eSpark-Backup/ezlo-thermostat/Design Files/4-R-layer-PCB.html

Altium customize

# Board Information Report

Date: | | 1/15/2023
Time: | | 7:51:56 PM
Elapsed Time: | | 00:00:01
Filename: | | C:\Users\XPENDER\Documents\GitHub\ezlo-thermostat\Design Files\4-R-layer-PCB.PcbDoc
Units: | | mmmils

## Contents

Contents

Board Specification

General

Routing

Routing Information

Layer Information

Layer Information

Drill Pairs

Copper Area

Copper Area

Board Holes

Non-Plated Hole Size

Plated Hole Size

Board Slots

Plated Slot Size

## Board Specification

General
Board Size | 3937.008mils x 3543.307mils
Components on board | 187

Back to top

## Routing

Routing Information
Routing completion | 100.00%
Connections | 505
Connections routed | 505
Connections remaining | 0

Back to top

## Layer Information

Layer | Arcs | Pads | Vias | Tracks | Texts | Fills | Regions | ComponentBodies
Top | 0 | 566 | 0 | 1223 | 0 | 57 | 30 | 0
PWR | 0 | 0 | 0 | 116 | 0 | 0 | 2 | 0
GND | 0 | 0 | 0 | 65 | 0 | 0 | 2 | 0
Bottom | 9 | 22 | 0 | 480 | 0 | 2 | 12 | 0
Dimension | 72 | 0 | 0 | 2 | 0 | 0 | 0 | 154
Board Outline | 4 | 0 | 0 | 21 | 0 | 0 | 0 | 0
Fabrication | 0 | 0 | 0 | 511 | 43 | 0 | 0 | 0
Mechanical 10 | 0 | 0 | 0 | 0 | 2 | 0 | 0 | 0
Mechanical 13 | 858 | 0 | 0 | 8133 | 0 | 0 | 0 | 7
Multi-Layer | 0 | 117 | 406 | 0 | 0 | 0 | 2 | 0
Top Paste | 0 | 0 | 0 | 0 | 0 | 0 | 0 | 0
Top Overlay | 3 | 0 | 0 | 987 | 401 | 20 | 4 | 0
Top Solder | 0 | 0 | 0 | 0 | 0 | 0 | 0 | 0
Bottom Solder | 0 | 0 | 0 | 0 | 0 | 0 | 0 | 0
Bottom Overlay | 0 | 0 | 0 | 3290 | 74 | 0 | 0 | 0
Bottom Paste | 0 | 0 | 0 | 0 | 0 | 0 | 0 | 0
Drill Guide | 0 | 0 | 0 | 0 | 0 | 0 | 0 | 0
Keep-Out Layer | 0 | 0 | 0 | 0 | 0 | 1 | 0 | 0
Drill Drawing | 3 | 0 | 0 | 84 | 128 | 0 | 0 | 0
Total | 949 | 705 | 406 | 14912 | 648 | 80 | 52 | 161

Back to top

Drill Pairs | Vias
Total | 0

Back to top

## Copper Area

Layer | Sq.In. | Sq.MM. | Percent of layer
Top | 6.827 | 4404.664 | 49%
PWR | 8.182 | 5278.624 | 59%
GND | 7.964 | 5137.798 | 57%
Bottom | 7.668 | 4947.076 | 55%
Total | 30.641 | 19768.162

Back to top

## Board Holes

Non-Plated Hole Size | Pads | Vias
0mils | 0 | 0
24.409mils | 0 | 0
35.433mils | 0 | 0
Total | 0 | 0

Back to top

Plated Hole Size | Pads | Vias
0mils | 0 | 0
11.811mils | 0 | 0
15.748mils | 0 | 0
31.496mils | 0 | 0
32.284mils | 0 | 0
35.433mils | 0 | 0
98.425mils | 0 | 0
Total | 0 | 0

Back to top

## Board Slots

Plated Slot Size / Length | Pads
23.622mil / 55.118mil | 0
23.622mil / 66.929mil | 0
Total | 0

Back to top
