eSpark-Backup/ezlo-thermostat/Design Files/Thermostat-PCB.html

Altium customize

# Board Information Report

Date: | | 1/6/2023
Time: | | 12:59:51 PM
Elapsed Time: | | 00:00:00
Filename: | | E:\ezlo-thermostat\Design Files\Thermostat-PCB.PcbDoc
Units: | | mmmils

## Contents

Contents

Board Specification

General

Routing

Routing Information

Layer Information

Layer Information

Drill Pairs

## Board Specification

General
Board Size | 3937.008mils x 3543.307mils
Components on board | 186

Back to top

## Routing

Routing Information
Routing completion | 99.80%
Connections | 505
Connections routed | 504
Connections remaining | 1

Back to top

## Layer Information

Layer | Arcs | Pads | Vias | Tracks | Texts | Fills | Regions | ComponentBodies
Top Layer | 0 | 566 | 0 | 1127 | 0 | 122 | 0 | 0
PWR | 4 | 0 | 0 | 20 | 0 | 2 | 1 | 0
GND | 4 | 0 | 0 | 20 | 0 | 2 | 1 | 0
Bottom Layer | 0 | 22 | 0 | 529 | 0 | 1 | 0 | 0
Mechanical 1 | 72 | 0 | 0 | 10 | 0 | 0 | 0 | 154
Mechanical 2 | 4 | 0 | 0 | 21 | 0 | 0 | 0 | 0
Mechanical 13 | 858 | 0 | 0 | 8135 | 0 | 0 | 0 | 7
Multi-Layer | 0 | 117 | 350 | 0 | 0 | 0 | 1 | 0
Top Paste | 0 | 0 | 0 | 0 | 0 | 0 | 0 | 0
Top Overlay | 3 | 0 | 0 | 976 | 330 | 20 | 0 | 0
Top Solder | 0 | 0 | 0 | 0 | 0 | 0 | 0 | 0
Bottom Solder | 0 | 0 | 0 | 0 | 0 | 0 | 0 | 0
Bottom Overlay | 0 | 0 | 0 | 220 | 44 | 0 | 0 | 0
Bottom Paste | 0 | 0 | 0 | 0 | 0 | 0 | 0 | 0
Drill Guide | 0 | 0 | 0 | 0 | 0 | 0 | 0 | 0
Keep-Out Layer | 0 | 0 | 0 | 0 | 0 | 1 | 0 | 0
Drill Drawing | 0 | 0 | 0 | 0 | 0 | 0 | 0 | 0
Total | 945 | 705 | 350 | 11058 | 374 | 148 | 3 | 161

Back to top

Drill Pairs | Vias
Total | 0

Back to top
