eSpark-Backup/ezlo-thermostat/Deliverables/Ezlo-Thermostat-v2.0-Advance/Renderings/3D_Top_View.png

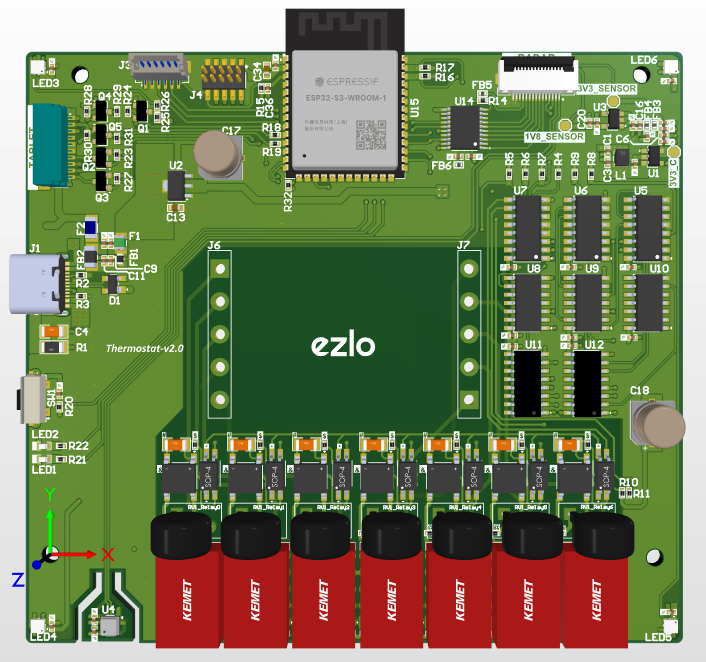
Deliverables/Ezlo-Thermostat-v2.0-Advance/Renderings/3D_Top_View.png
