eSpark-Backup/ezlo-thermostat/Deliverables/BOM/eSpark-BOM.xlsx

Sheet: 10 Boards
 |  | Component list |  | Bill of Materials for Project [Ezlo-Radar-Sensor]
 |  | Source Data From: |  | Ezlo-Radar-Sensor
 |  | Project: |  | Ezlo-Radar-Sensor
 |  | Variant: |  | None
# | Item Type | Designator | Description | Footprint | Manufacturer Part Number | Manufacturer | Alternate Part Number | LCSC Part Number | Value | Quantity | Quantity (10 Boards) | MOQ (10 Boards) | Links | Unit Cost (10 Boards) | Total Cost (10 Boards) | Remarks | Reviewer Remarks
1 | Capacitor | C1, C2, C4, C6, C8, C9, C10, C17 | CAP CER 1UF 10V X5R 0402 | Cap-0402 | CC0402KRX5R6BB105 | Yageo | - | C106254 | 1uF | 8 | 80 | 100 | LCSC (https://www.lcsc.com/product-detail/Multilayer-Ceramic-Capacitors-MLCC-SMD-SMT_YAGEO-CC0402KRX5R6BB105_C106254.html) | $0.0020 | $0.2000
2 | Capacitor | C3 | CAP CER 10000PF 25V X7R 0402 | Cap-0402 | CC0402KRX7R8BB103 | Yageo | - | C327025 | 10nF | 1 | 10 | 100 | LCSC (https://www.lcsc.com/product-detail/Multilayer-Ceramic-Capacitors-MLCC-SMD-SMT_YAGEO-CC0402KRX7R8BB103_C327025.html) | $0.0012 | $0.1200
3 | Capacitor | C5, C11 | CAP CER 22UF 10V X5R 0603 | Cap-0603 | CC0603MRX5R6BB226 | Yageo | - | C109447 | 22uF | 2 | 20 | 40 | LCSC (https://www.lcsc.com/product-detail/Multilayer-Ceramic-Capacitors-MLCC-SMD-SMT_YAGEO-CC0603MRX5R6BB226_C109447.html) | $0.0419 | $1.6760
4 | Capacitor | C7, C12, C14, C15 | CAP CER 10UF 10V X5R 0402 | Cap-0402 | CL05A106MP5NUNC | Samsung | - | C315248 | 10uF | 4 | 40 | 50 | LCSC (https://www.lcsc.com/product-detail/Multilayer-Ceramic-Capacitors-MLCC-SMD-SMT_Samsung-Electro-Mechanics-CL05A106MP5NUNC_C315248.html) | $0.0099 | $0.4950
5 | Capacitor | C13 | CAP CER 0.47UF 50V X5R 0402 | Cap-0402 | UMK105ABJ474KV-F | Taiyo Yuden | - | C386109 | 0.47uF | 1 | 10 | 20 | LCSC (https://www.lcsc.com/product-detail/Multilayer-Ceramic-Capacitors-MLCC-SMD-SMT_Taiyo-Yuden-UMK105ABJ474KV-F_C386109.html) | $0.0256 | $0.5120
6 | Capacitor | C16 | CAP CER 0.1UF 50V X7R 0402 | Cap-0402 | CL05B104KB54PNC | Samsung | - | C307331 | 0.1uF | 1 | 10 | 100 | LCSC (https://www.lcsc.com/product-detail/Multilayer-Ceramic-Capacitors-MLCC-SMD-SMT_Samsung-Electro-Mechanics-CL05B104KB54PNC_C307331.html) | $0.0066 | $0.6600
7 | Ferrite Bead | FB1, FB2, FB3, FB4, FB5, FB6, FB7 | FERRITE BEAD 120 OHM 0402 1LN | IND-0402 | BLM15PD121SN1D | Murata | - | C76891 | 100MHz | 7 | 70 | 100 | LCSC (https://www.lcsc.com/product-detail/Ferrite-Beads_Murata-Electronics-BLM15PD121SN1D_C76891.html) | $0.0057 | $0.5700
8 | FPC Connector | J1 | Clamshell 10 Bottom Contact Surface Mount 0.5mm SMD,P=0.5mm FFC/FPC Connectors ROHS | Custom | AFC01-S10FCC-00 | JUSHUO | - | C262266 | - | 1 | 10 | 61 | LCSC (https://www.lcsc.com/product-detail/FFC-FPC-Connectors_JUSHUO-AFC01-S10FCC-00_C262266.html) | $0.0915 | $5.5815
9 | MICROPHONE | Mk1 | Mic Omni-Directional -26dB 3.63V Rectangular Solder Pad T/R | Custom | ICS-43434 | TDK InvenSense |  |  |  | 1 | 10 | 11 |  |  | $0.0000
10 | Resistor | R1 | RES SMD 150 OHM 5% 1/10W 0402 | Res-0402 | ERJ-2GEJ151X | Panasonic | - | C412976 | 150R | 1 | 10 | 50 | LCSC (https://www.lcsc.com/product-detail/Chip-Resistor-Surface-Mount_PANASONIC-ERJ2GEJ151X_C412976.html) | $0.0042 | $0.2100
11 | IC | U1 | Rf Transceiver PG-VF2BGA-40 | pg-vf2bga-40 | BGT60TR13CE6327XUMA1 | Infineon | - |  | - | 1 | 10 | 11 |  |  | $0.0000
12 | IC | U2 | Integrated Gesture Recognition Sensor with I2C Interface | Custom | PAJ7620U2 | PixART Imaging Inc. |  |  |  | 1 | 10 | 11 |  |  | $0.0000
13 | Crystal | X1 | XTAL OSC XO 80.0000MHZ CMOS SMD | Custom | KC2016K80.0000C1GE00 | Kyocera AVX | - |  | 80MHz | 1 | 10 | 11 |  |  | $0.0000
 |  |  |  |  |  |  |  |  |  |  |  | Total Component Cost |  |  | $10.02
 |  |  |  |  |  |  |  |  |  |  |  | Single Board Cost |  |  | $1.00

Sheet: 1000 Boards
 |  | Component list |  | Bill of Materials for Project [Ezlo-Radar-Sensor]
 |  | Source Data From: |  | Ezlo-Radar-Sensor
 |  | Project: |  | Ezlo-Radar-Sensor
 |  | Variant: |  | None
# | Item Type | Designator | Description | Footprint | Manufacturer Part Number | Manufacturer | Alternate Part Number | LCSC Part Number | Value | Quantity | Quantity (1000 Boards) | MOQ (1000 Boards) | Links | Unit Cost (1000 Boards) | Total Cost (1000 Boards) | Remarks | Reviewer Remarks
1 | Capacitor | C1, C2, C4, C6, C8, C9, C10, C17 | CAP CER 1UF 10V X5R 0402 | Cap-0402 | CC0402KRX5R6BB105 | Yageo | - | C106254 | 1uF | 8 | 8000 | 8100 | LCSC (https://www.lcsc.com/product-detail/Multilayer-Ceramic-Capacitors-MLCC-SMD-SMT_YAGEO-CC0402KRX5R6BB105_C106254.html) | $0.0014 | $11.3400
2 | Capacitor | C3 | CAP CER 10000PF 25V X7R 0402 | Cap-0402 | CC0402KRX7R8BB103 | Yageo | - | C327025 | 10nF | 1 | 1000 | 1100 | LCSC (https://www.lcsc.com/product-detail/Multilayer-Ceramic-Capacitors-MLCC-SMD-SMT_YAGEO-CC0402KRX7R8BB103_C327025.html) | $0.0009 | $0.9900
3 | Capacitor | C5, C11 | CAP CER 22UF 10V X5R 0603 | Cap-0603 | CC0603MRX5R6BB226 | Yageo | - | C109447 | 22uF | 2 | 2000 | 2060 | LCSC (https://www.lcsc.com/product-detail/Multilayer-Ceramic-Capacitors-MLCC-SMD-SMT_YAGEO-CC0603MRX5R6BB226_C109447.html) | $0.0312 | $64.2720
4 | Capacitor | C7 | CAP CER 10UF 10V X5R 0603 | Cap-0603 | CC0603KRX5R6BB106 | Yageo | - | C326057 | 10uF | 1 | 1000 | 1060 | LCSC (https://www.lcsc.com/product-detail/Multilayer-Ceramic-Capacitors-MLCC-SMD-SMT_YAGEO-CC0603KRX5R6BB106_C326057.html) | $0.0173 | $18.3380
5 | Capacitor | C12, C14, C15 | CAP CER 10UF 10V X5R 0402 | Cap-0402 | CL05A106MP5NUNC | Samsung | - | C315248 | 10uF | 3 | 3000 | 3050 | LCSC (https://www.lcsc.com/product-detail/Multilayer-Ceramic-Capacitors-MLCC-SMD-SMT_Samsung-Electro-Mechanics-CL05A106MP5NUNC_C315248.html) | $0.0068 | $20.7400
6 | Capacitor | C13 | CAP CER 0.47UF 50V X5R 0402 | Cap-0402 | UMK105ABJ474KV-F | Taiyo Yuden | - | C386109 | 0.47uF | 1 | 1000 | 1080 | LCSC (https://www.lcsc.com/product-detail/Multilayer-Ceramic-Capacitors-MLCC-SMD-SMT_Taiyo-Yuden-UMK105ABJ474KV-F_C386109.html) | $0.0178 | $19.2564
7 | Capacitor | C16 | CAP CER 0.1UF 50V X7R 0402 | Cap-0402 | CL05B104KB54PNC | Samsung | - | C307331 | 0.1uF | 1 | 1000 | 1100 | LCSC (https://www.lcsc.com/product-detail/Multilayer-Ceramic-Capacitors-MLCC-SMD-SMT_Samsung-Electro-Mechanics-CL05B104KB54PNC_C307331.html) | $0.0056 | $6.1600
8 | Ferrite Bead | FB1, FB2, FB3, FB4, FB5, FB6, FB7 | FERRITE BEAD 120 OHM 0402 1LN | IND-0402 | BLM15PD121SN1D | Murata | - | C76891 | 100MHz | 7 | 7000 | 7100 | LCSC (https://www.lcsc.com/product-detail/Ferrite-Beads_Murata-Electronics-BLM15PD121SN1D_C76891.html) | $0.0041 | $29.1100
9 | FPC Connector | J1 | Clamshell 10 Bottom Contact Surface Mount 0.5mm SMD,P=0.5mm FFC/FPC Connectors ROHS | Custom | AFC01-S10FCC-00 | JUSHUO | - | C262266 | - | 1 | 1000 | 1098 | LCSC (https://www.lcsc.com/product-detail/FFC-FPC-Connectors_JUSHUO-AFC01-S10FCC-00_C262266.html) | $0.0744 | $81.6912
10 | MICROPHONE | Mk1 | Mic Omni-Directional -26dB 3.63V Rectangular Solder Pad T/R | Custom | ICS-43434 | TDK InvenSense |  |  |  | 1 | 1000 |  |  |  | $0.0000
11 | Resistor | R1 | RES SMD 150 OHM 5% 1/10W 0402 | Res-0402 | ERJ-2GEJ151X | Panasonic | - | C412976 | 150R | 1 | 1000 | 1050 | LCSC (https://www.lcsc.com/product-detail/Chip-Resistor-Surface-Mount_PANASONIC-ERJ2GEJ151X_C412976.html) | $0.0035 | $3.6750
12 | IC | U1 | Rf Transceiver PG-VF2BGA-40 | pg-vf2bga-40 | BGT60TR13CE6327XUMA1 | Infineon | - |  | - | 1 | 1000 |  |  |  | $0.0000
13 | IC | U2 | Integrated Gesture Recognition Sensor with I2C Interface | Custom | PAJ7620U2 | PixART Imaging Inc. |  |  |  | 1 | 1000 |  |  |  | $0.0000
14 | Crystal | X1 | XTAL OSC XO 80.0000MHZ CMOS SMD | Custom | KC2016K80.0000C1GE00 | Kyocera AVX | - |  | 80MHz | 1 | 1000 |  |  |  | $0.0000
 |  |  |  |  |  |  |  |  |  |  |  | Total Component Cost |  |  | $255.57
 |  |  |  |  |  |  |  |  |  |  |  | Single Board Cost |  |  | $25.56
