eSpark-Backup/ezlo-thermostat/Design Files/Ezlo-Radar-Sensor-v2.0-Advance/BOM/Client_BOM.xlsx

# | Item Type | Designator | Description | Footprint | Manufacturer Part Number | Manufacturer | Value | Quantity | Remarks
1 | Capacitor | C1, C2, C4, C6, C8, C9, C10, C17, C22 | CAP CER 1UF 10V X5R 0402 | Cap-0402 | CC0402KRX5R6BB105 | Yageo | 1uF | 9
2 | Capacitor | C3 | CAP CER 10000PF 25V X7R 0402 | Cap-0402 | CC0402KRX7R8BB103 | Yageo | 10nF | 1
3 | Capacitor | C5, C11, C18 | CAP CER 22UF 10V X5R 0603 | Cap-0603 | CC0603MRX5R6BB226 | Yageo | 22uF | 3
4 | Capacitor | C7, C12, C14, C15, C19 | CAP CER 10UF 10V X5R 0402 | Cap-0402 | CL05A106MP5NUNC | Samsung | 10uF | 5
5 | Capacitor | C13 | CAP CER 0.47UF 50V X5R 0402 | Cap-0402 | UMK105ABJ474KV-F | Taiyo Yuden | 0.47uF | 1
6 | Capacitor | C16, C20, C21, C23 | CAP CER 0.1UF 50V X7R 0402 | Cap-0402 | CL05B104KB54PNC | Samsung | 0.1uF | 4
7 | Ferrite Bead | FB1, FB2, FB3, FB4, FB5, FB6, FB7 | FERRITE BEAD 120 OHM 0402 1LN | IND-0402 | BLM15PD121SN1D | Murata | 100MHz | 7
8 | FPC Connector | J1 | Clamshell 15 Bottom Contact Surface Mount 0.5mm SMD,P=0.5mm FFC/FPC Connectors ROHS | - | AFC01-S15FCC-00 | JUSHUO | - | 1
9 | MICROPHONE | Mk1 | Mic Omni-Directional -26dB 3.63V Rectangular Solder Pad T/R | - | ICS-43434 | TDK InvenSense | - | 1
10 | Resistor | R1 | RES SMD 150 OHM 5% 1/10W 0402 | Res-0402 | ERJ-2GEJ151X | Panasonic | 150R | 1
11 | IC | U1 | Rf Transceiver PG-VF2BGA-40 | pg-vf2bga-40 | BGT60TR13CE6327XUMA1 | Infineon | - | 1
12 | IC | U2 | Integrated Gesture Recognition Sensor with I2C Interface | - | PAJ7620U2 | PixART Imaging Inc. | - | 1
13 | Crystal | X1 | XTAL OSC XO 80.0000MHZ CMOS SMD | - | KC2016K80.0000C1GE00 | Kyocera AVX | 80MHz | 1
14 | peripheral | - | 15 0.5mm Same Side 120mm P=0.5mm FFC/FPC Connect Cables ROHS | - | KH-FFC-A0.5-15P-120MM | Shenzhen Kinghelm Elec | - | 1
