eSpark-Backup/ezlo-thermostat/Design Files/Ezlo-Thermostat-v2.0-Advance/BOM/Client_BOM.xlsx

# | Item Type | Designator | Description | Footprint | Manufacturer Part Number | Manufacturer | Value | Quantity | Remarks
1 | Bridge Rectifier | BR1_Relay0, BR1_Relay1, BR1_Relay2, BR1_Relay3, BR1_Relay4, BR1_Relay5, BR1_Relay6 | 5uA@1kV 1V@0.4A 1A 1kV -55℃~+150℃@(Tj) ABS Bridge Rectifiers ROHS | ABS | ABS10 | FOSAN | - | 7
2 | Capacitor | C1, C3, C6, C16, C20 | CAP CER 10UF 10V X5R 0402 | Cap-0402 | CC0402MRX5R6BB106 | Yageo | 10uF | 5
3 | Capacitor | C2, C5, C7, C8, C10, C12, C14, C15, C19, C21, C22, C23, C24, C25, C26, C27, C28, C29, C30, C32, C33, C35, C37, C38, C39, C40, C41 | CAP CER 0.1UF 25V X5R 0402 | Cap-0402 | CC0402KRX5R8BB104 | Yageo | 100nF | 27
4 | Capacitor | C4 | CAP CER 4700PF 50V C0G/NPO 1206 | Cap-1206 | CC1206GRNPO9BN472 | Yageo | 4.7nF | 1
5 | Capacitor | C9, C11 | CAP CER 10000PF 25V X5R 0402 | Cap-0402 | CC0402KRX5R8BB103 | Yageo | 0.01uF | 2
6 | Capacitor | C13 | CAP CER 10UF 16V X5R 0603 | Cap-0603 | CC0603KRX5R7BB106 | Yageo | 10uF | 1
7 | Capacitor | C17, C18 | CAP ALUM 100UF 20% 10V SMD | Custom | UCD1A101MCL1GS | Nichicon | 100uF | 2
8 | Capacitor | C31_Relay0, C31_Relay1, C31_Relay2, C31_Relay3, C31_Relay4, C31_Relay5, C31_Relay6 | 50V 220nF X7R ±10% 1206 Multilayer Ceramic Capacitors MLCC - SMD/SMT ROHS | Cap-1206 | 1206B224K500NT | FH | 220nF | 7
9 | Capacitor | C34 | CAP CER 22UF 6.3V X5R 0603 | Cap-0603 | CC0603MRX5R5BB226 | Yageo | 22uF | 1
10 | Capacitor | C36 | CAP CER 1UF 25V X5R 0402 | Cap-0402 | CC0402KRX5R8BB105 | Yageo | 1uF | 1
11 | Diode | D1 | ESD Suppressor TVS 5.5V 4-Pin(3+Tab) SOT-143 T/R | SOT-143-4_ | SP0503BAHTG | Littelfuse | - | 1
12 | Fuse | F1 | 6V 1A 100A 1.95A 300ms 0805 Resettable Fuses ROHS | Fuse-0805 | JK-SMD0805-100 | Jinrui Electronic Materials Co. | - | 1
13 | Fuse | F2 | 6V 2A 100A 0.8W 3.5A -40℃~+85℃ 0.018Ω 1.5s 0.08Ω 1206 Resettable Fuses ROHS | Fuse 1206 (3216 Metric) | SMD1206K200SF6V | KAILONG | - | 1
14 | Ferrite Bead | FB1 | FERRITE BEAD 120 OHM 0603 1LN | IND-0603 (1608 Metric) | BLM18SG121TN1D | Murata | - | 1
15 | Ferrite Bead | FB2 | FERRITE BEAD 120 OHM 1206 1LN | IND-1206 | BLM31PG121SN1L | Murata | 100MHz | 1
16 | Ferrite Bead | FB3, FB4, FB5, FB6 | FERRITE BEAD 120 OHM 0402 1LN | IND-0402 | BLM15PD121SN1D | Murata | 100MHz | 4
17 | USB Connector | J1 | 250mA 1 16 Female Type-C SMD USB Connectors ROHS | Custom | TYPE-C-31-M-12 | Korean Hroparts Elec | - | 1
18 | FPC Connector | J2 | Clamshell 15 Bottom Contact Surface Mount 0.5mm SMD,P=0.5mm FFC/FPC Connectors ROHS | Custom | AFC01-S15FCC-00 | JUSHUO | - | 1
19 | Connector | J3 | 1x6P SH 1 1mm 6 SMD,P=1mm Wire To Board / Wire To Wire Connector ROHS | Custom | C145963 | BOOMELE | - | 1
20 | Jtag Header | J4 | CONN HEADER SMD 10POS 1.27MM | Custom | 20021121-00010C4LF | Amphenol FCI | - | 1
21 | JST Connector | J5 | CONN HEADER SMD R/A 10POS 1MM | Custom | SM10B-SRSS-TB(LF)(SN) | JST | - | 1
22 | Header | J6 | PinHeader_1x05_P5.00mm_Vertical | Custom | - |  | - | 1
23 | Header | J7 | PinHeader_1x05_P5.00mm_Vertical | Custom | - |  | - | 1
24 | Relay | K1_Relay0, K1_Relay1, K1_Relay2, K1_Relay3, K1_Relay4, K1_Relay5, K1_Relay6 | Relay Gen Purpose DPDT 1A 3VDC | Custom | EA2-3TNU | KEMET | - | 7
25 | Inductor | L1 | FIXED IND 10UH 1A 540 MOHM SMD | IND-1008 (2520 Metric) | VLS252012HBX-100M-1 | TDK | 10uH | 1
26 | LED | LED1 | Red 632nm LED Indication - Discrete 2.05V 0603 (1608 Metric) | LED-0603 | 19-21/R7C-AK1L2BY/3T | Everlight Elec | - | 1
27 | LED | LED2 | Yellow-Green 572nm LED Indication - Discrete 2.05V 0603 (1608 Metric) | LED-0603 | 19-21/G6C-FM1N2B/3T | Everlight Elec | - | 1
28 | RGB LED | LED3, LED4, LED5, LED6 | 5mA -40℃~+80℃ RGB SMD,2x2mm Light Emitting Diodes (LED) ROHS | Custom | SK6812-EC20 | OPSCO Optoelectronics | - | 4
29 | ~~Test Point~~ | ~~P1, P2, P3, P4, P5, P6, P7, P8, P9, P10, P11, P12, P13, P14, P15, P16, P17, P18, P19, P20, P21, P22, P23, P24, P25~~ | ~~Test Point ON~~ | ~~Custom~~ | ~~Test-point~~ |  | ~~-~~ | ~~25~~
30 | Mosfet | Q1, Q2, Q3, Q4, Q5 | N-CHANNEL 20-V (D-S) MOSFET | Sot-23 | SI2302CDS | TECH PUBLIC | - | 5
31 | Resistor | R1 | RES 1M OHM 1% 1/4W 1206 | Res-1206 | RC1206FR-071ML | Yageo | 1M | 1
32 | Resistor | R2, R3 | RES 5.1K OHM 1% 1/16W 0402 | Res-0402 | RC0402FR-075K1L | Yageo | 5.1K | 2
33 | Resistor | R4, R5, R6, R7, R8, R9, R10, R15, R20, R23, R27, R32 | RES 220K OHM 1% 1/16W 0402 | Res-0402 | RC0402FR-07220KL | Yageo | 220K | 12
34 | Resistor | R11 | RES 47K OHM 1% 1/16W 0402 | Res-0402 | RC0402FR-0747KL | Yageo | 47K | 1
35 | Resistor | R12_Relay0, R12_Relay1, R12_Relay2, R12_Relay3, R12_Relay4, R12_Relay5, R12_Relay6 | RES 47 OHM 1% 1/16W 0402 | Res-0402 | RC0402FR-0747RL | Yageo | 47R | 7
36 | Resistor | R13_Relay0, R13_Relay1, R13_Relay2, R13_Relay3, R13_Relay4, R13_Relay5, R13_Relay6 | RES 100K OHM 1% 1/16W 0402 | Res-0402 | RC0402FR-07100KL | Yageo | 100K | 7
37 | Resistor | R14 | RES 0 OHM JUMPER 1/16W 0402 | Res-0402 | RC0402FR-070RL | Yageo | 0R | 1
38 | Resistor | R16, R17 | RES 4.7K OHM 1% 1/16W 0402 | Res-0402 | RC0402FR-074K7L | Yageo | 4.7K | 2
39 | Resistor | R18, R19 | RES 22 OHM 1% 1/16W 0402 | Res-0402 | RC0402FR-0722RL | Yageo | 22R | 2
40 | Resistor | R21, R22, R26 | RES 1K OHM 1% 1/16W 0402 | Res-0402 | RC0402FR-071KL | Yageo | 1K | 3
41 | Resistor | R24, R25, R28, R29, R30, R31 | RES 10K OHM 1% 1/16W 0402 | Res-0402 | RC0402FR-0710KL | Yageo | 10K | 6
42 | Varistor | RV1_Relay0, RV1_Relay1, RV1_Relay2, RV1_Relay3, RV1_Relay4, RV1_Relay5, RV1_Relay6 | VARISTOR 68V 500A DISC 7MM | Custom | ERZ-V07D680 | Panasonic | - | 7
43 | Tactile Switch | SW1 | 3.5mm 3.5mm SMDSplicing Black Rectangle button 50mA Surface Mount 7mm SPST 100MΩ 20000 12V 250gf@±50gf SMD Tactile Switches ROHS | Custom | YTS-B003-2A | YIYUAN | - | 1
44 | IC | U1 | Linear Voltage Regulator IC Positive Fixed 1 Output 3.3V 1A SOT-25 | SOT-25-5 | XC6220B331MR-G | Torex | - | 1
45 | IC | U2 | 600mA 60dB 500mV@(600mA) Fixed 3.3V~3.3V Positive 1 7V SOT-89(SOT-89-3) Linear Voltage Regulators (LDO) ROHS | SOT-89-3 | LR1107G-33-AB3-C-R | UTC(Unisonic Tech) | - | 1
46 | IC | U3 | 300mA 80dB@(1kHz) 410mV@(300mA) Fixed 1.8V~1.8V Positive 1 5.5V SOT-25-5 Linear Voltage Regulators (LDO) ROHS | SOT-25-5 | XC6228D182VR-G | Torex Semicon | - | 1
47 | Temperature Sensor | U4 | SENSOR RH PRESSURE TEMP VOC | BME680 | BME680 | Bosch Sensortec | - | 1
48 | IC | U5, U6, U7 | IC DECODER/DEMUX 3-8 INV 16SOIC | 16-SOIC | 74LVC138AD,118 | Nexperia | - | 3
49 | IC | U8, U9, U10 | SOIC-14 Inverters ROHS | 14-SOIC | SN74LV14AD | Texas Instruments | - | 3
50 | IC | U11, U12 | 100uA@50V 3V@2V,300mA 1.6V@350mA 4mA@12V 100uA@50V 1.25V@350mA 500mA 25pF SOP-16_150mil Darlington Transistor Arrays ROHS | SOP-16_150mil | ULN2003A | Mixic | - | 2
51 | Optocoupler | U13_Relay0, U13_Relay1, U13_Relay2, U13_Relay3, U13_Relay4, U13_Relay5, U13_Relay6 | 80V 3750V 2us@2mA,100Ω -55℃~+125℃ 50mA 3us@2mA,100Ω 0.4V@2.4mA,8mA 1 6V 1.2V Phototransistor DC SOP-4-2.6mm Optocouplers - Phototransistor Output ROHS | SOP-4-1.27mm pitch Body 2.6mm | OR-3H7B-TP-G | Orient | - | 7
52 | IC | U14 | IC TRANSLATOR BIDIR 20TSSOP | TSSOP-20 | TXS0108EPWR | Texas Instruments | - | 1
53 | Module | U15 | SMD MODULE, ESP32-S3R8 WITH 3.3V | 41-SMD Module | ESP32-S3-WROOM-1-N16R8 | Espressif Systems | - | 1
54 | Peripheral | - |  |  | Tablet |  |  | 1
55 | Peripheral | - |  |  | Camera |  |  | 2
56 | Peripheral | - | JUMPER 10SR-3S - 10SR-3S 4" | - | A10SR10SR30K102A | JST Sales America Inc. | - | 1
