eSpark-Backup/ezlo-thermostat/Deliverables/Ezlo-Radar-Sensor-v2.0-Advance/Supporting Files/eZlo_Radar.step

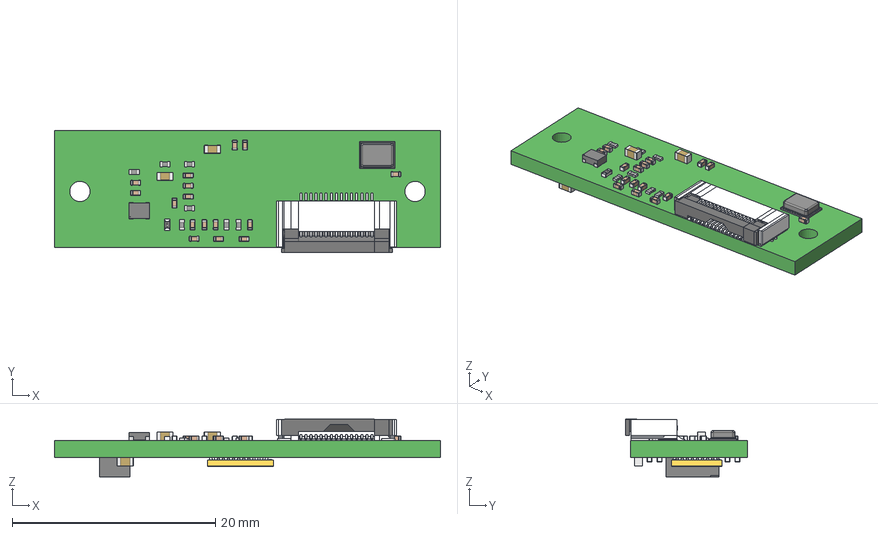
[picture p9: CAD file, 2023-07-26]
Deliverables/Ezlo-Radar-Sensor-v2.0-Advance/Supporting Files/eZlo_Radar.step
38.0 x 12.0 x 5.68 mm
PAJ620U2
User Library-Capacitor 0402 x 20
User Library-CAPC1608X09 x 3
KC2016K_KYO
User Library-RES_1005-0402
JUSHUO AFC01-S15FCC-00
User Library-d0402h025 x 7
