eSpark-Backup/ezlo-thermostat/Deliverables/Ezlo-Thermostat-v2.0-Advance/Supporting Files/PCB-Thermostat.step

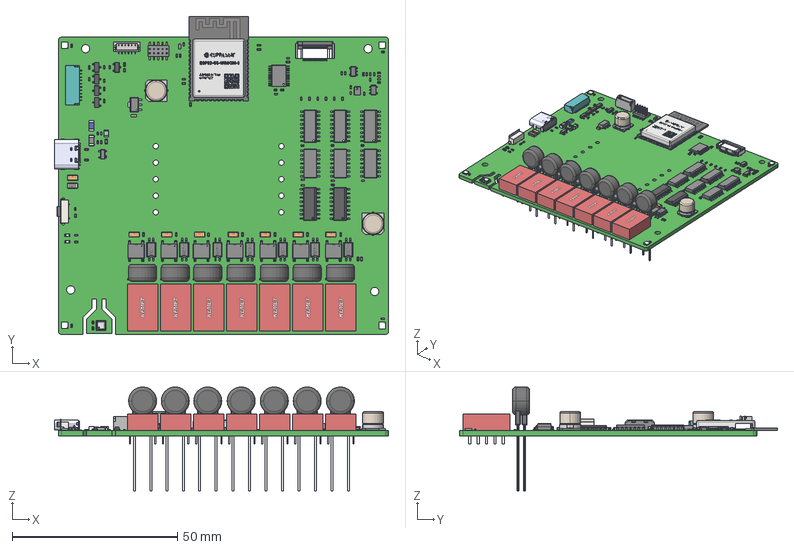
[picture p10: CAD file, 2023-07-26]
Deliverables/Ezlo-Thermostat-v2.0-Advance/Supporting Files/PCB-Thermostat.step
101.2 x 96.2 x 31.5 mm
User_Library-RES_1005-0402 x 43
User_Library-Capacitor_0402 x 35
ERZ-V07D6802 x 7
EA2-3TNU x 7
BLM31PG121SN1L
TYPE-C-31-M-12
SP0503BAHTG--3DModel-STEP-56544_(1)
User_Library-LED_SMD0603 x 2
UCD1A101MCL1GS3 x 2
User_Library-fuse0805L050WR
SOLID.step.STEP.dwg.STEP.STEP.dwg
User_Library-1206_SMD_Capacitor x 8
User_Library-1206_SMD_Resistor
User_Library-CAPC1608X09 x 2
ESP-S3-WROOM_via_v3 x 26
ESP32-S3-WROOM_shell_v11
ESP32-S3-WROOM_body_v12
ESP-S3-WROOM_via_v3(\X2\955C50CF\X0\) x 14
TXS0108EPWR
User_Library-SOP-4-1 x 7
User_Library-SOIC127P600X175-16 x 2
SN74LV14AD x 3
MAX14850ASE+ x 3
BME680--3DModel-STEP-56544
User_Library-sot25 x 2
User_Library_SOT89_5005
Switch
CircuitWorks-SOT-23 x 5
OPSCO-Optoelectronics-SK6812-EC20_C2909058 x 4
VLS252012HBX-100M
Conn_JST_SM10B-SRSS-TB_LF_SN_eec
User_Library-RM127_10pin_Header
JUSHUO_AFC01-S15FCC-00
User_Library-d0402h025 x 4
Lötende x 2
base
0685H9150-01
