eSpark-Backup/ezlo-thermostat/docs/Client Original Design/Radar Sensor PCB revA Kicad/3D/radar revA.step

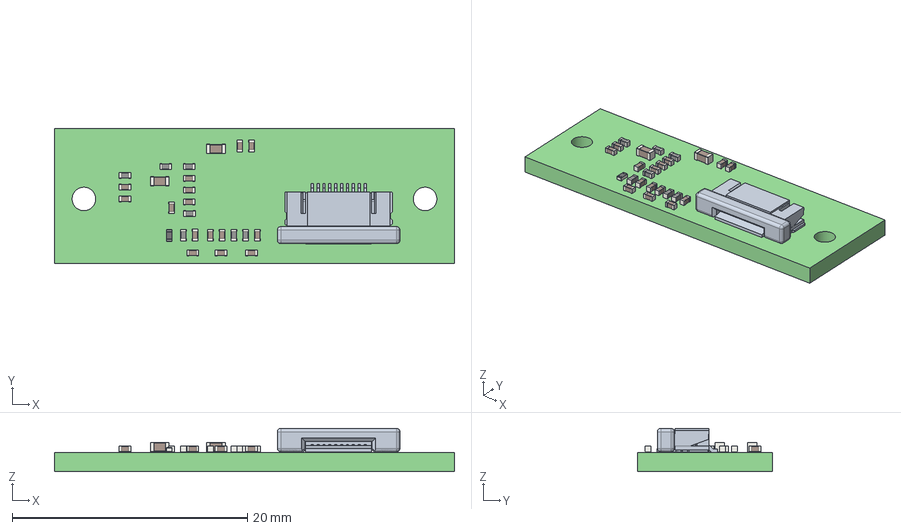
[picture p11: CAD file, 2022-12-19]
docs/Client Original Design/Radar Sensor PCB revA Kicad/3D/radar revA.step
34.0 x 11.5 x 3.70 mm
radar PCB
