eSpark-Backup/ezlo-thermostat/(list of files, cad)

Other CAD files:
Deliverables/Supporting_files/eZlo_Radar-v2.0-Advance.step
Design Files/Ezlo-Thermostat-v2.0-Advance/PCB-Thermostat.step
Deliverables/Supporting_files/PCB-Thermostat.DWG.DWG
Deliverables/Supporting_files/PCB-Thermostat.step
Deliverables/Supporting_files/Thermostat-PCB.step
Deliverables/Ezlo-Radar-Sensor-v2.0-Advance/Supporting Files/eZlo_Radar.DWG
Deliverables/Ezlo-Radar-Sensor-v2.0-Advance/Supporting Files/eZlo_Radar.DXF
Deliverables/Ezlo-Thermostat-v2.0-Advance/Supporting Files/PCB-Thermostat.DWG
Deliverables/Supporting_files/PCB-Thermostat.DWG
Deliverables/Supporting_files/PCB-Thermostat.DXF
Deliverables/Supporting_files/Thermostat-PCB.DWG
Deliverables/Supporting_files/Thermostat-PCB.DXF
