eSpark-Backup/ezlo-thermostat/Design Files/Ezlo-Thermostat-v2.0-Advance/ezlo-thermostat-advance-v2.0.pdf

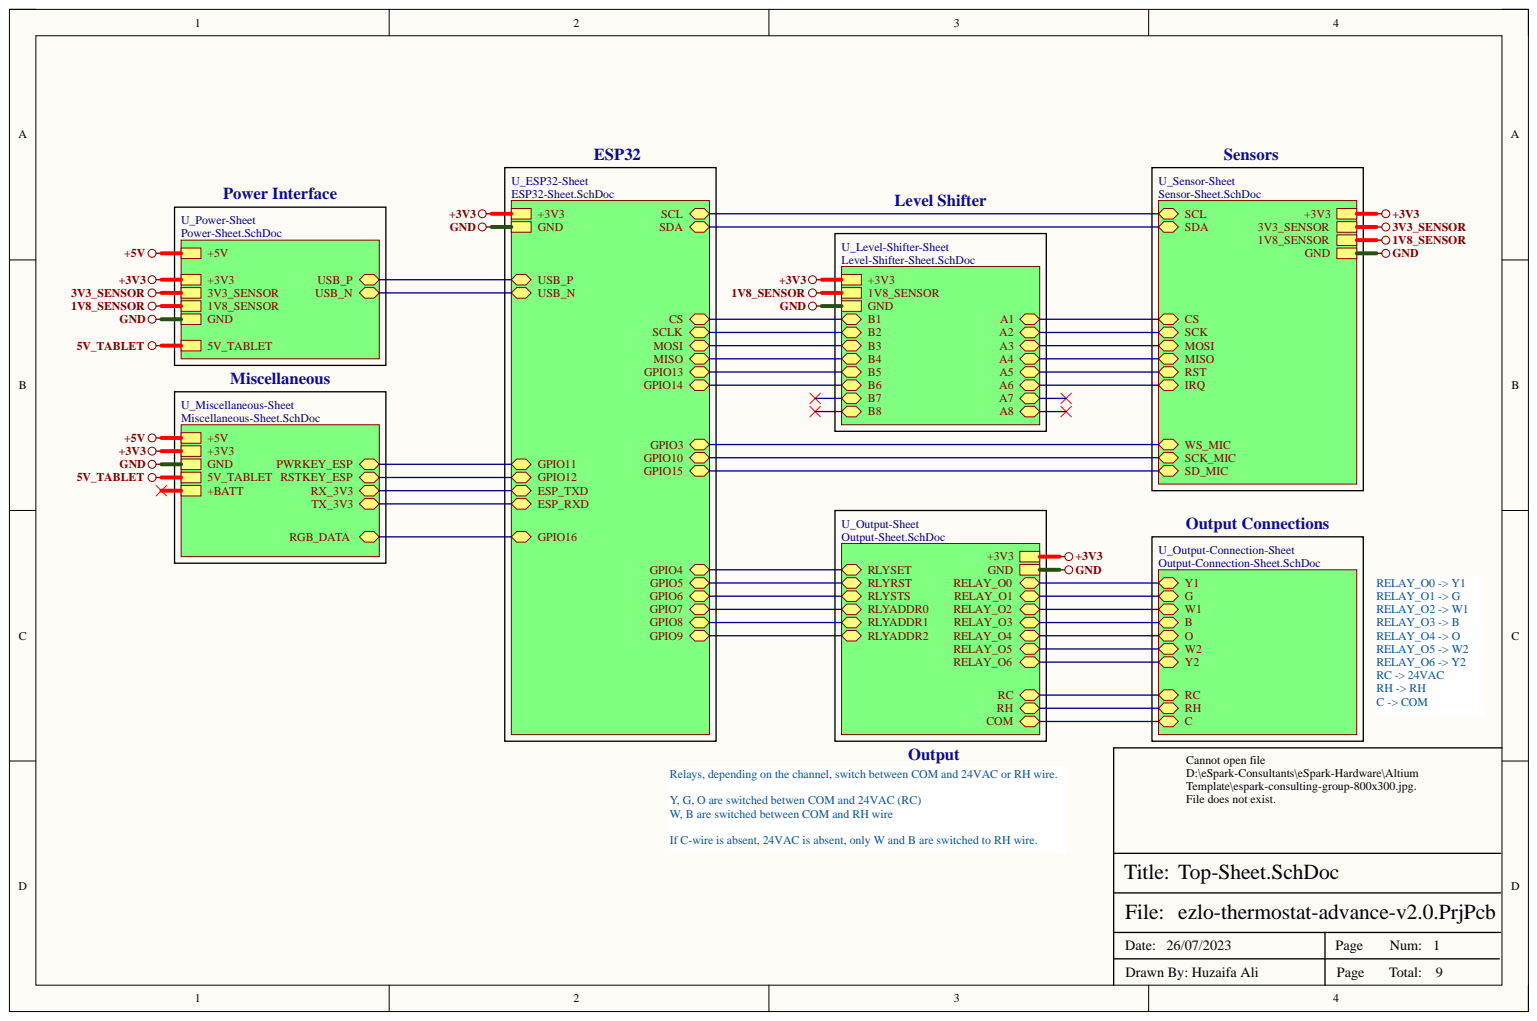
[picture p43: page 1]

Cannot open file
D:\eSpark-Consultants\eSpark-Hardware\Altium
Template\espark-consulting-group-800x300.jpg.
File does not exist.

Relays, depending on the channel, switch between COM and 24VAC or RH wire.

Y, G, O are switched betwen COM and 24VAC (RC)
W, B are switched between COM and RH wire

If C-wire is absent, 24VAC is absent, only W and B are switched to RH wire.

ezlo-thermostat-advance-v2.0.PrjPcb

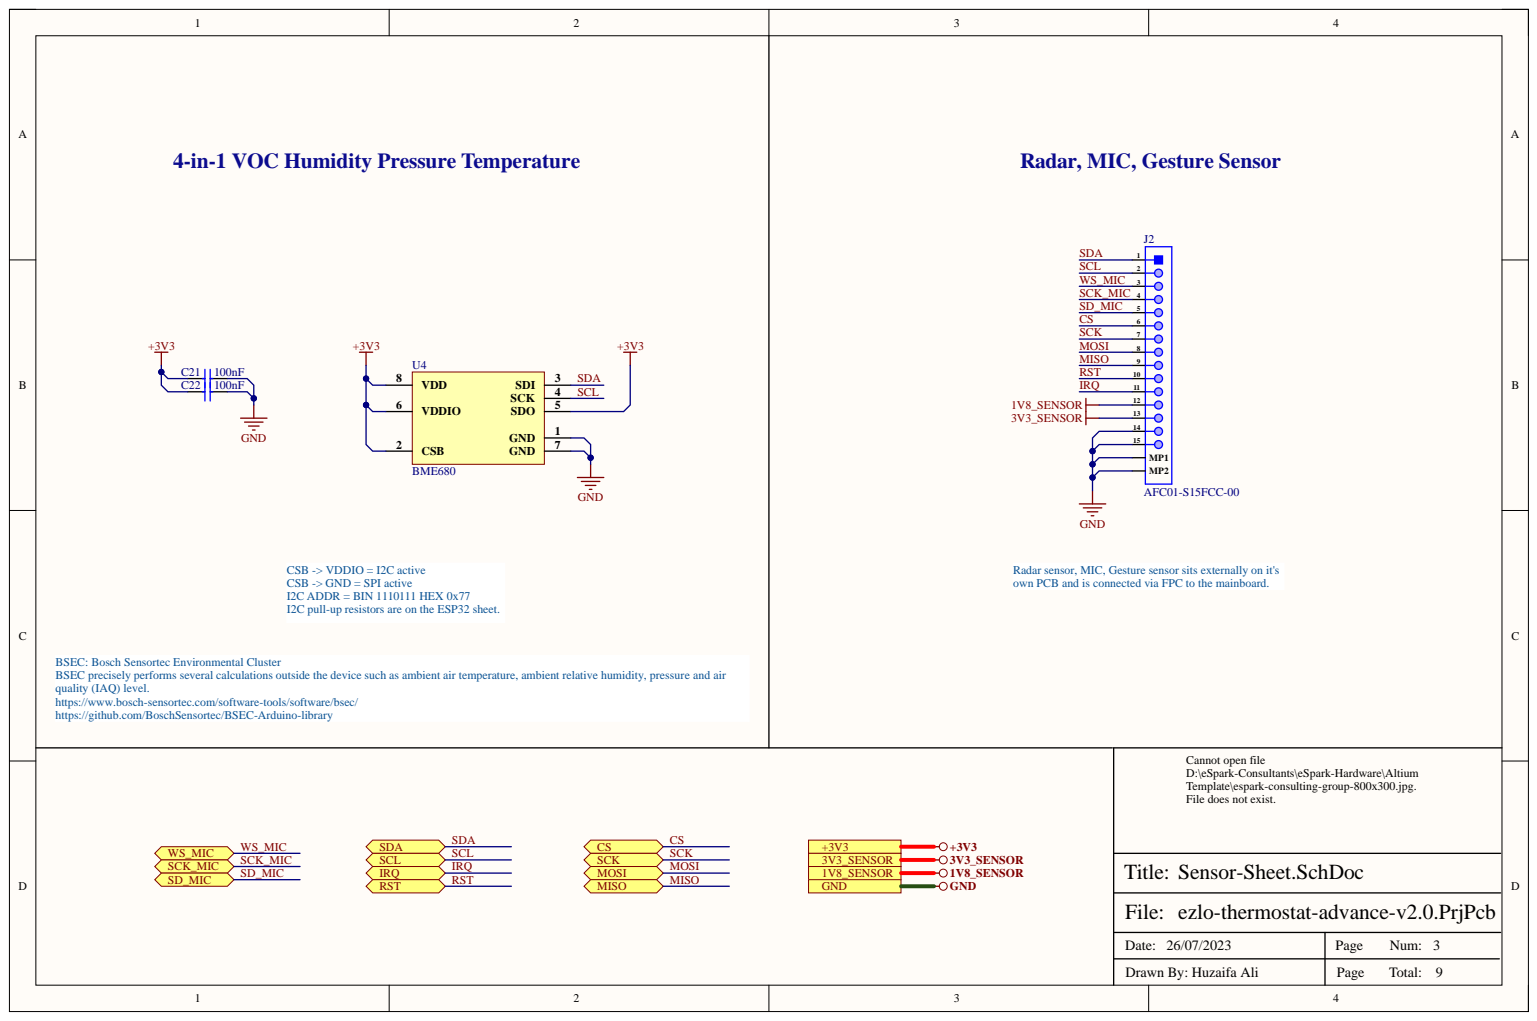
[picture p44: page 2]

CSB -> VDDIO = I2C active
CSB -> GND = SPI active
I2C ADDR = BIN 1110111 HEX 0x77
I2C pull-up resistors are on the ESP32 sheet.

Radar sensor, MIC, Gesture sensor sits externally on it's
own PCB and is connected via FPC to the mainboard.

BSEC: Bosch Sensortec Environmental Cluster
BSEC precisely performs several calculations outside the device such as ambient air temperature, ambient relative humidity, pressure and air
quality (IAQ) level.
https://www.bosch-sensortec.com/software-tools/software/bsec/
https://github.com/BoschSensortec/BSEC-Arduino-library

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

ezlo-thermostat-advance-v2.0.PrjPcb

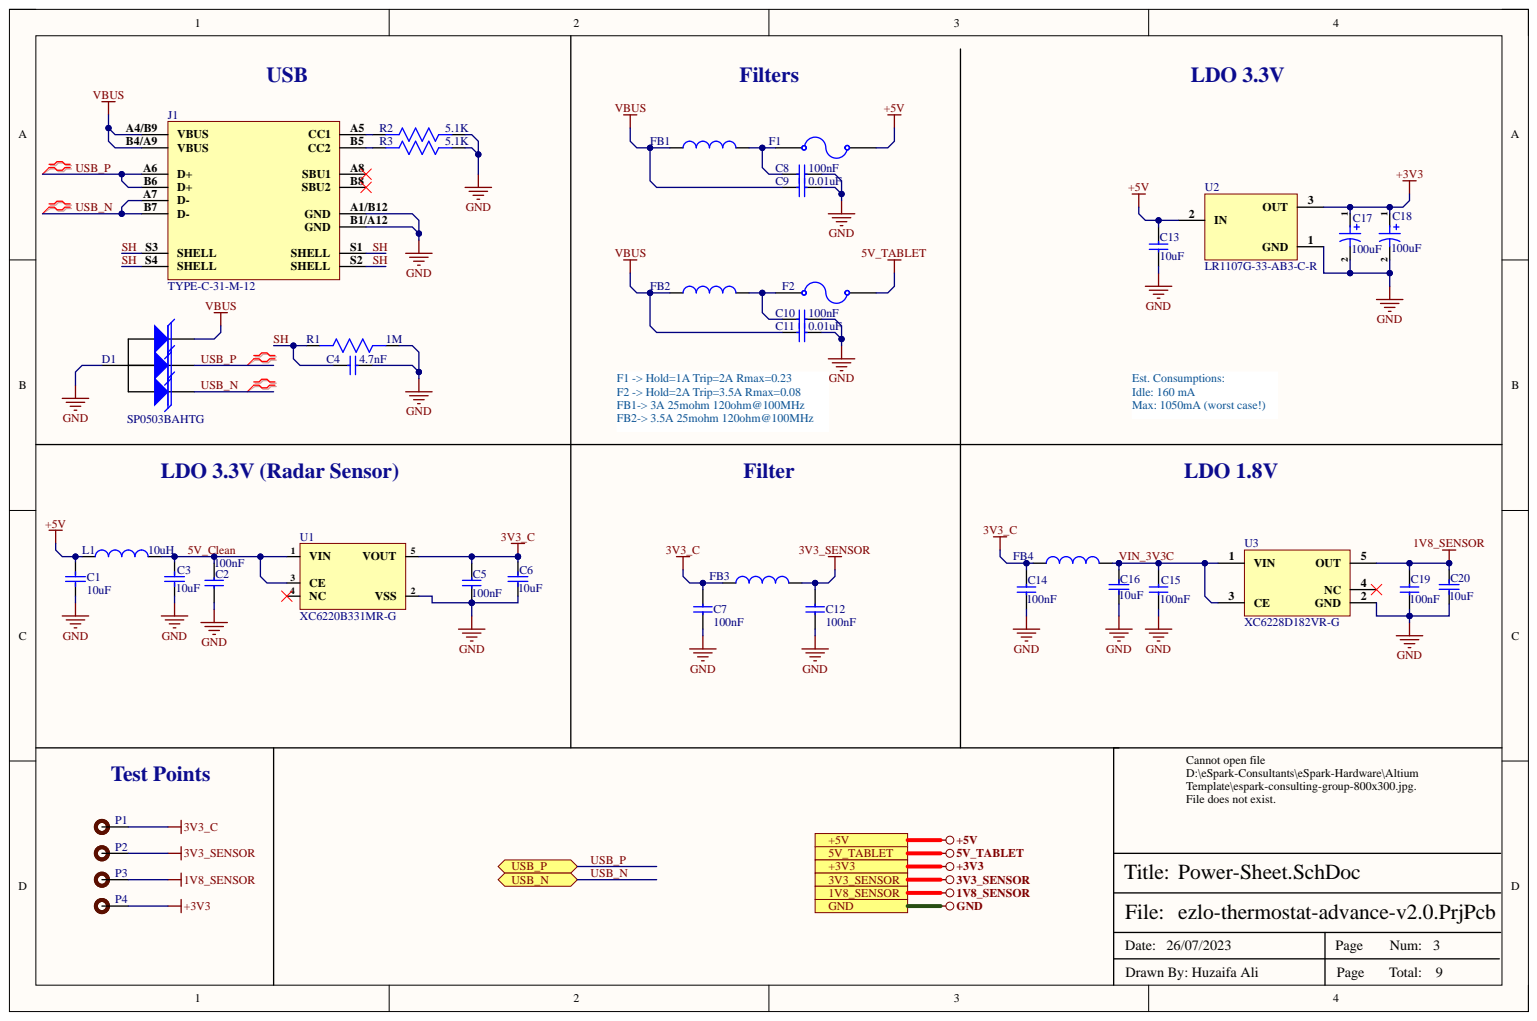
[picture p45: page 3]
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

ezlo-thermostat-advance-v2.0.PrjPcb

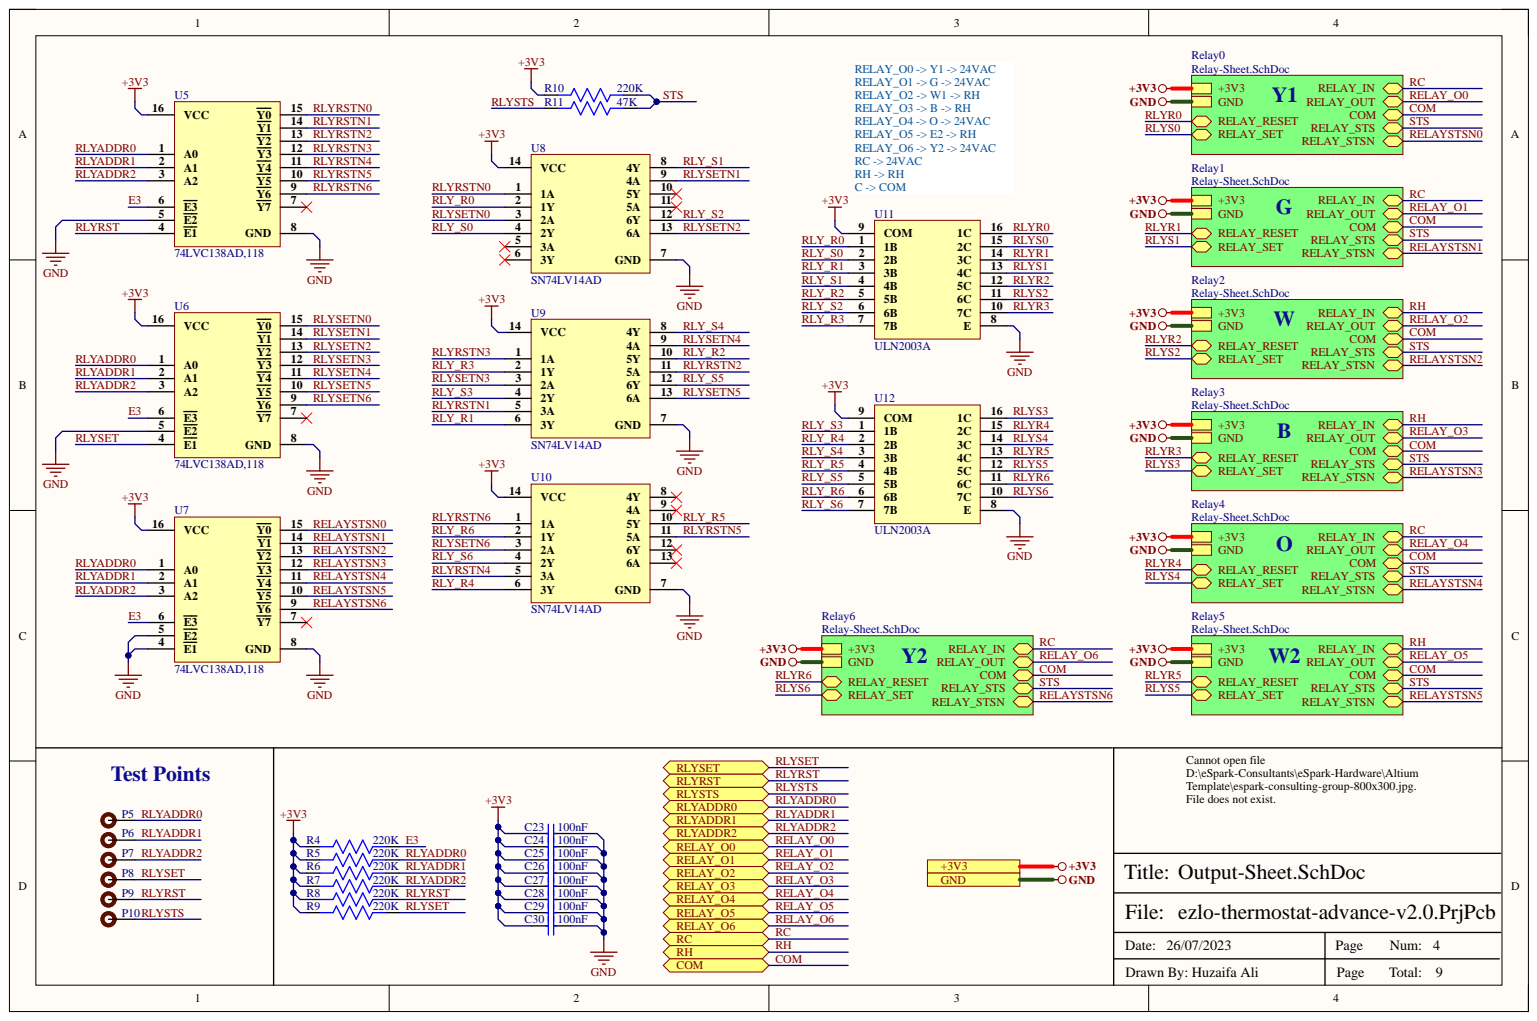
[picture p46: page 4]
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

ezlo-thermostat-advance-v2.0.PrjPcb

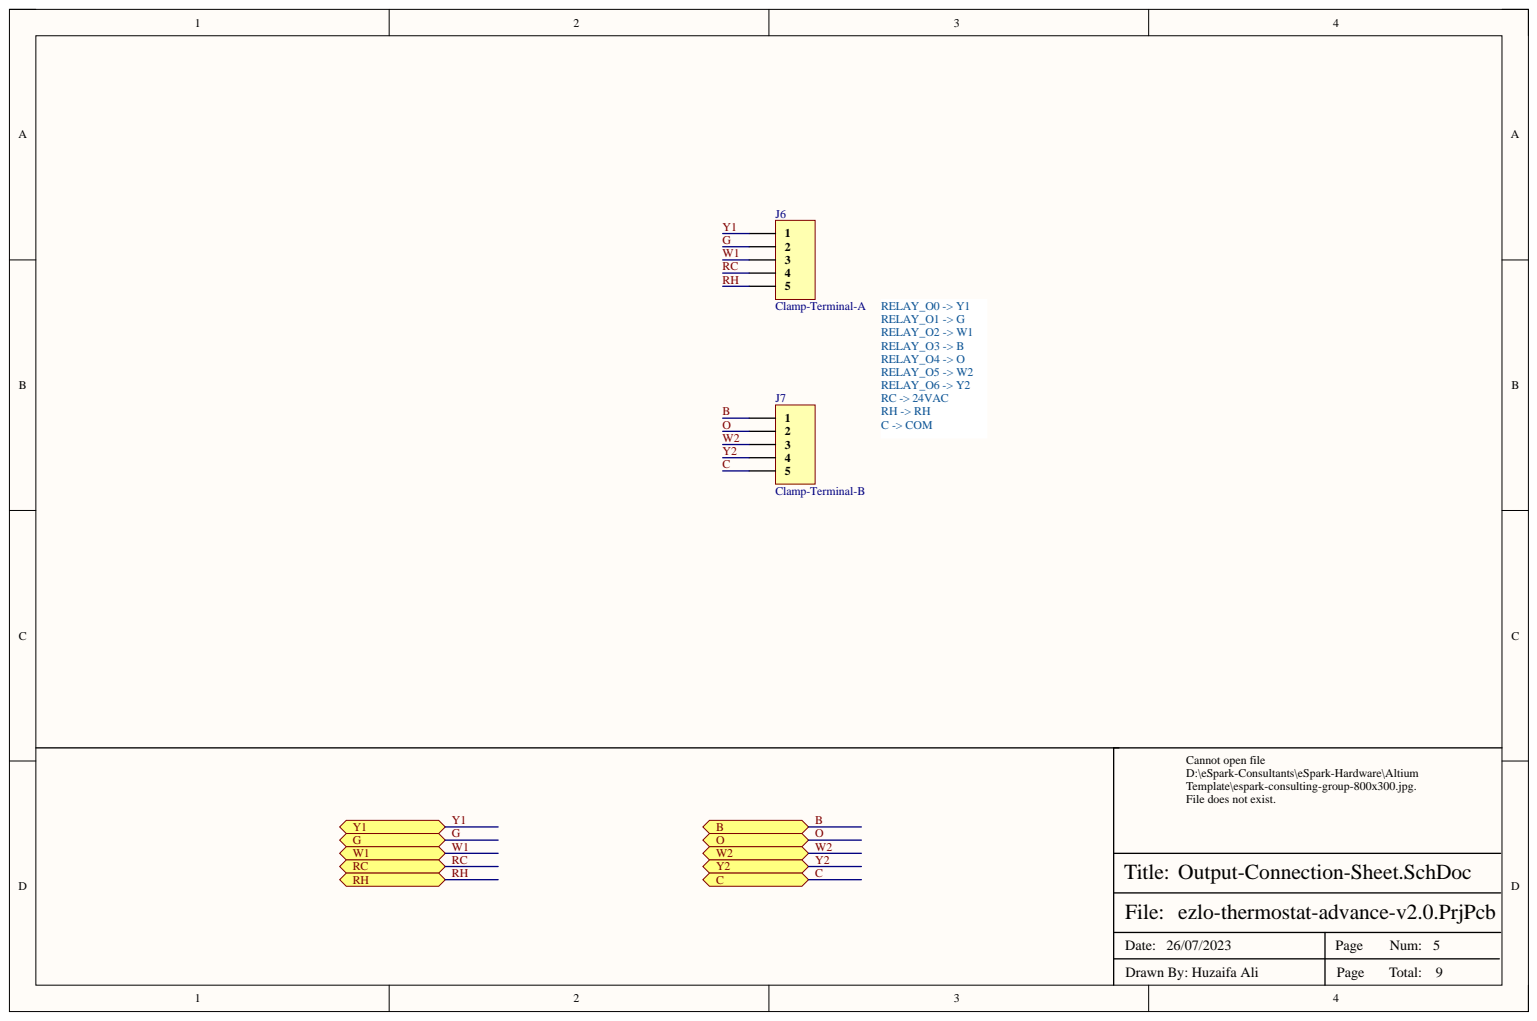
[picture p47: page 5]
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

Output-Connection-Sheet.SchDoc

ezlo-thermostat-advance-v2.0.PrjPcb

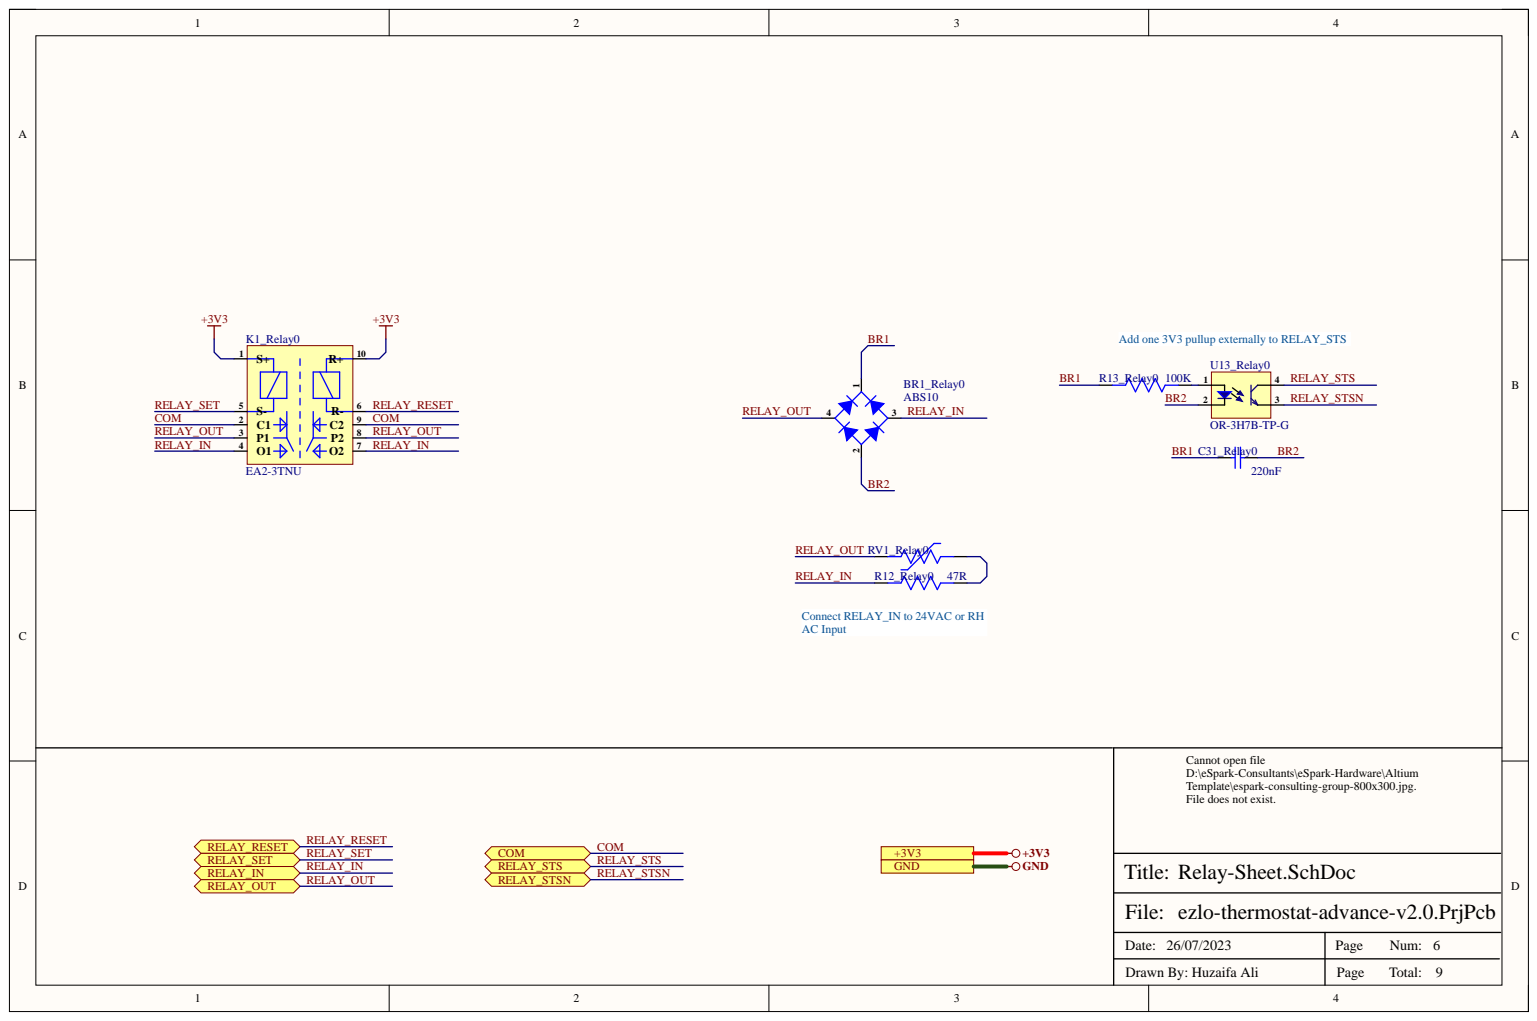
[picture p48: page 6]

Add one 3V3 pullup externally to RELAY_STS

Connect RELAY_IN to 24VAC or RH
AC Input

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

ezlo-thermostat-advance-v2.0.PrjPcb

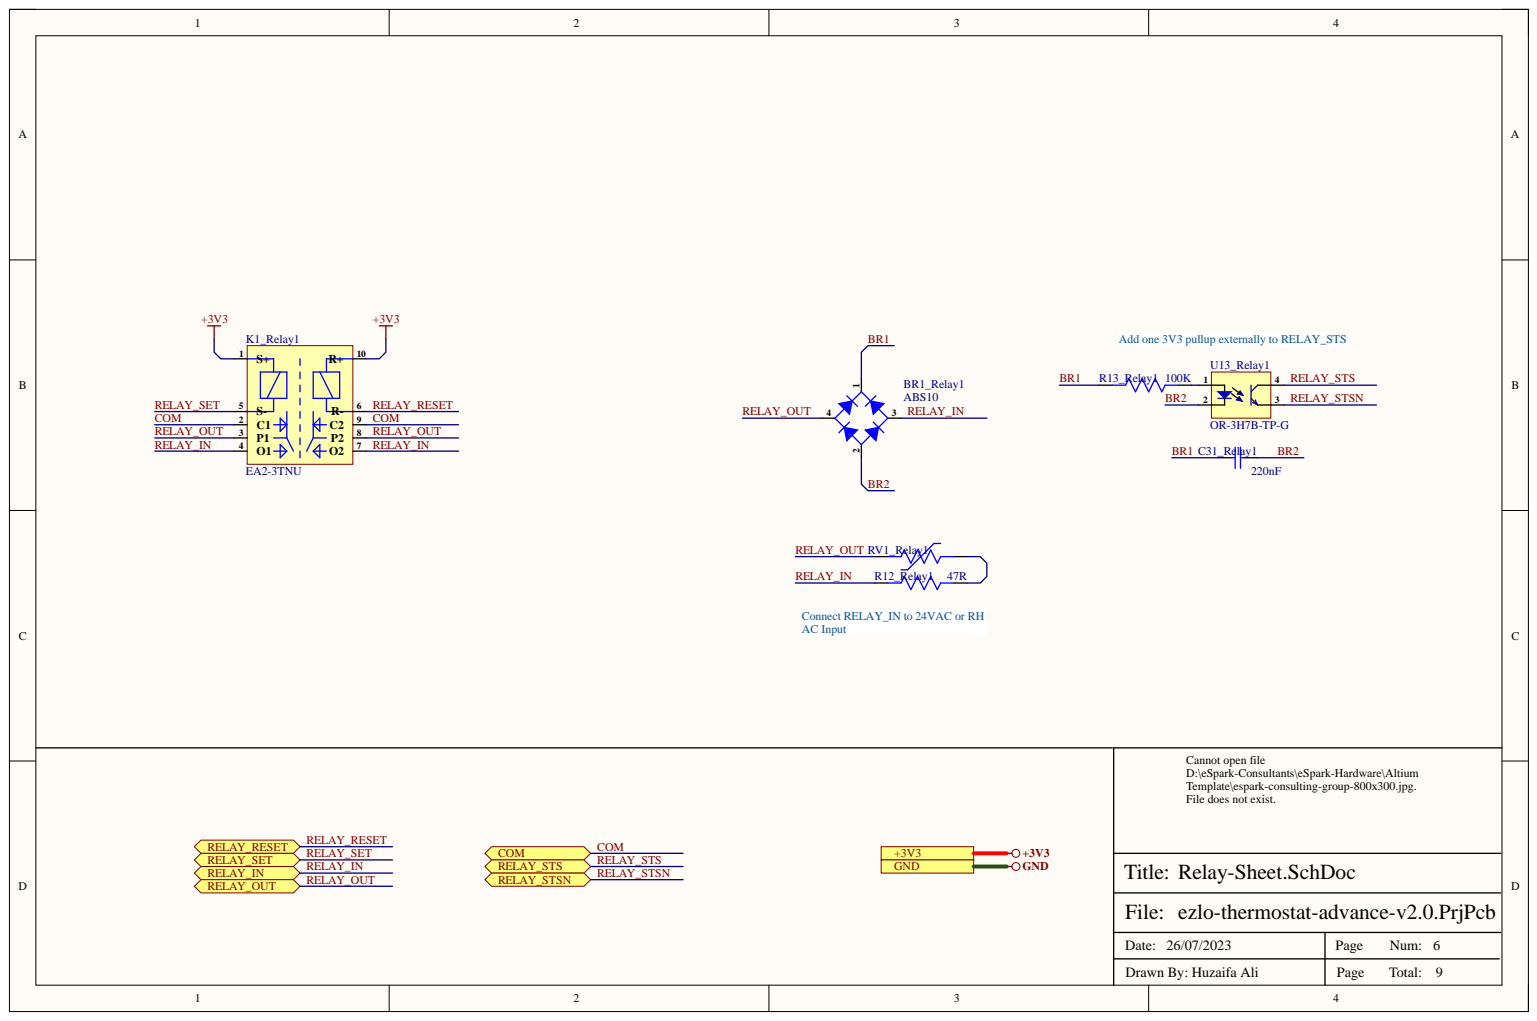
[picture p49: page 7]

Add one 3V3 pullup externally to RELAY_STS

Connect RELAY_IN to 24VAC or RH
AC Input

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

ezlo-thermostat-advance-v2.0.PrjPcb

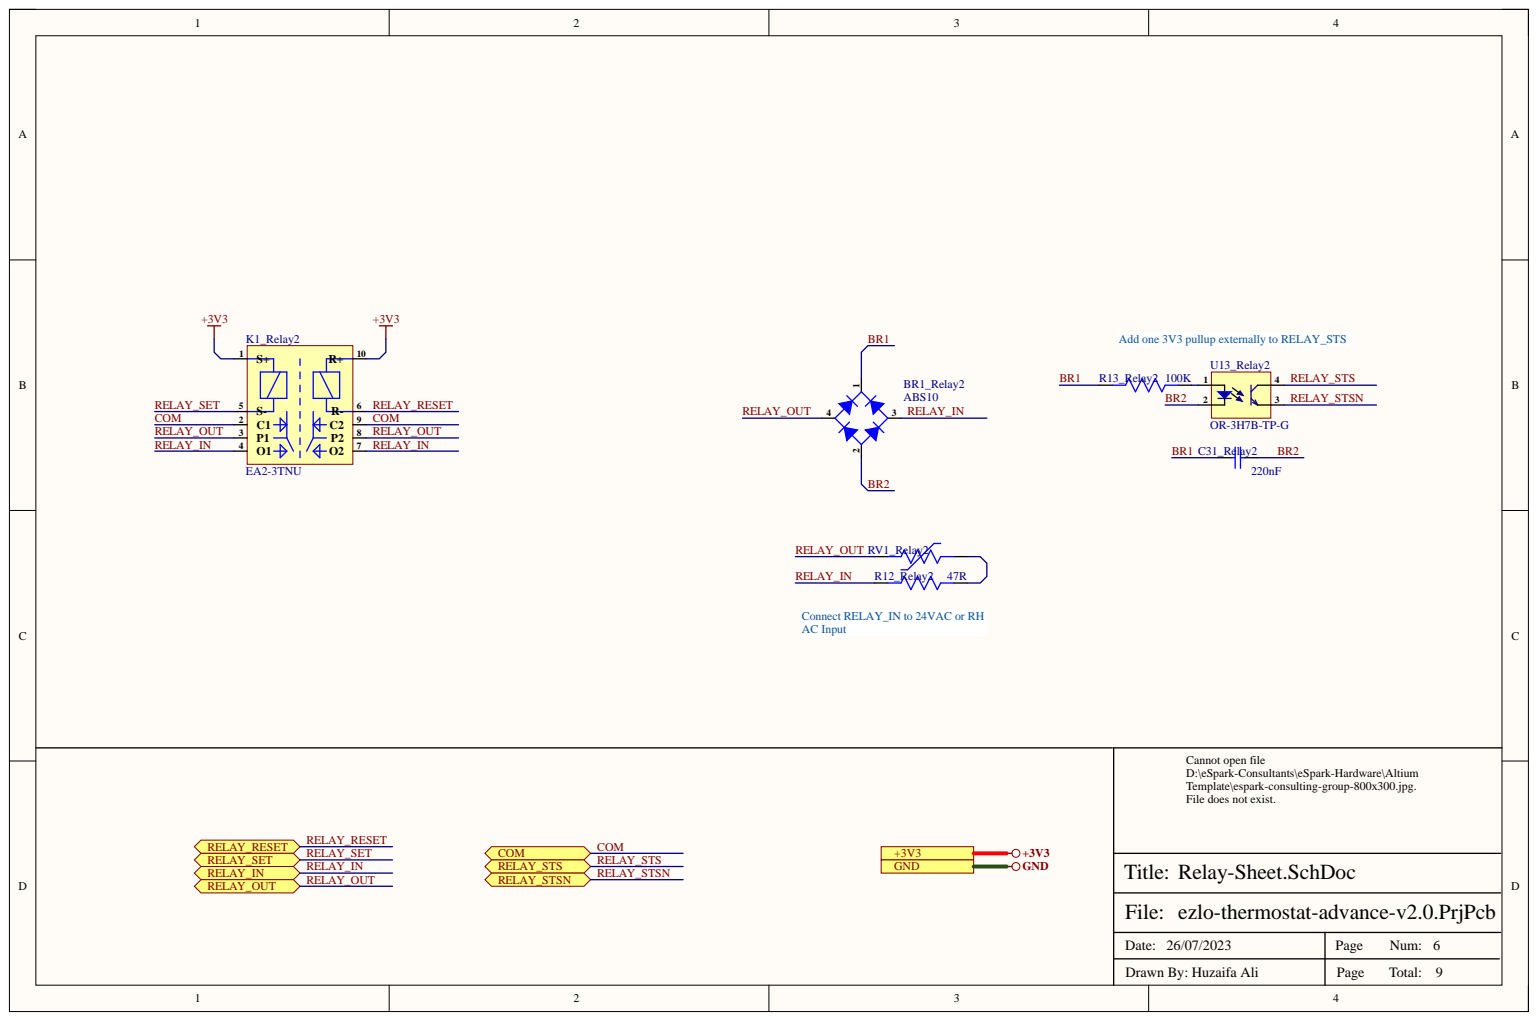
[picture p50: page 8]

Add one 3V3 pullup externally to RELAY_STS

Connect RELAY_IN to 24VAC or RH
AC Input

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

ezlo-thermostat-advance-v2.0.PrjPcb

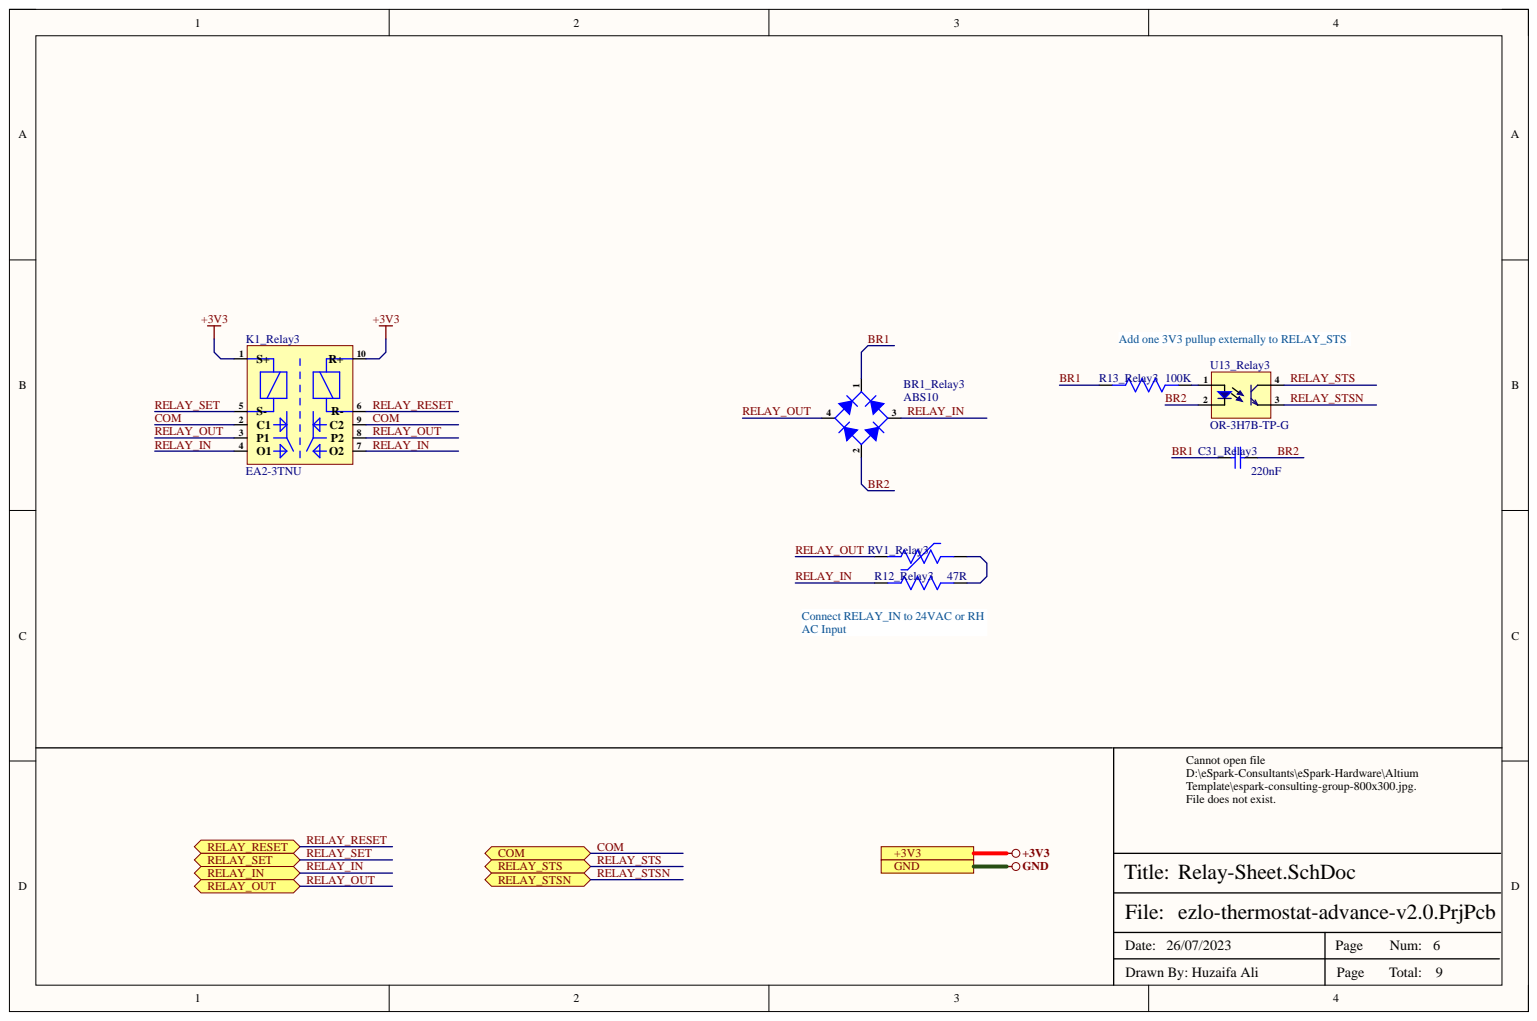
[picture p51: page 9]

Add one 3V3 pullup externally to RELAY_STS

Connect RELAY_IN to 24VAC or RH
AC Input

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

ezlo-thermostat-advance-v2.0.PrjPcb

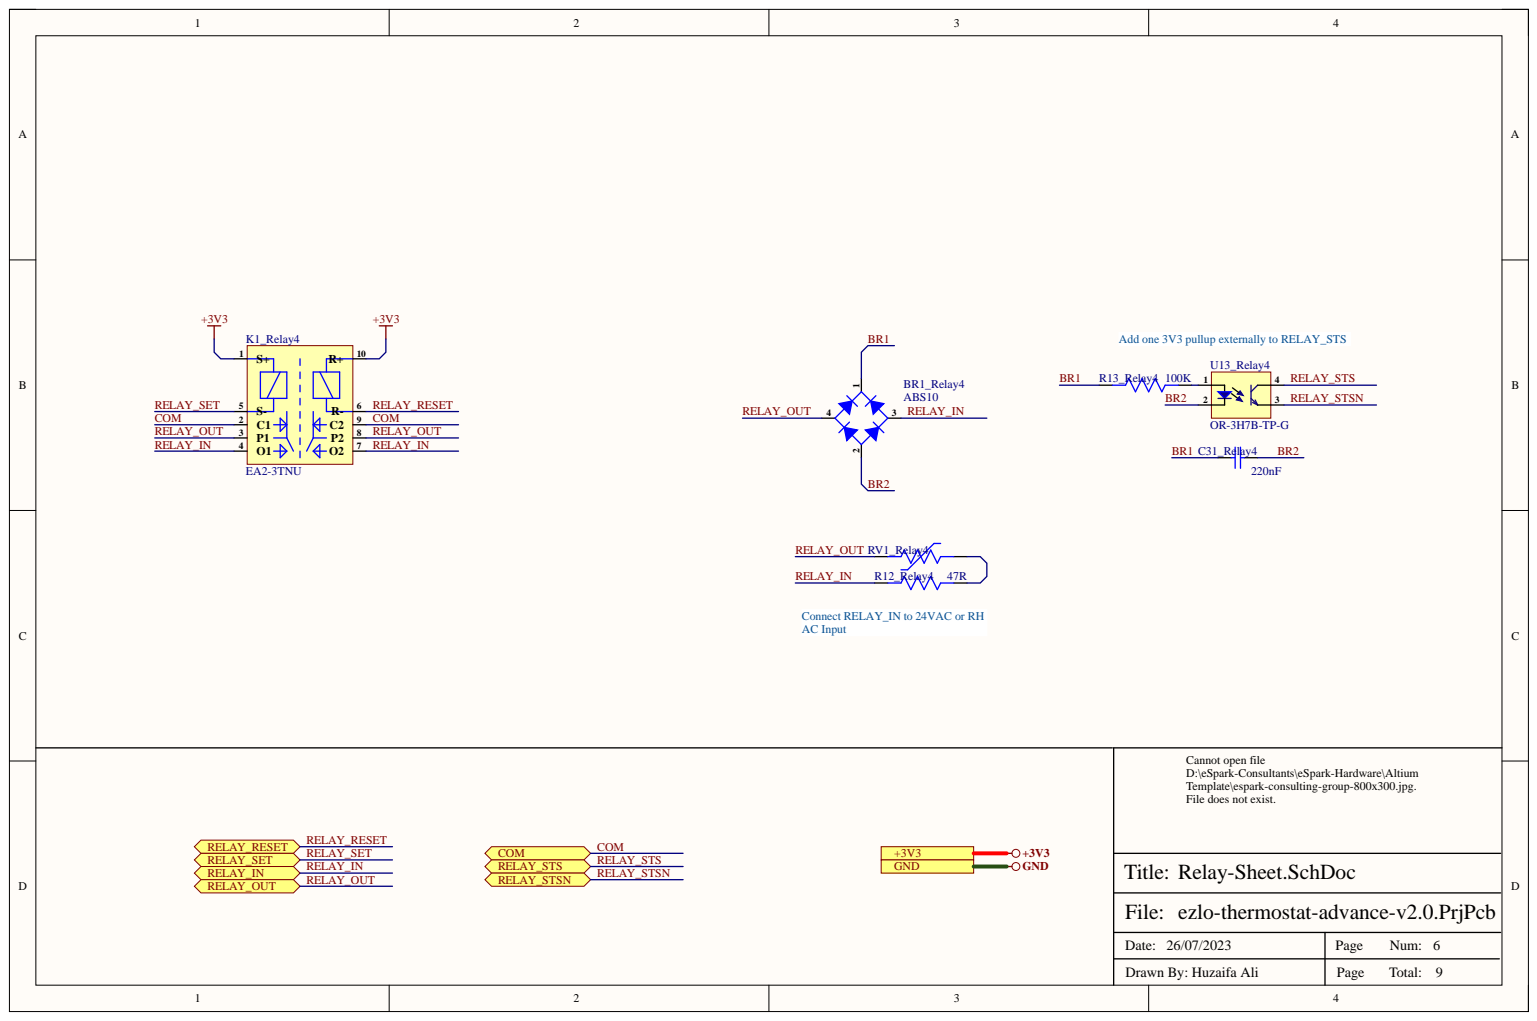
[picture p52: page 10]

Add one 3V3 pullup externally to RELAY_STS

Connect RELAY_IN to 24VAC or RH
AC Input

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

ezlo-thermostat-advance-v2.0.PrjPcb

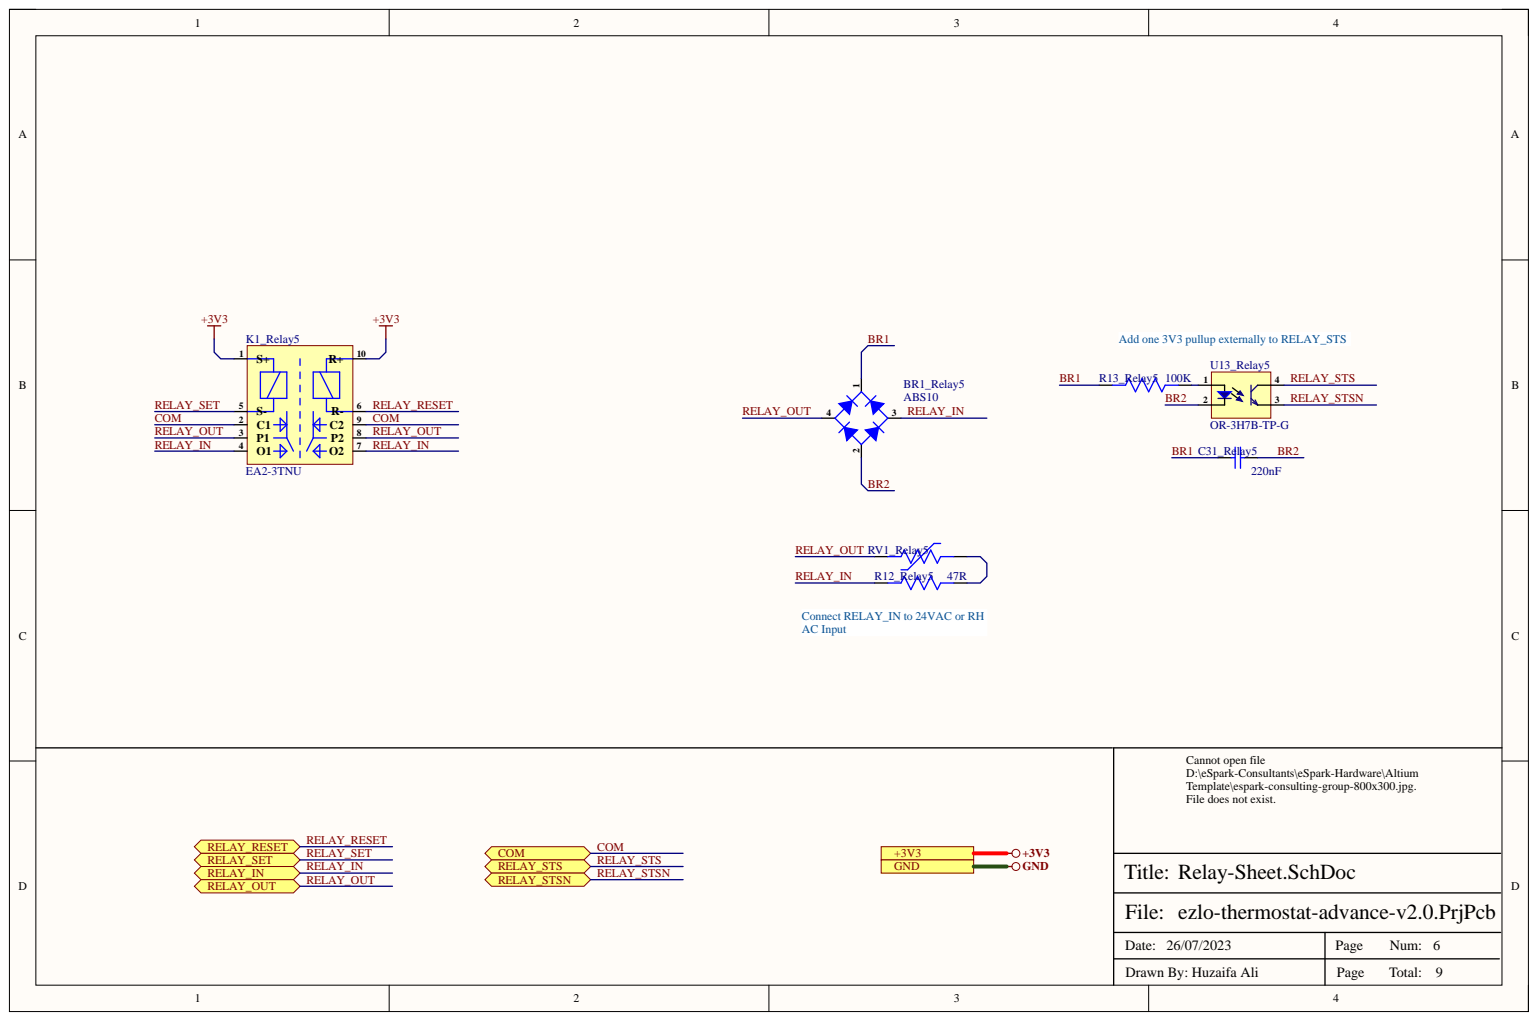
[picture p53: page 11]

Add one 3V3 pullup externally to RELAY_STS

Connect RELAY_IN to 24VAC or RH
AC Input

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

ezlo-thermostat-advance-v2.0.PrjPcb

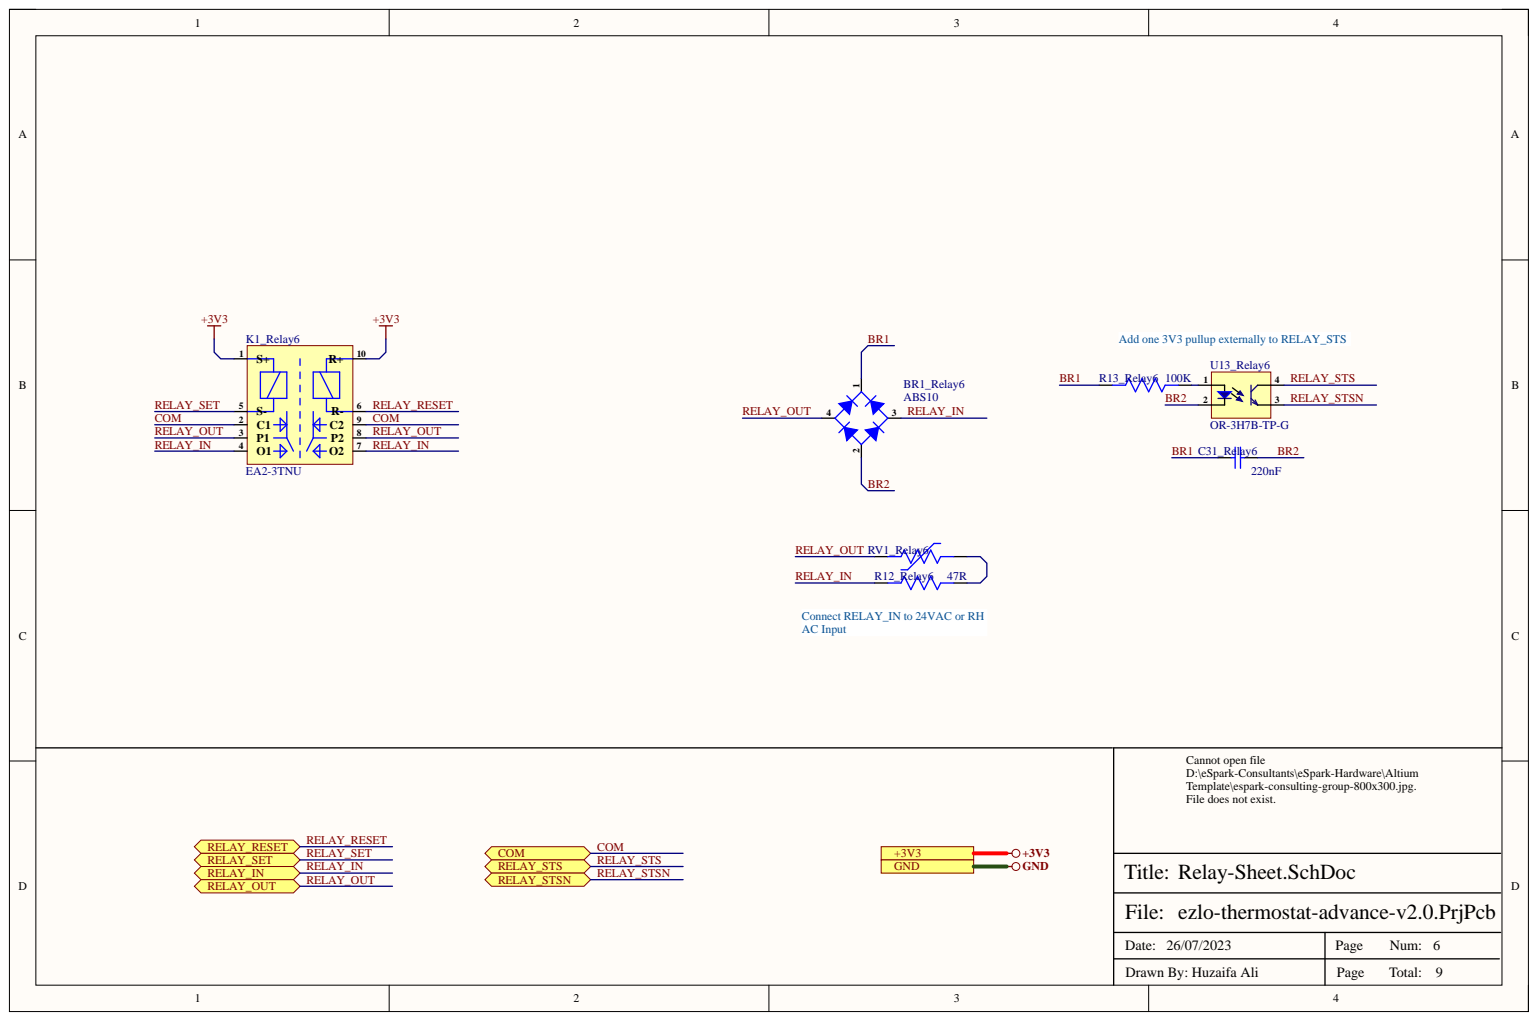
[picture p54: page 12]

Add one 3V3 pullup externally to RELAY_STS

Connect RELAY_IN to 24VAC or RH
AC Input

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

ezlo-thermostat-advance-v2.0.PrjPcb

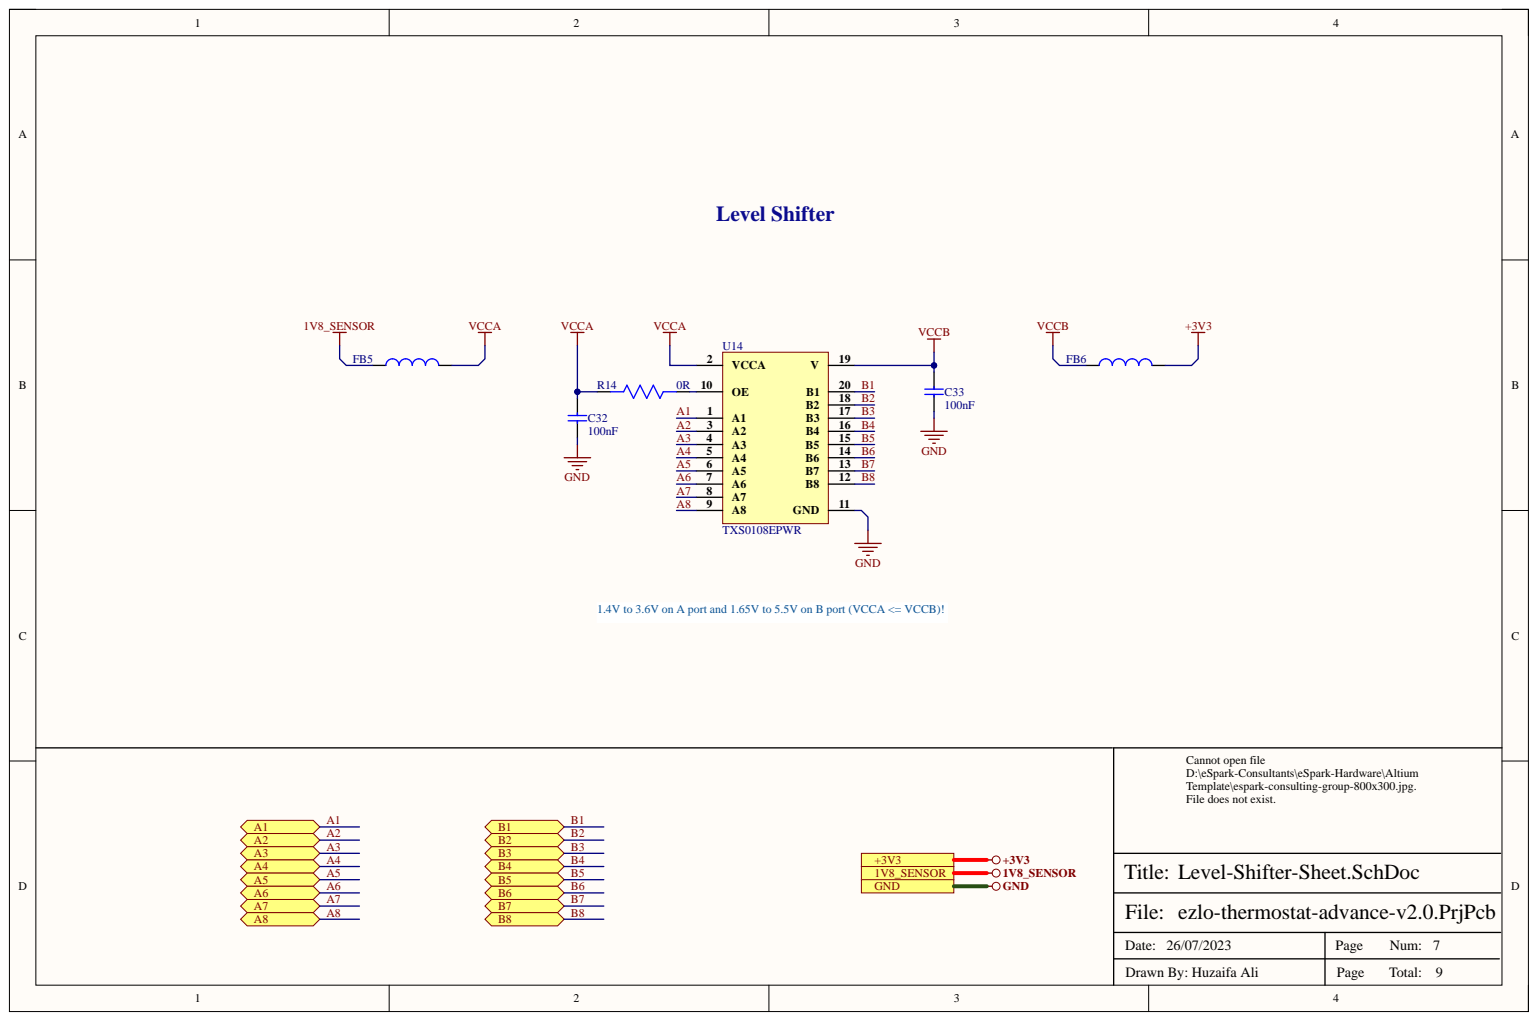
[picture p55: page 13]

1.4V to 3.6V on A port and 1.65V to 5.5V on B port (VCCA <= VCCB)!

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

Level-Shifter-Sheet.SchDoc

ezlo-thermostat-advance-v2.0.PrjPcb

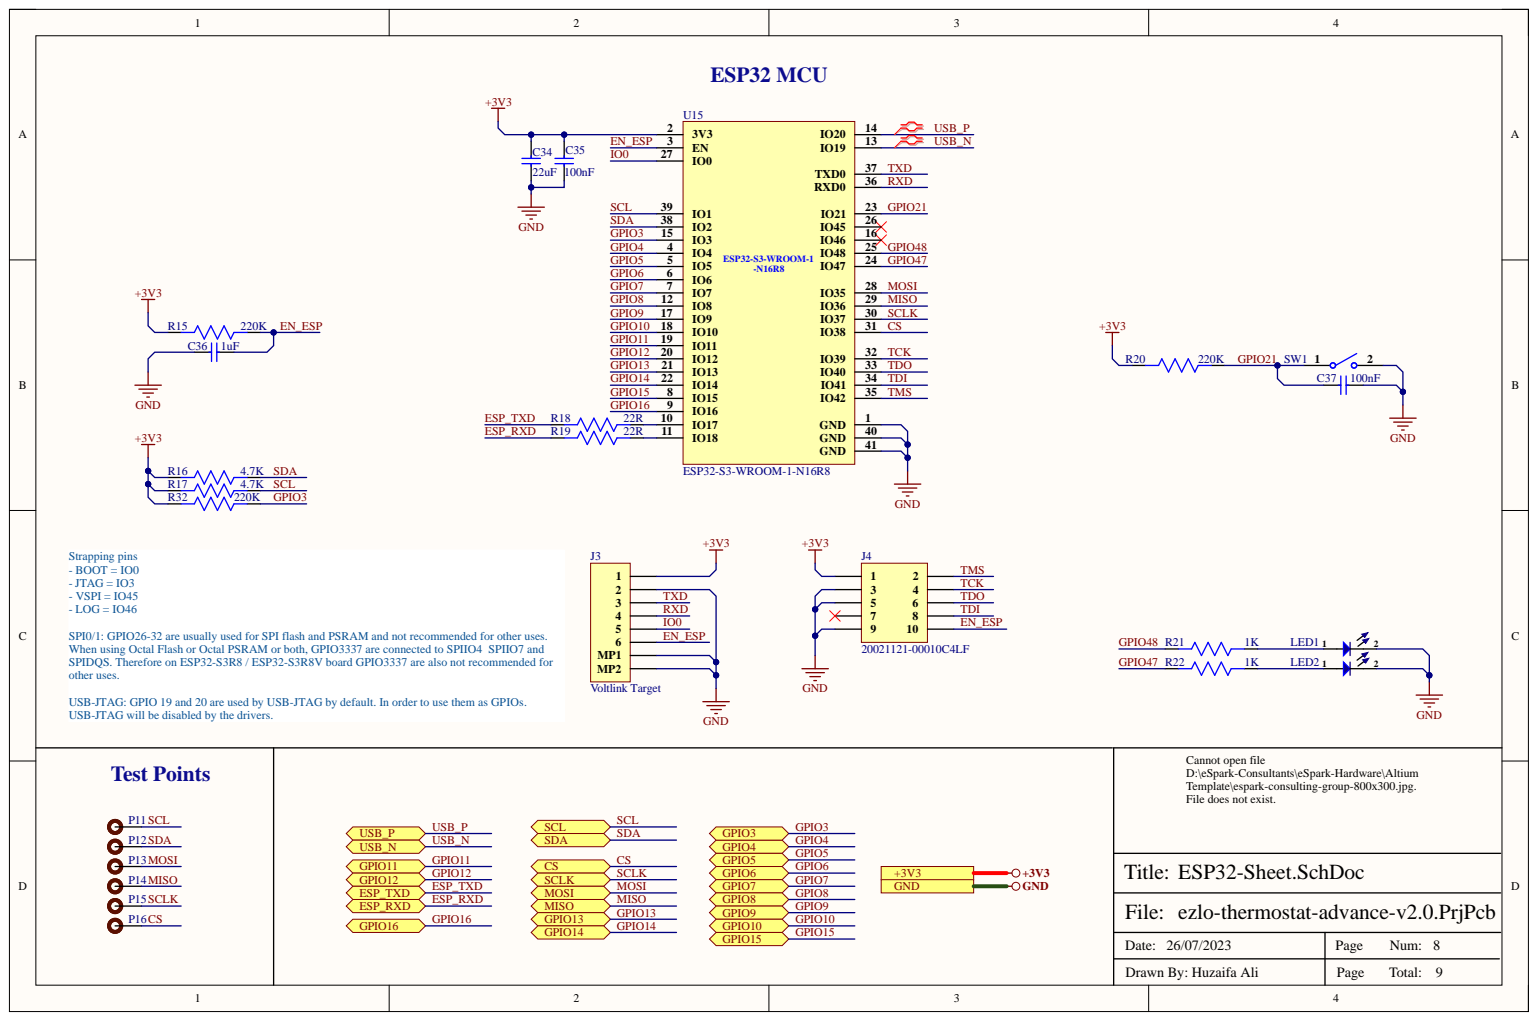
[picture p56: page 14]

SPI0/1: GPIO26-32 are usually used for SPI flash and PSRAM and not recommended for other uses.
When using Octal Flash or Octal PSRAM or both, GPIO3337 are connected to SPIIO4 SPIIO7 and
SPIDQS. Therefore on ESP32-S3R8 / ESP32-S3R8V board GPIO3337 are also not recommended for
other uses.

USB-JTAG: GPIO 19 and 20 are used by USB-JTAG by default. In order to use them as GPIOs.
USB-JTAG will be disabled by the drivers.

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

ezlo-thermostat-advance-v2.0.PrjPcb

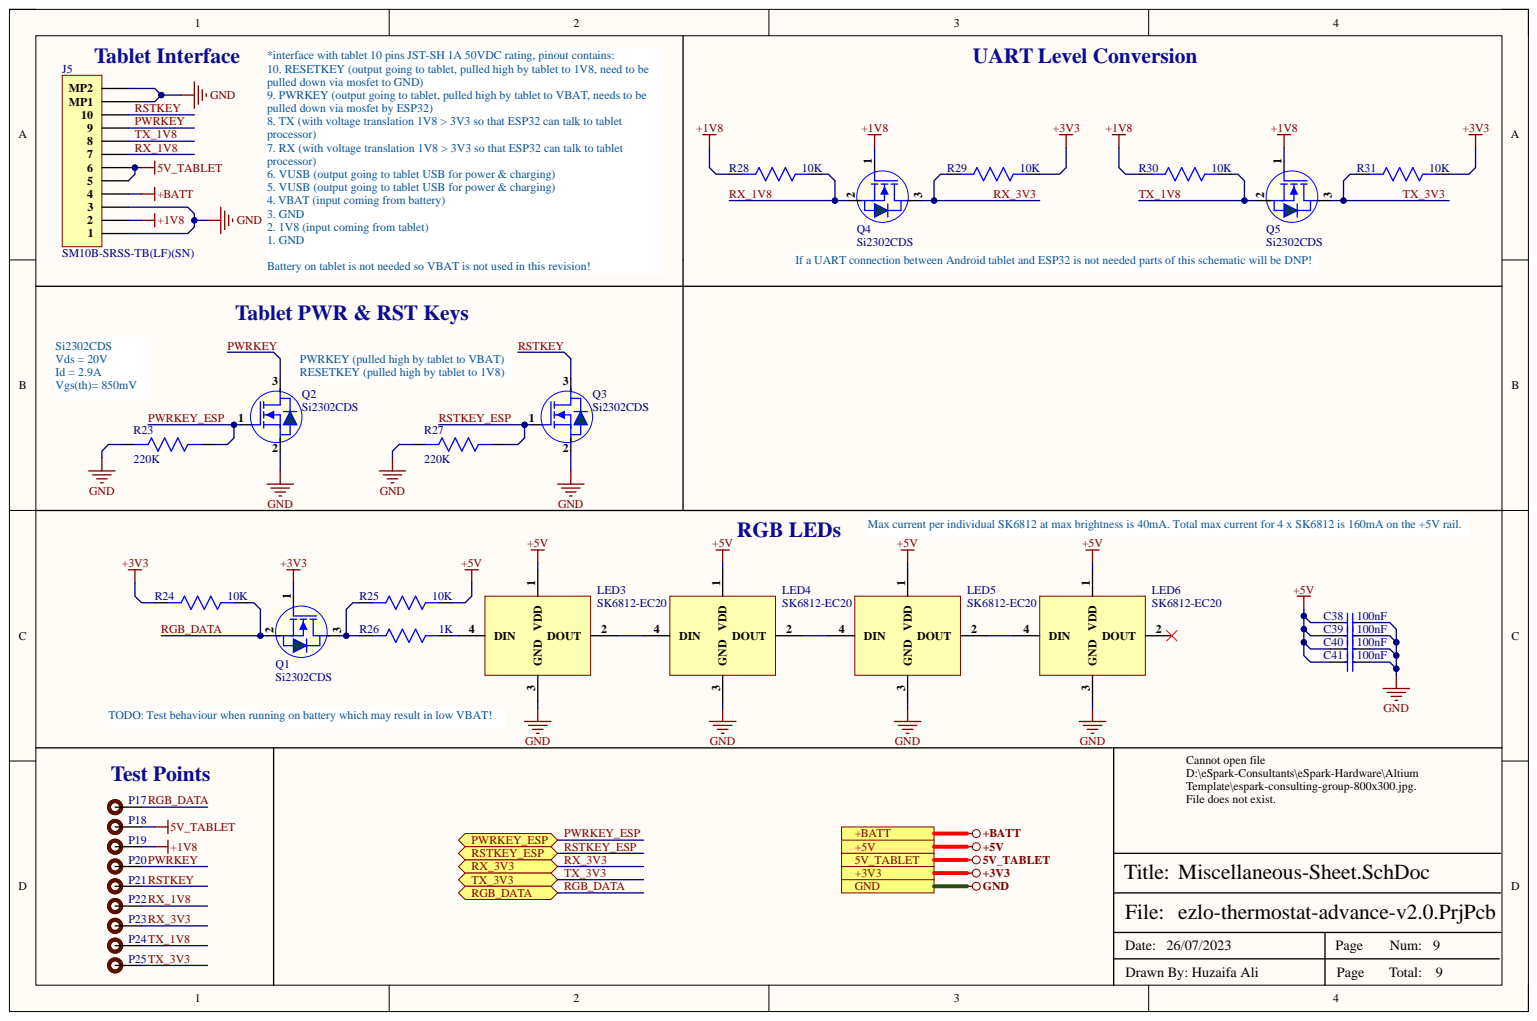
[picture p57: page 15]

*interface with tablet 10 pins JST-SH 1A 50VDC rating, pinout contains:
10. RESETKEY (output going to tablet, pulled high by tablet to 1V8, need to be
pulled down via mosfet to GND)
9. PWRKEY (output going to tablet, pulled high by tablet to VBAT, needs to be
pulled down via mosfet by ESP32)
8. TX (with voltage translation 1V8 > 3V3 so that ESP32 can talk to tablet
processor)
7. RX (with voltage translation 1V8 > 3V3 so that ESP32 can talk to tablet
6. VUSB (output going to tablet USB for power & charging)
5. VUSB (output going to tablet USB for power & charging)
4. VBAT (input coming from battery)
3. GND
2. 1V8 (input coming from tablet)
1. GND

Tablet PWR & RST Keys

PWRKEY (pulled high by tablet to VBAT)
RESETKEY (pulled high by tablet to 1V8)

Max current per individual SK6812 at max brightness is 40mA. Total max current for 4 x SK6812 is 160mA on the +5V rail.

TODO: Test behaviour when running on battery which may result in low VBAT!

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

ezlo-thermostat-advance-v2.0.PrjPcb
