eSpark-Backup/ezlo-thermostat/Design Files/Ezlo-Radar-Sensor-v2.0-Advance/Ezlo-Radar-Sensor-v2.0-Advance.pdf

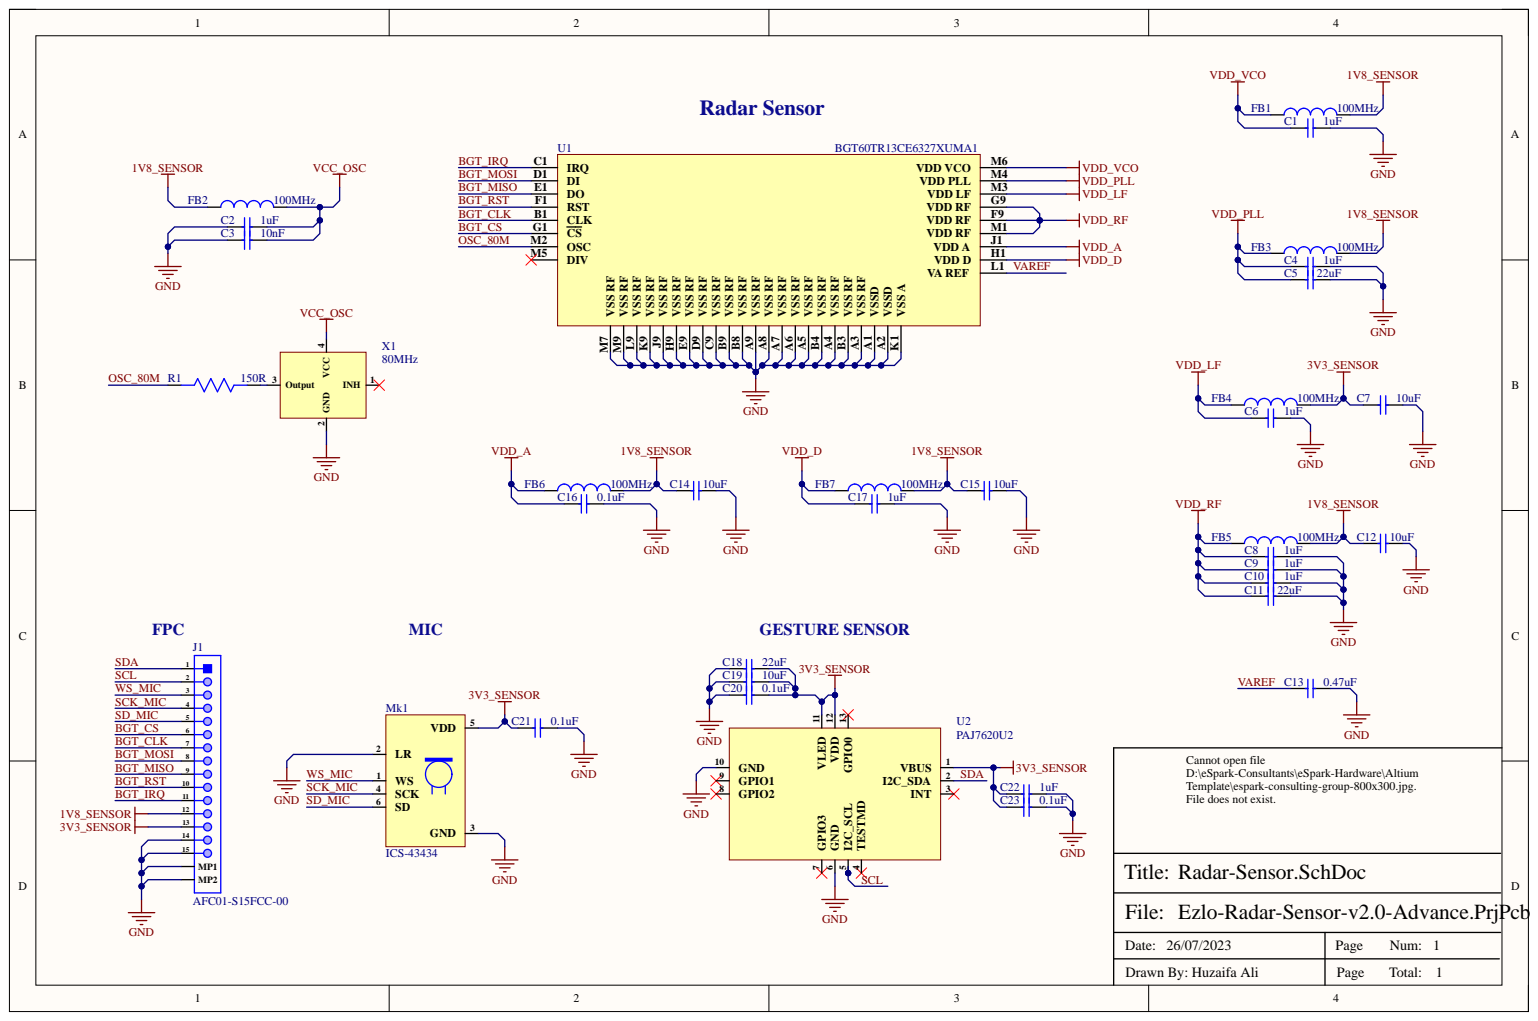
[picture p58: page 1]

VSS RF B8 VSS RF B9 VSS RF C9

VSS RF A5 VSS RF A6 VSS RF A7 VSS RF A8 VSS RF A9

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

Ezlo-Radar-Sensor-v2.0-Advance.PrjPcb
