eSpark-Backup/ezlo-thermostat/Deliverables/Schematics/ezlo-thermostat.pdf

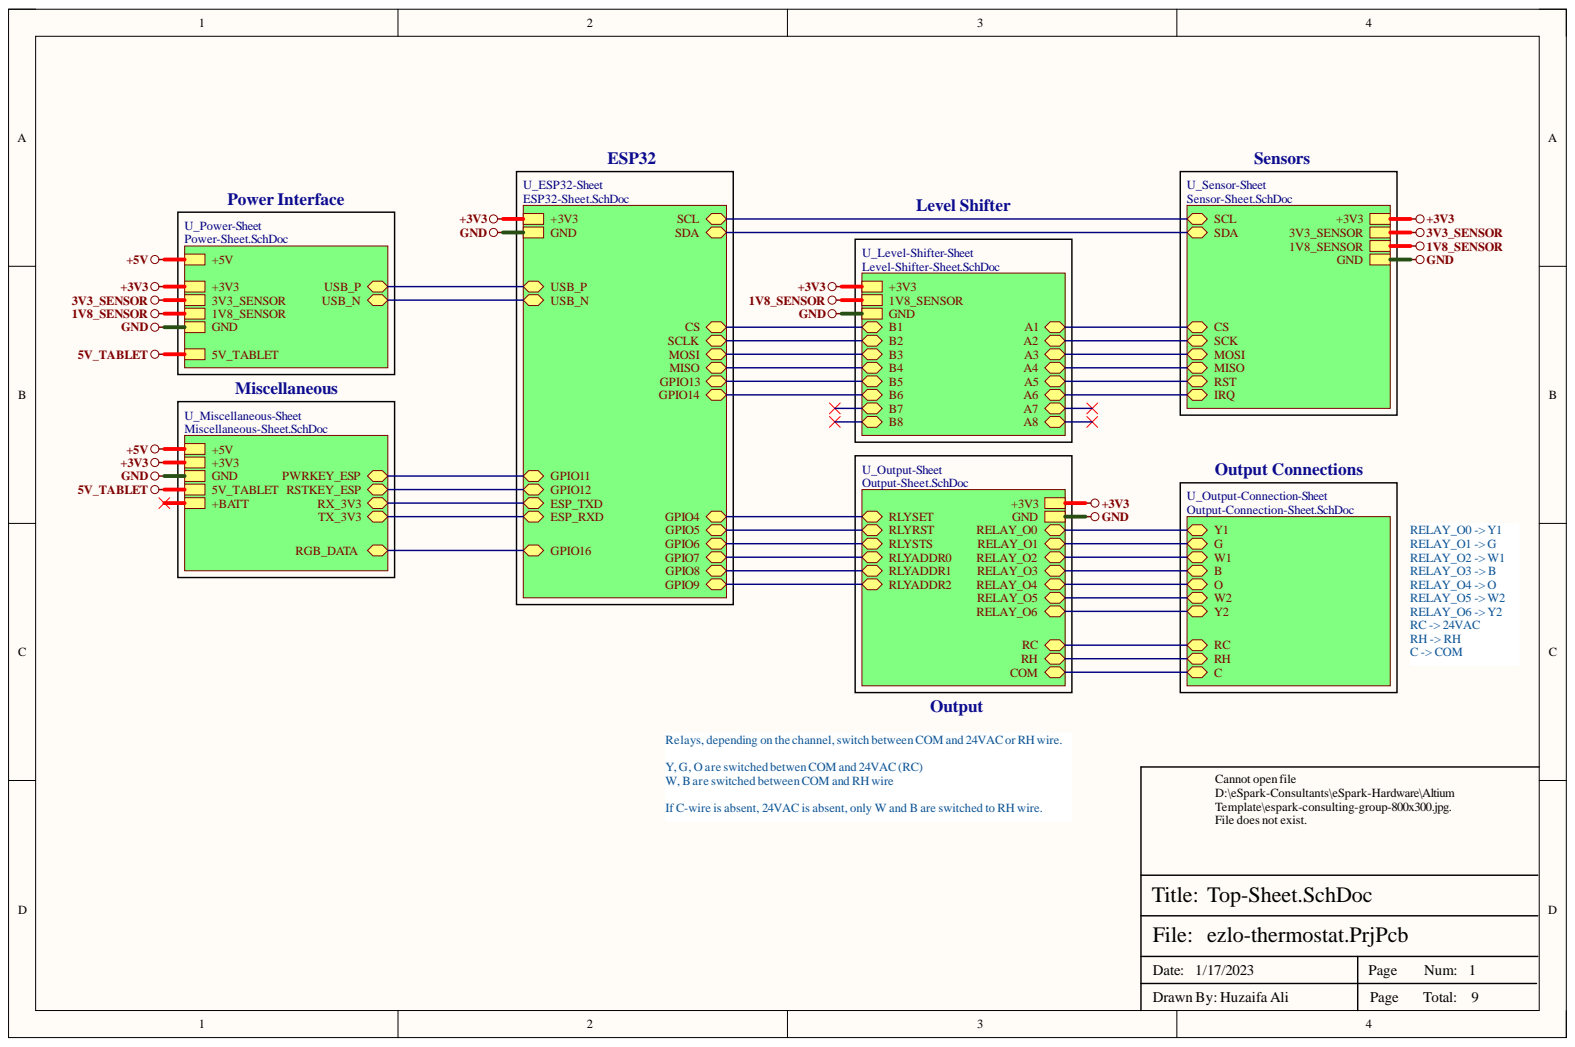
[picture p59: page 1]

Relays, depending on the channel,switch between COM and 24VACorRH wire.

Y, G, O are switched betwen COM and 24VAC(RC)
W, Bare switched between COM and RH wire

Cannot open file
D:\eSpark-Consultants\eSpark-Hardware\Altium
Template\espark-consulting-group-800x300.jpg.
File does not exist.

If C-wire is absent, 24VAC is absent, only W and B are switched to RH wire.

Date: 1/17/2023 | Page Num: 1

Drawn By: Huzaifa Ali | Page Total: 9

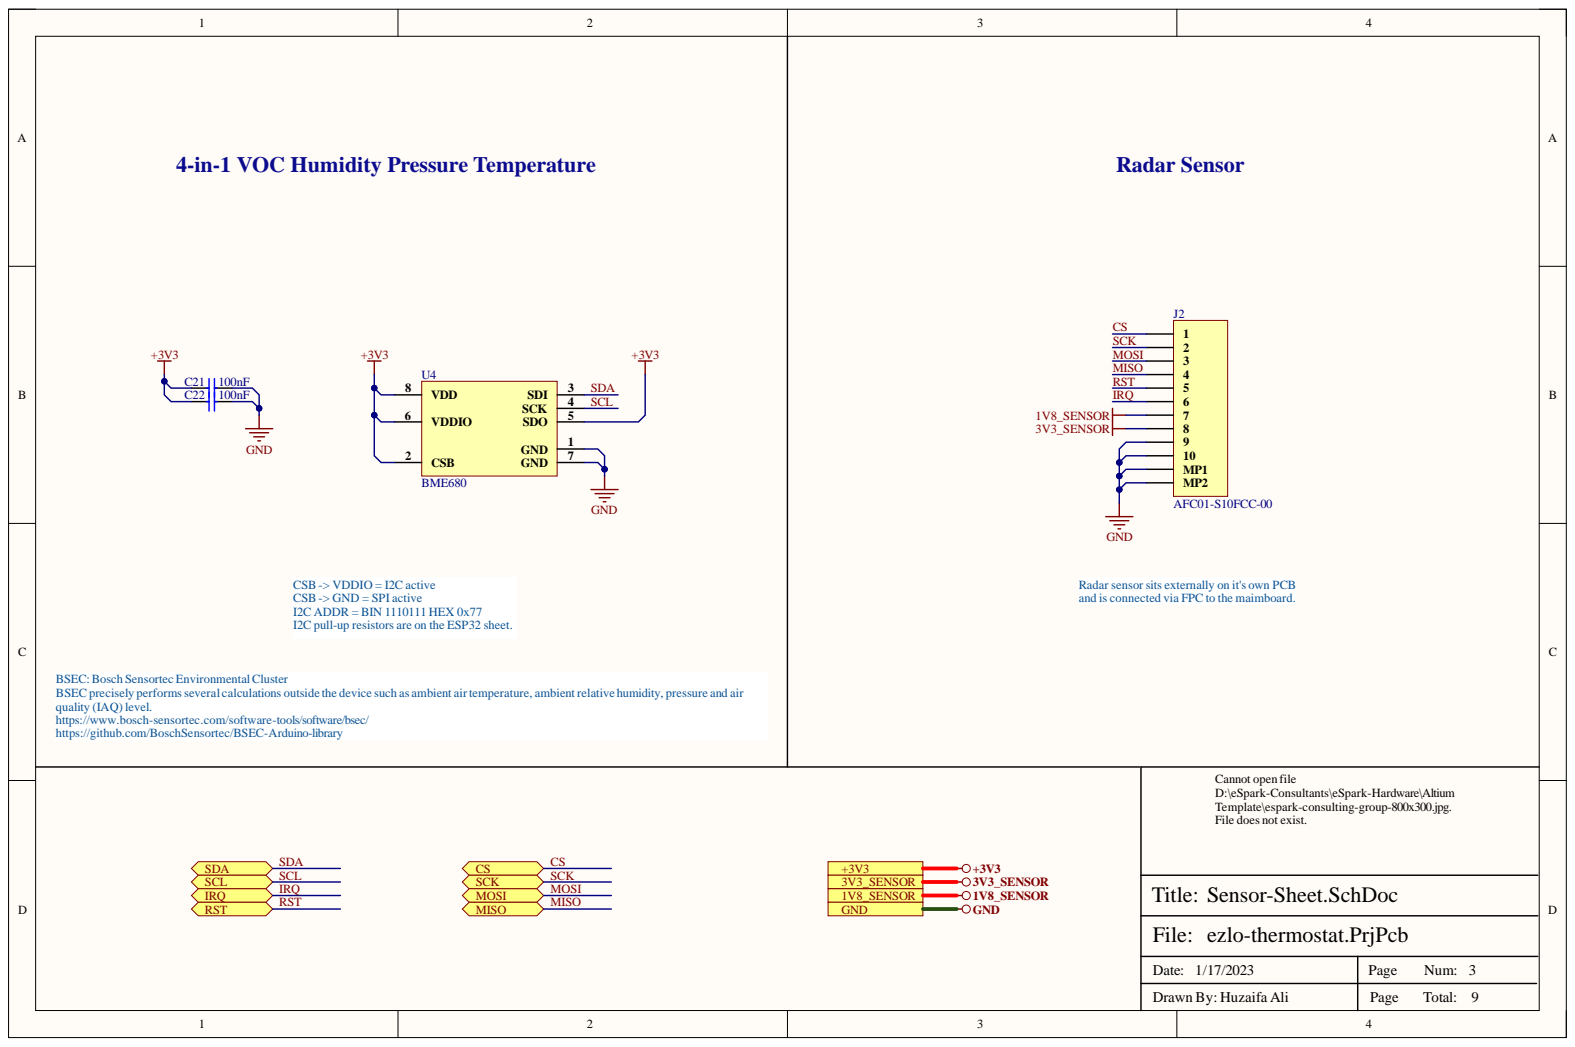
[picture p60: page 2]

CSB -> VDDIO = I2C active
CSB -> GND = SPI active
I2C ADDR = BIN 1110111 HEX 0x77
I2C pull-up resistors are on the ESP32 sheet.

Radar sensorsits externally on it's own PCB
and is connected via FPC to the maimboard.

BSEC: Bosch Sensortec Environmental Cluster
BSECprecisely performs several calculations outside the device such as ambient airtemperature, ambient relative humidity, pressure and air
quality (IAQ)level.
https://www.bosch-sensortec.com/software-tools/software/bsec/
https://github.com/BoschSensortec/BSEC-Arduino-library

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

Date: 1/17/2023 | Page Num: 3

Drawn By: Huzaifa Ali | Page Total: 9

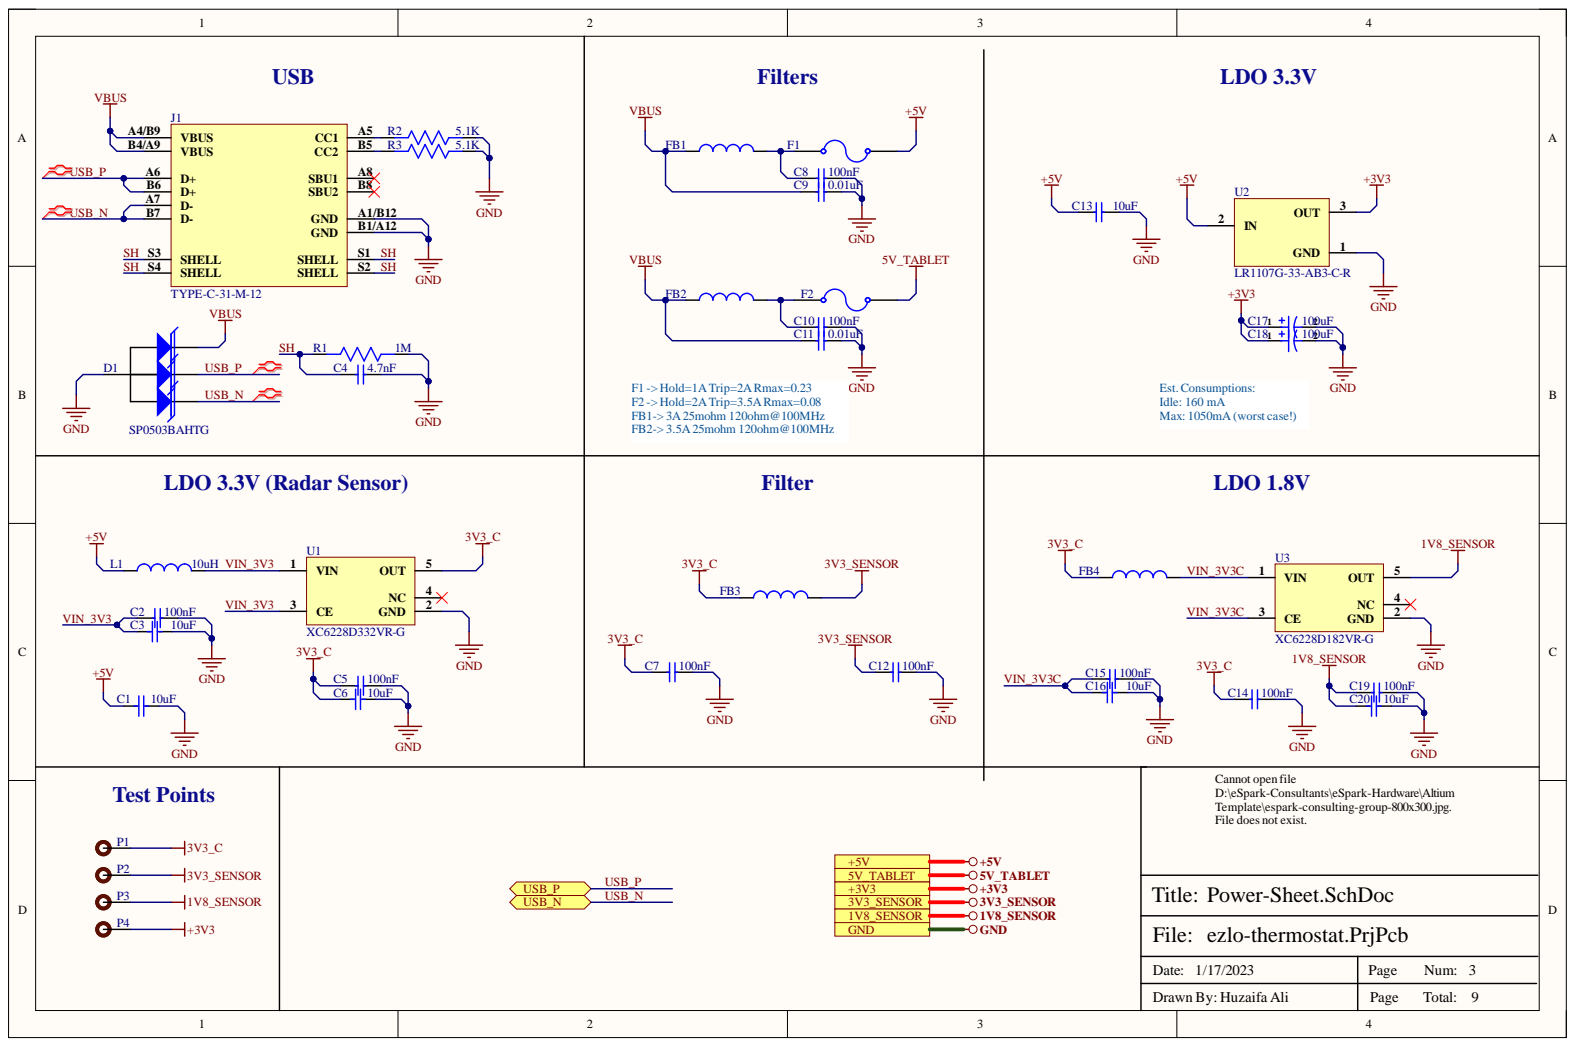
[picture p61: page 3]
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

Date: 1/17/2023 | Page Num: 3

Drawn By: Huzaifa Ali | Page Total: 9

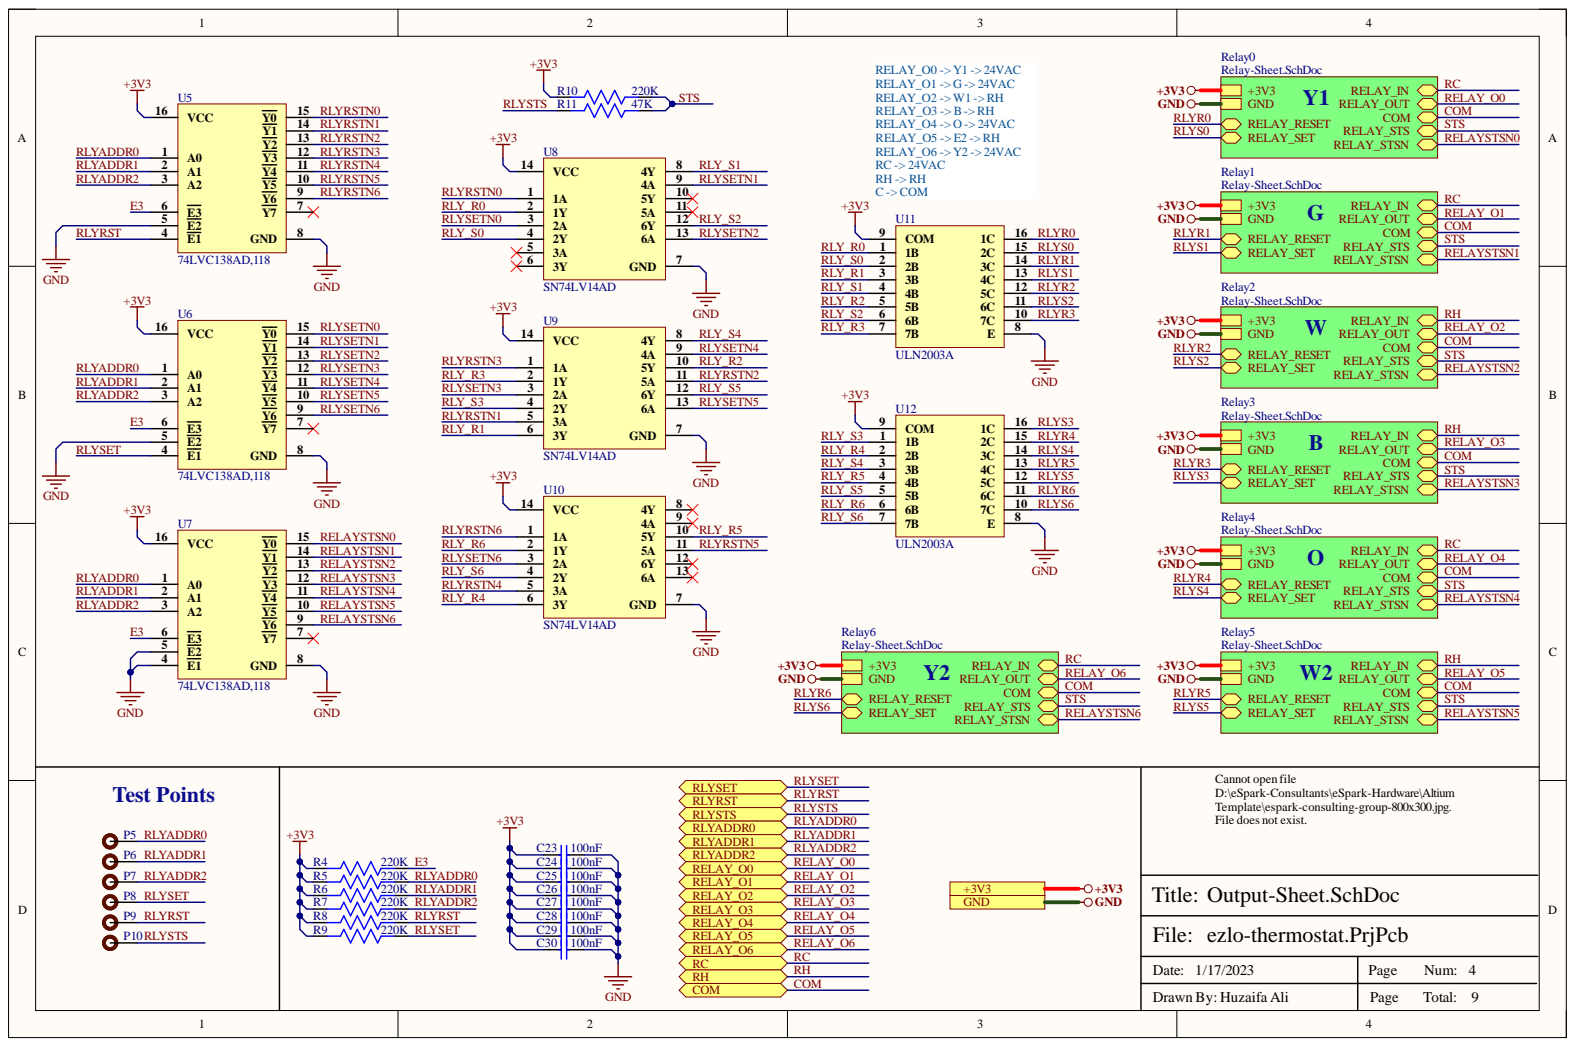
[picture p62: page 4]

STS STS STS STS STS

Dat e : 1 / 1 7 / 2 0 2 3 | Pag e N u m : 49

D raw n B y : H uzai fa A l i | Pag e To t al :

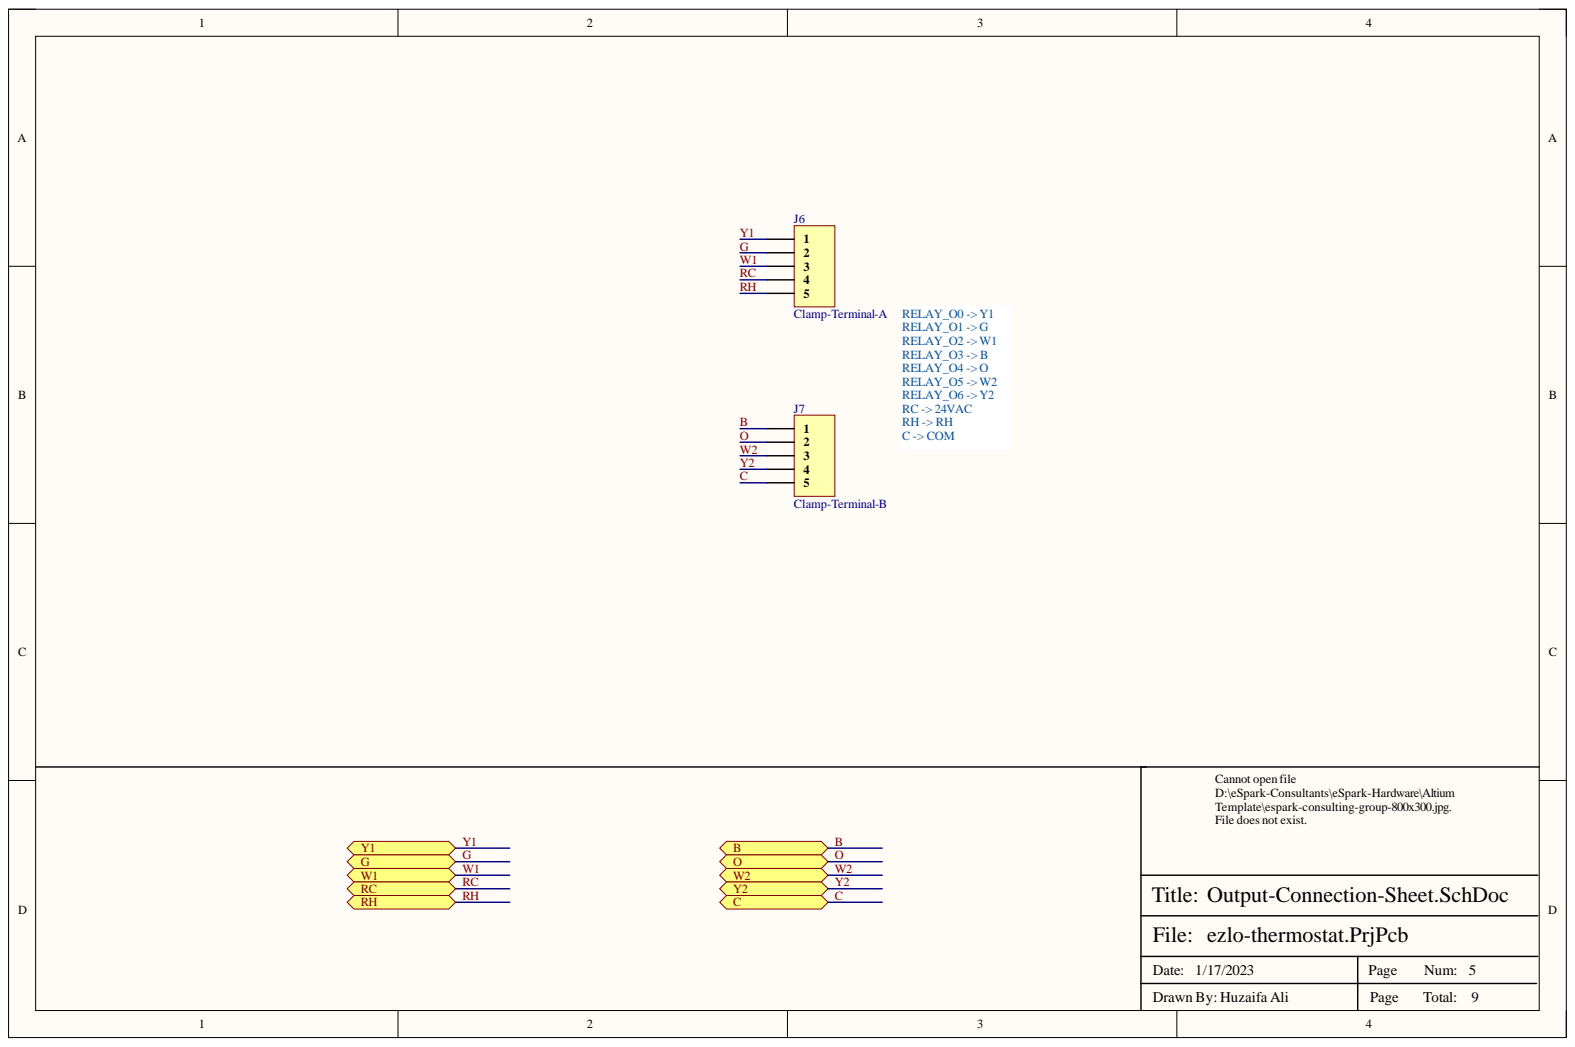
[picture p63: page 5]
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

Output-Connection-Sheet.SchDoc

Date: 1/17/2023 | Page Num: 5

Drawn By: Huzaifa Ali | Page Total: 9

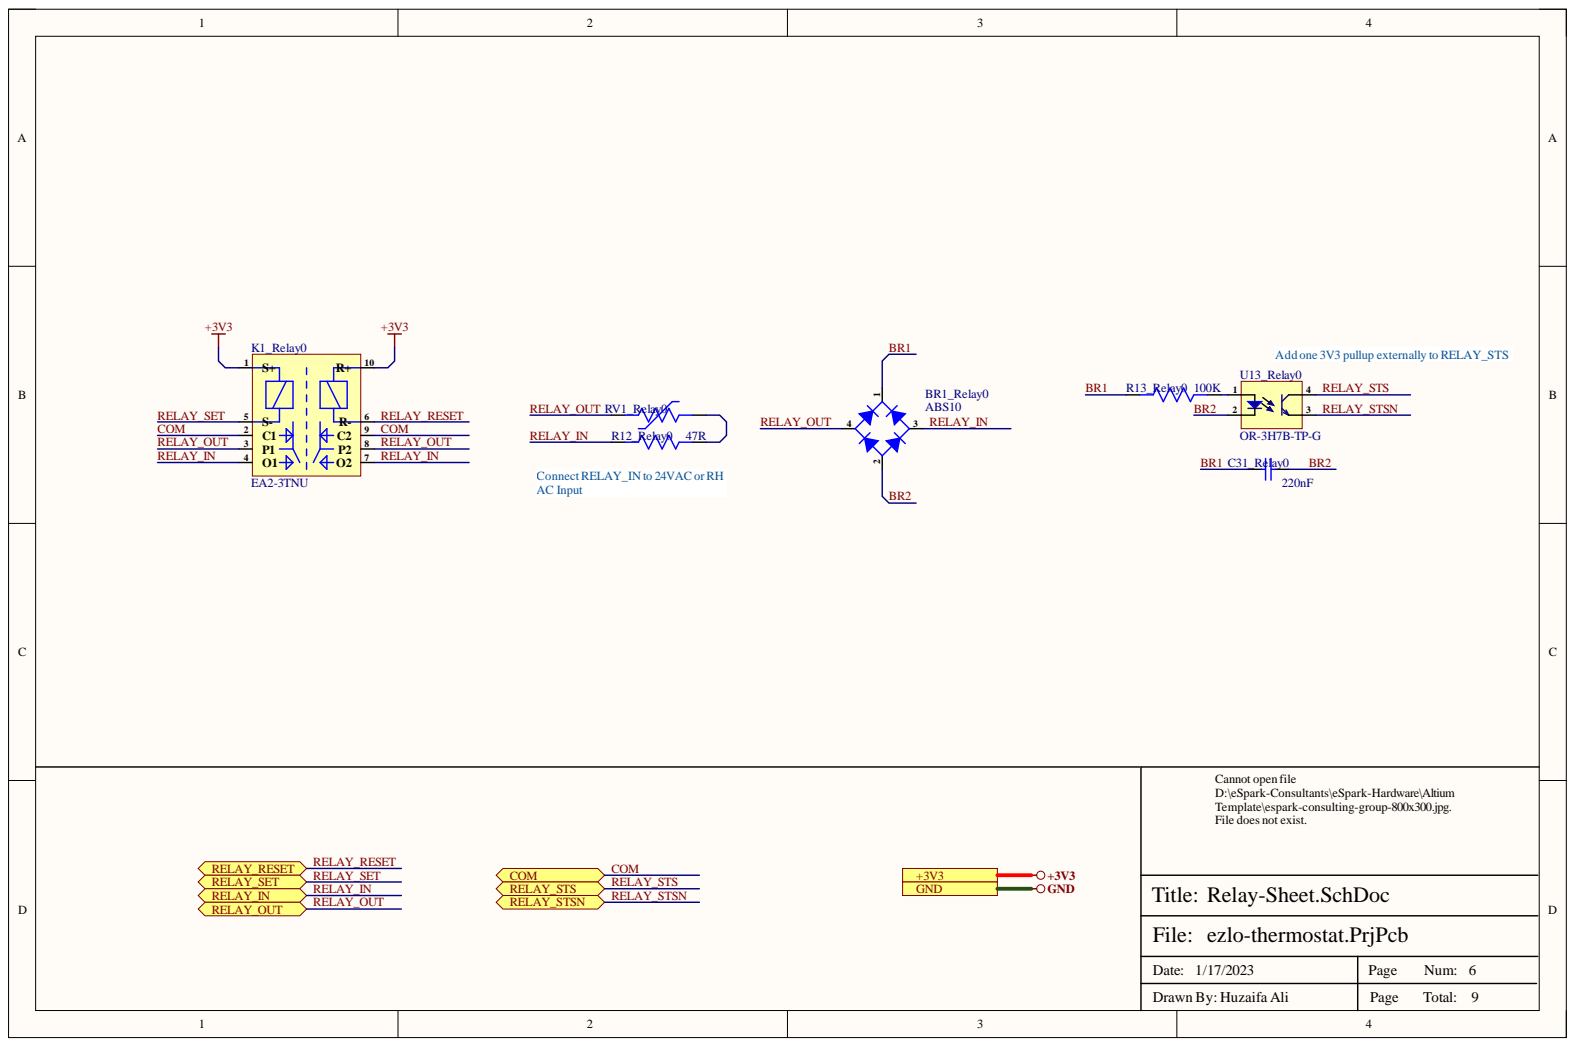
[picture p64: page 6]

Add one 3V3 pullup externally to RELAY_STS

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

Date: 1/17/2023 | Page Num: 6

Drawn By: Huzaifa Ali | Page Total: 9

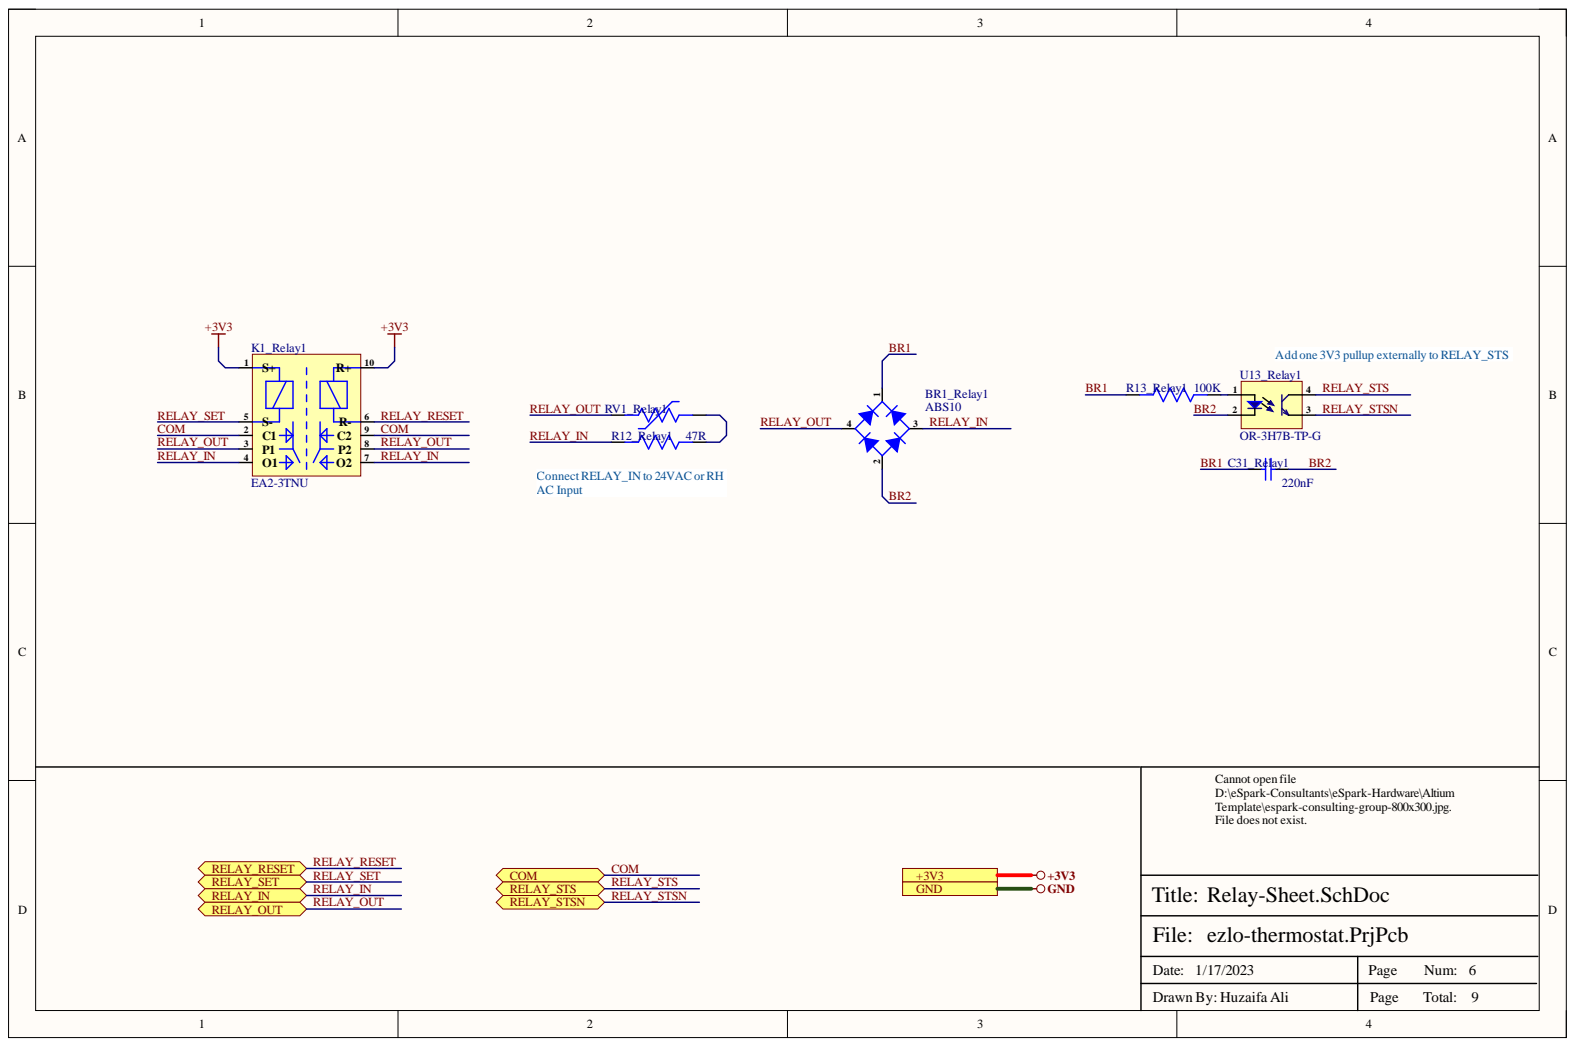
[picture p65: page 7]

Add one 3V3 pullup externally to RELAY_STS

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

Date: 1/17/2023 | Page Num: 6

Drawn By: Huzaifa Ali | Page Total: 9

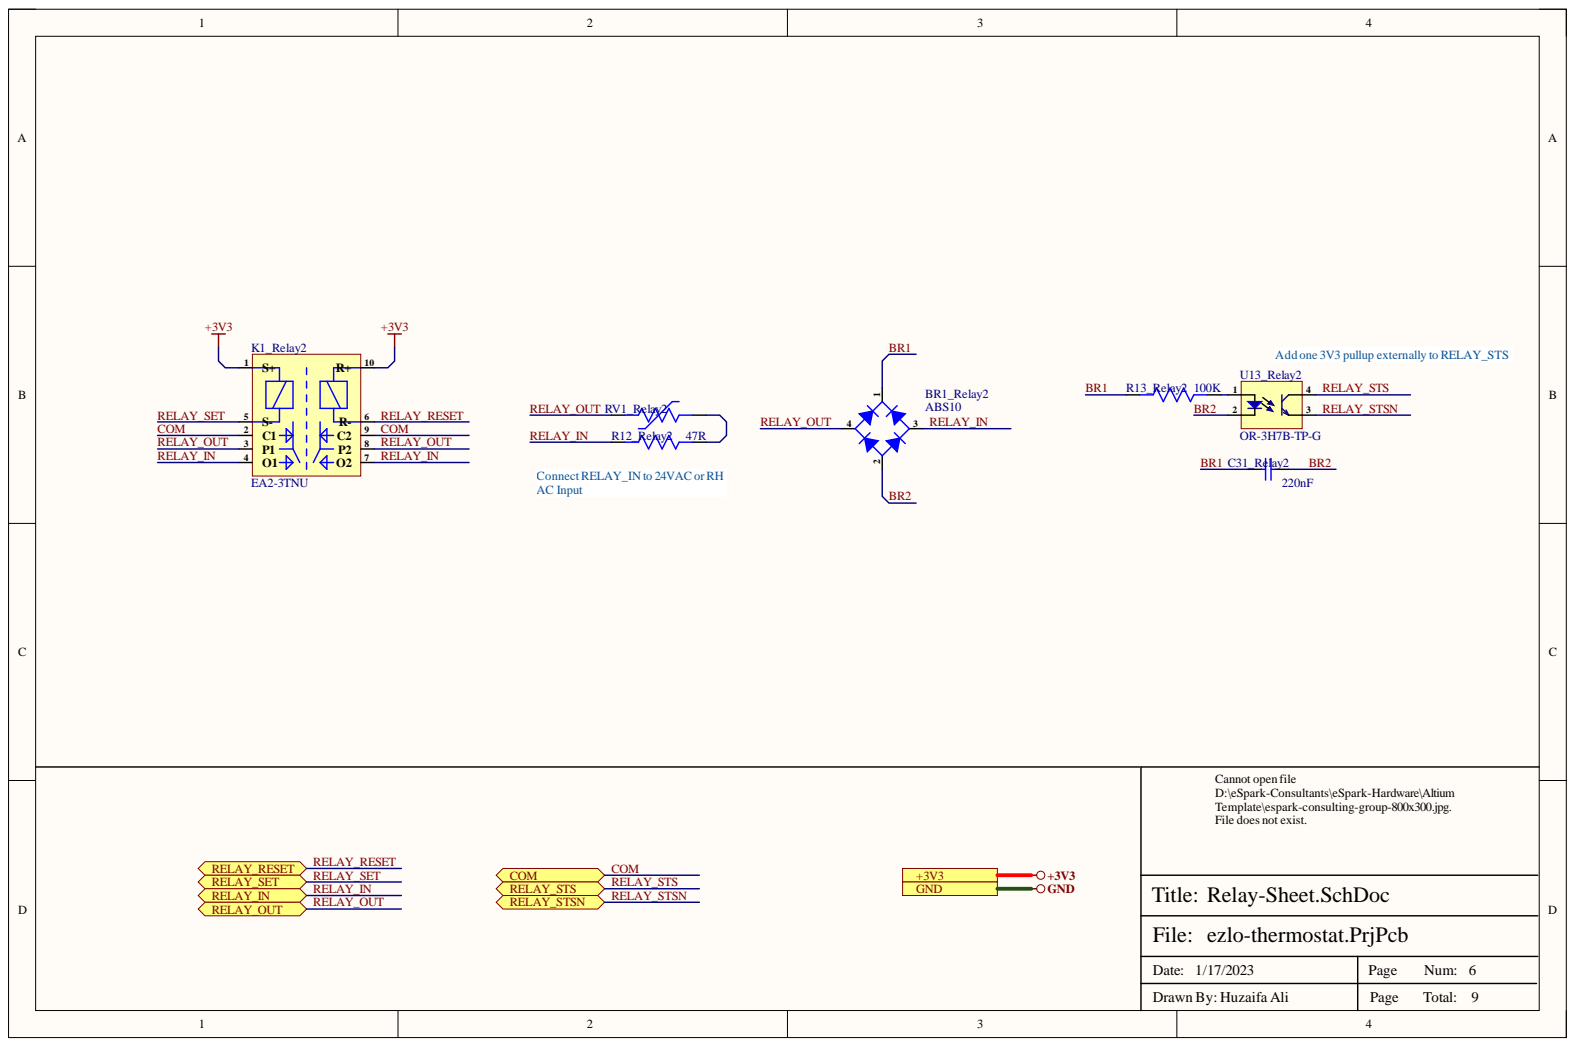
[picture p66: page 8]

Add one 3V3 pullup externally to RELAY_STS

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

Date: 1/17/2023 | Page Num: 6

Drawn By: Huzaifa Ali | Page Total: 9

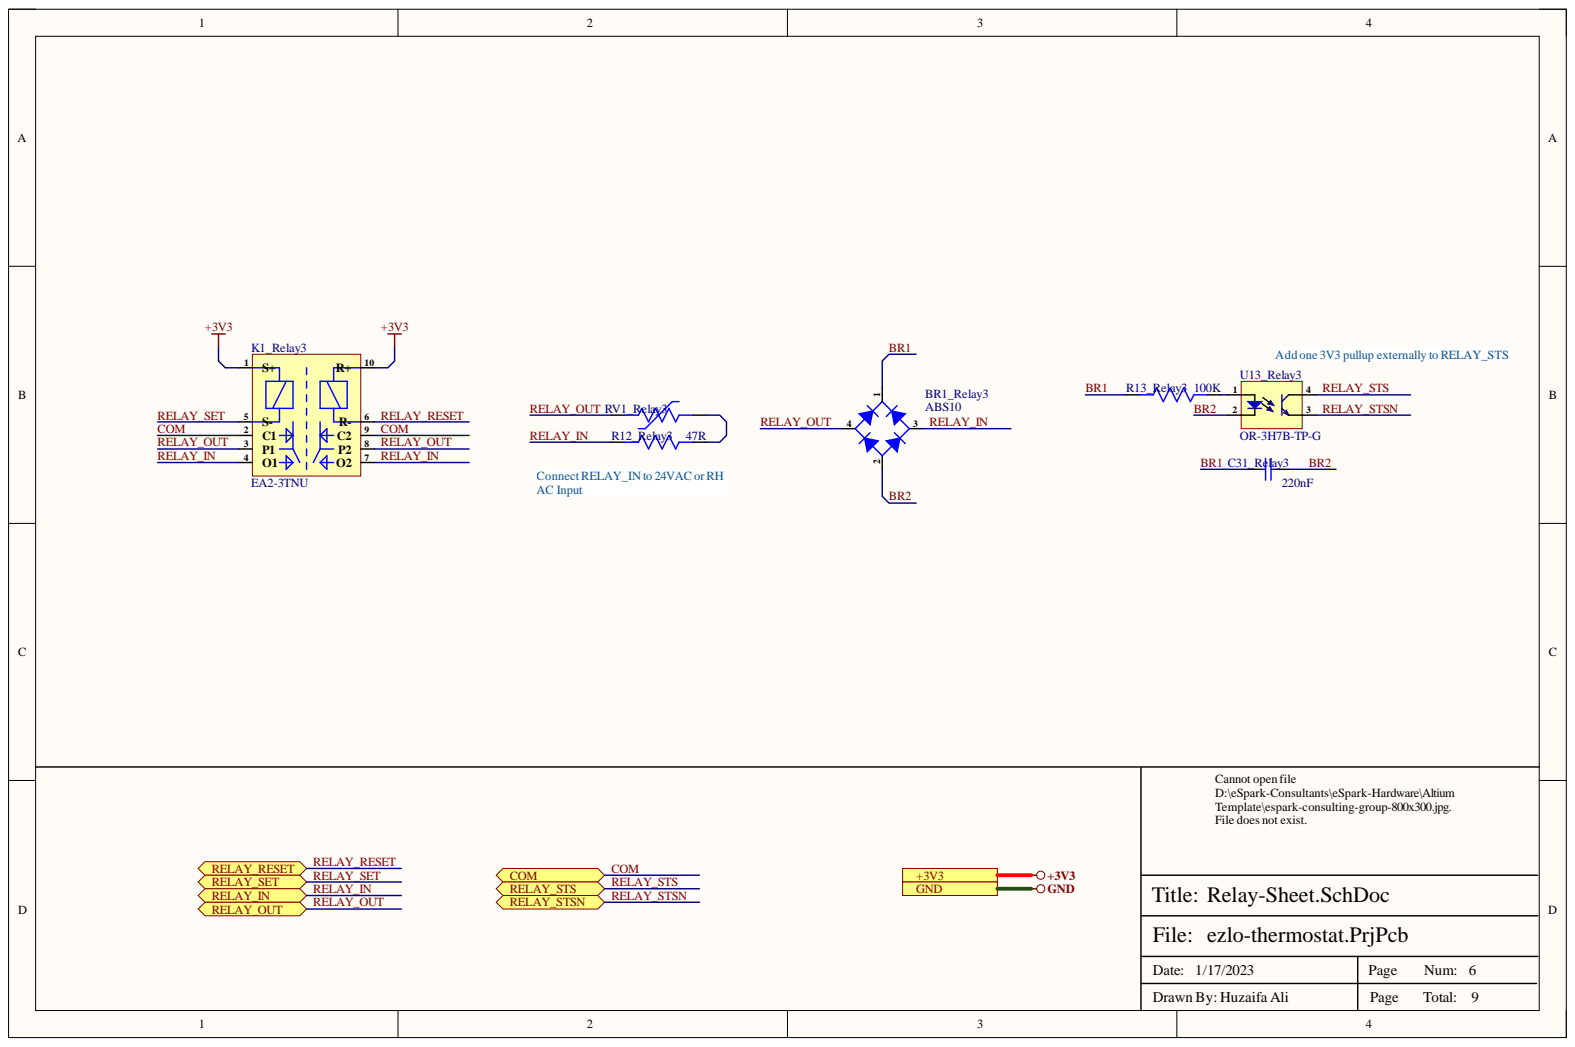
[picture p67: page 9]

Add one 3V3 pullup externally to RELAY_STS

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

Date: 1/17/2023 | Page Num: 6

Drawn By: Huzaifa Ali | Page Total: 9

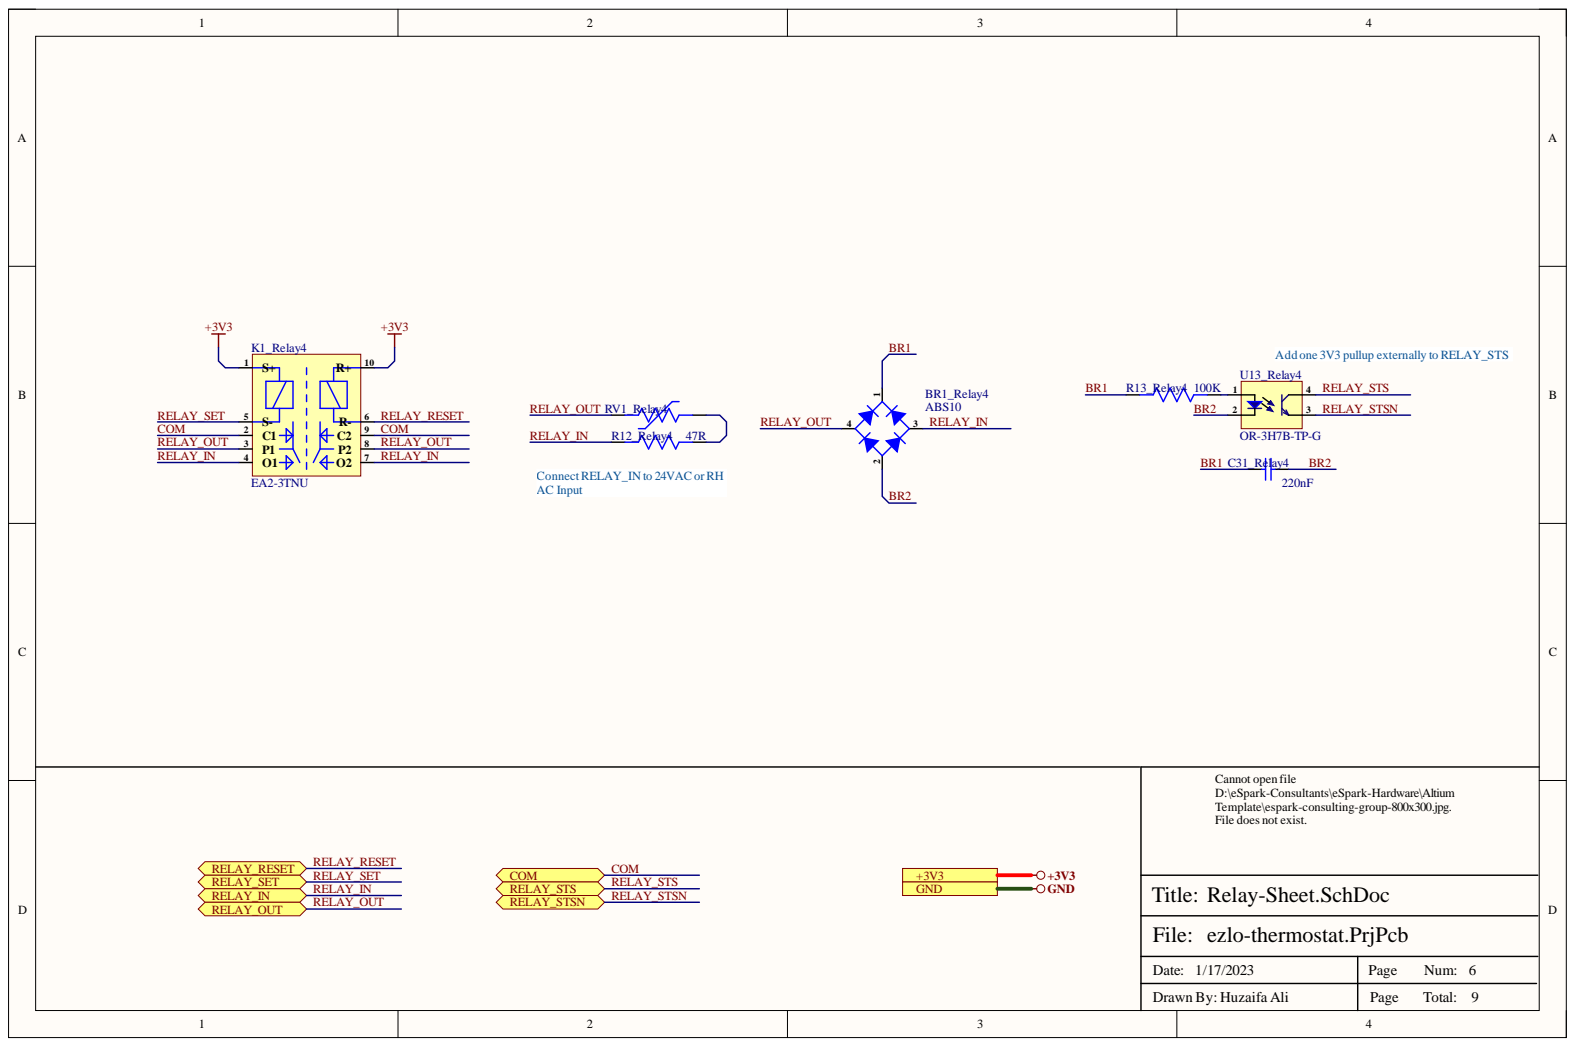
[picture p68: page 10]

Add one 3V3 pullup externally to RELAY_STS

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

Date: 1/17/2023 | Page Num: 6

Drawn By: Huzaifa Ali | Page Total: 9

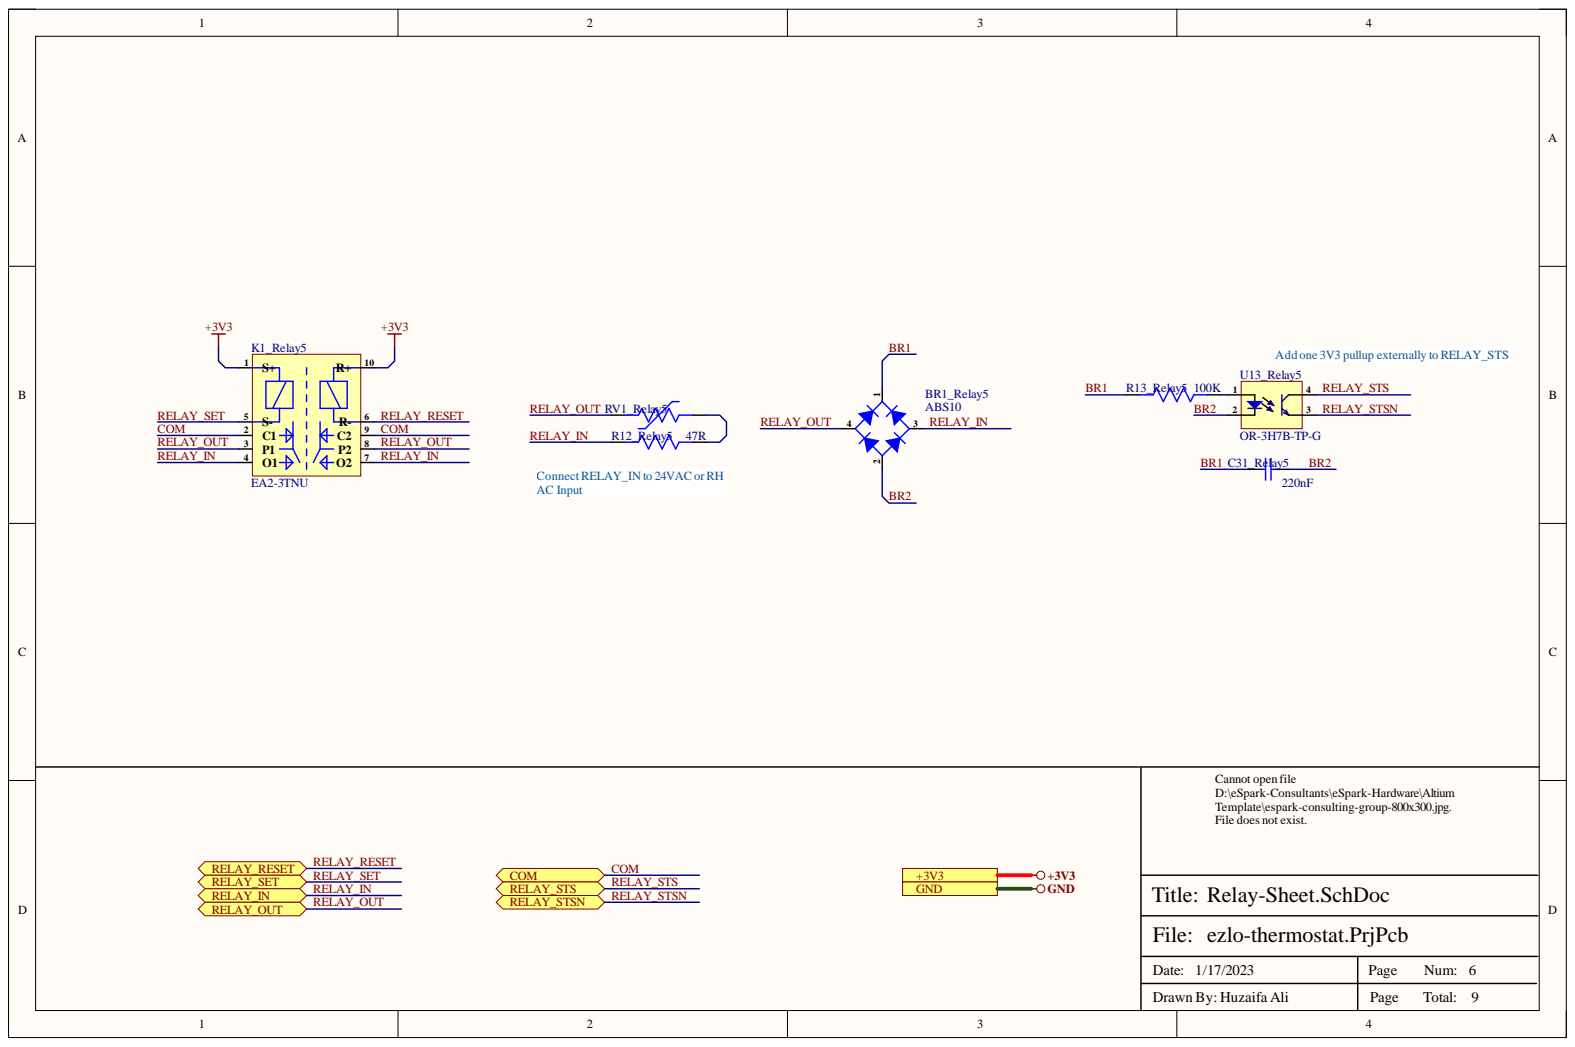
[picture p69: page 11]

Add one 3V3 pullup externally to RELAY_STS

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

Date: 1/17/2023 | Page Num: 6

Drawn By: Huzaifa Ali | Page Total: 9

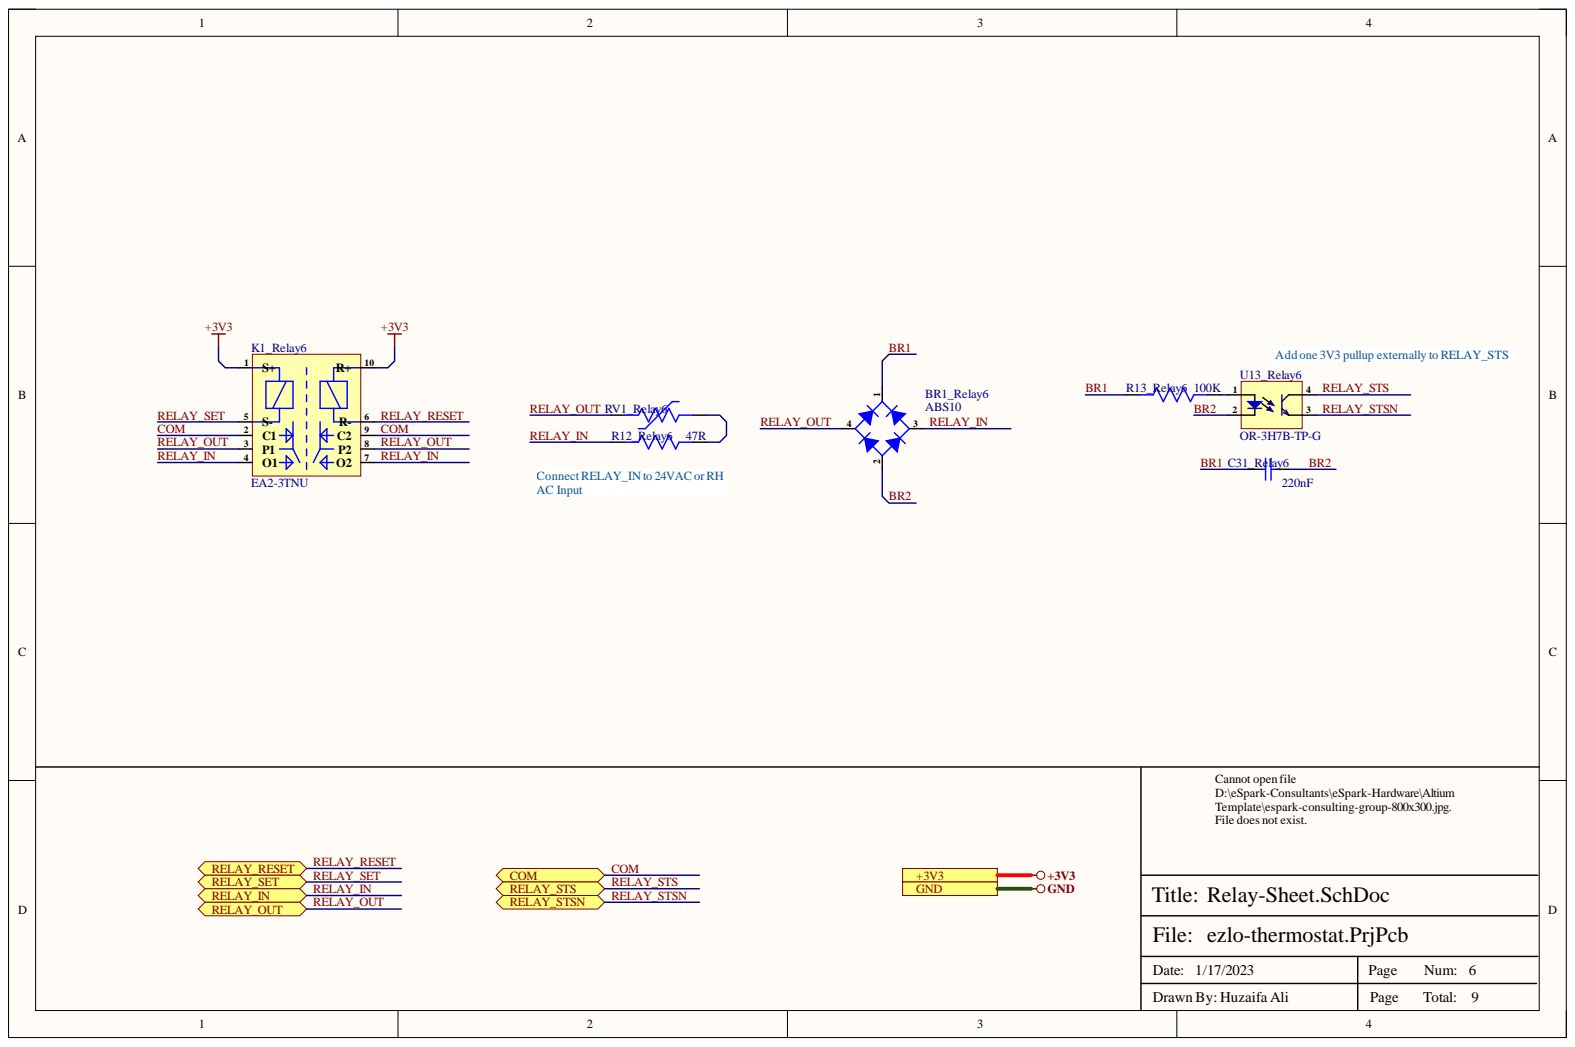
[picture p70: page 12]

Add one 3V3 pullup externally to RELAY_STS

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

Date: 1/17/2023 | Page Num: 6

Drawn By: Huzaifa Ali | Page Total: 9

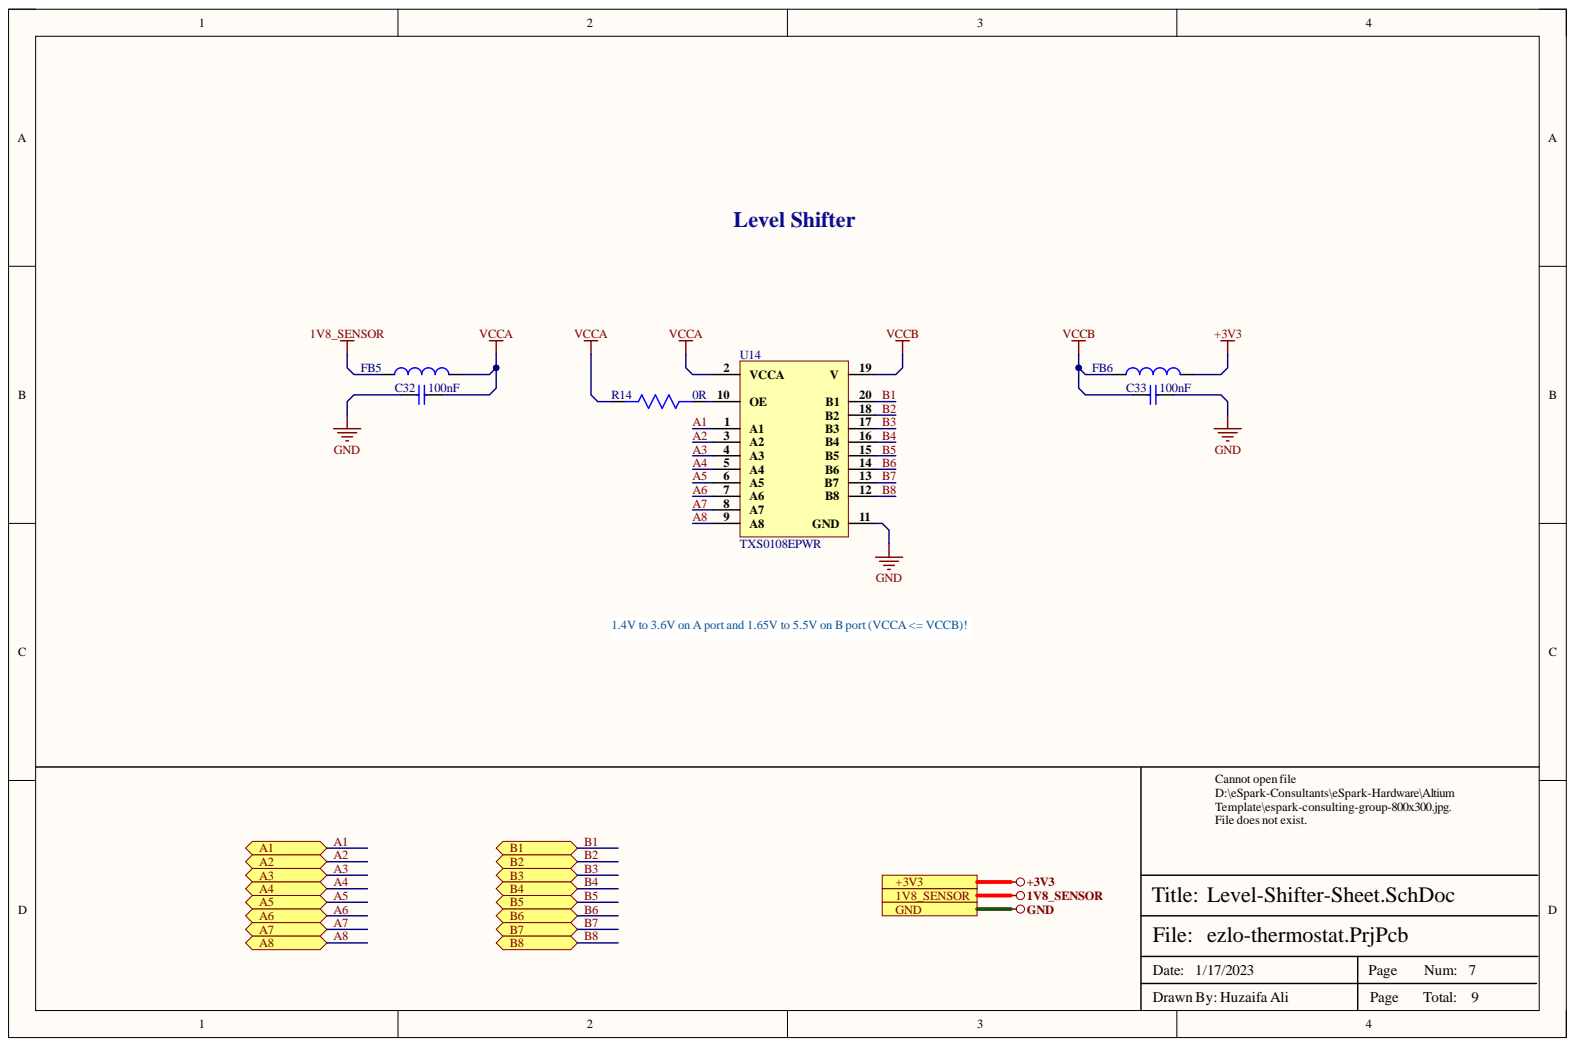
[picture p71: page 13]

1.4V to 3.6V on A port and 1.65V to 5.5V on B port (VCCA <= VCCB)!

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

Level-Shifter-Sheet.SchDoc

Date: 1/17/2023 | Page Num: 7

Drawn By: Huzaifa Ali | Page Total: 9

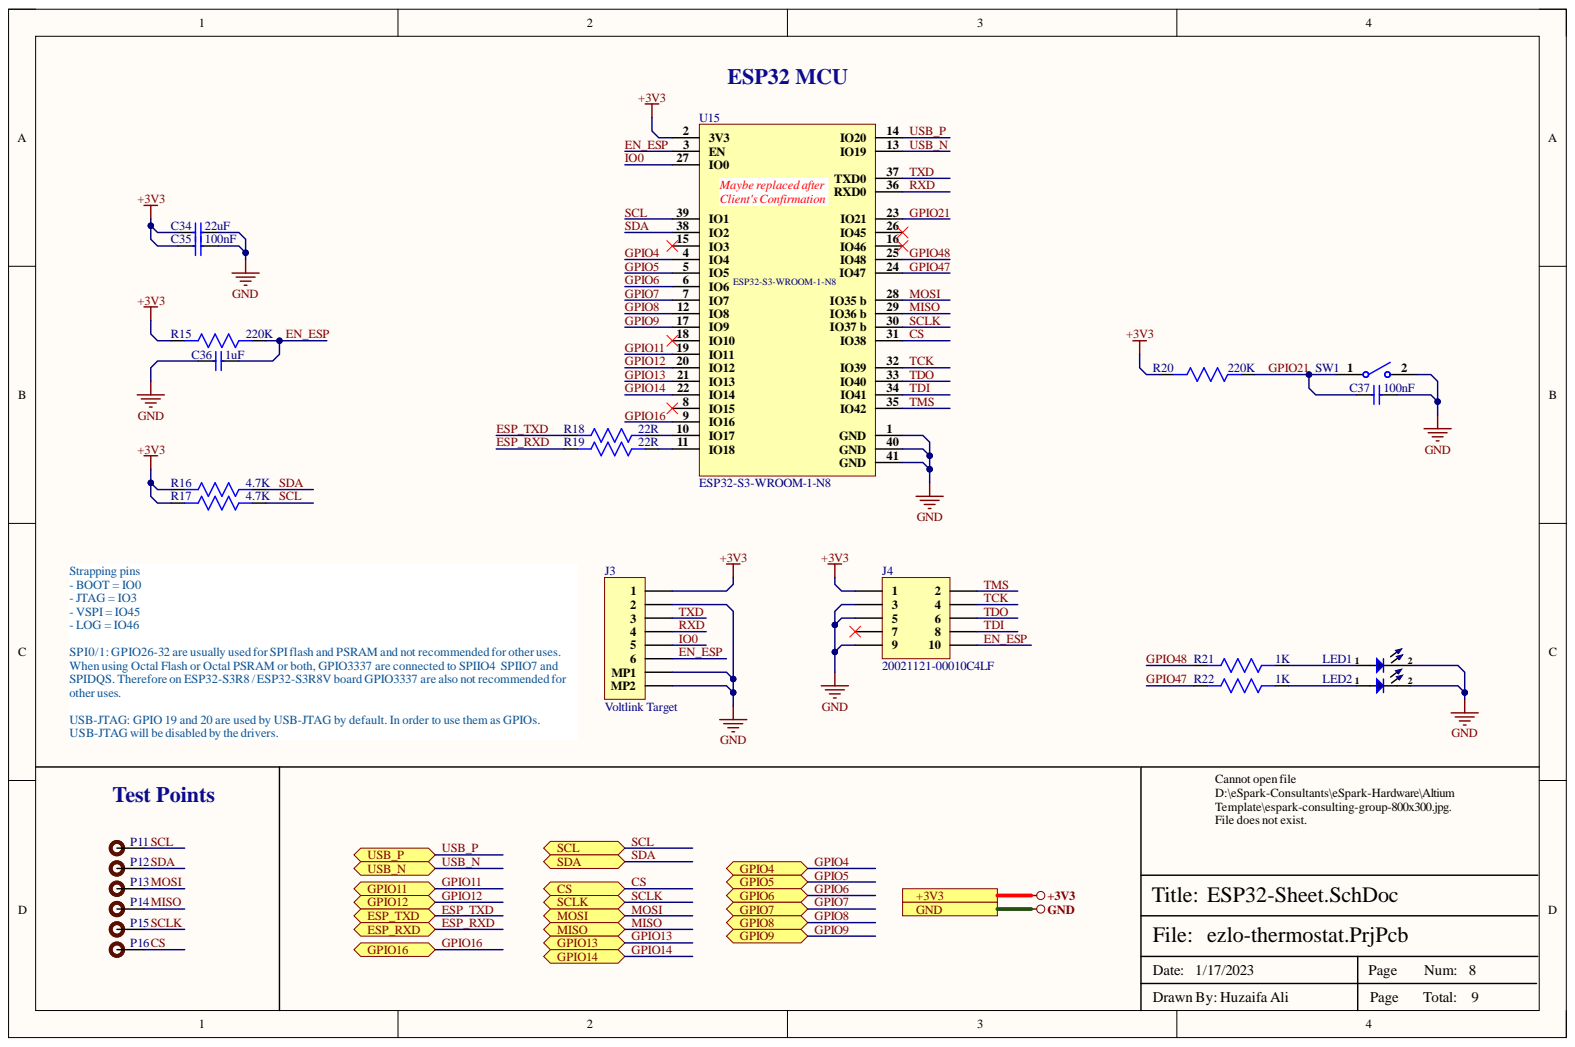
[picture p72: page 14]

SPI0/1: GPIO26-32 are usually used for SPIflash and PSRAM and not recommended for other uses.
When using Octal Flash or Octal PSRAM or both, GPIO3337 are connected to SPIIO4 SPIIO7 and
SPIDQS. Therefore on ESP32-S3R8 / ESP32-S3R8V board GPIO3337 are also not recommended for
other uses.

USB-JTAG: GPIO 19 and 20 are used by USB-JTAG by default. In order to use them as GPIOs.
USB-JTAG will be disabled by the drivers.

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

Date: 1/17/2023 | Page Num: 8

Drawn By: Huzaifa Ali | Page Total: 9

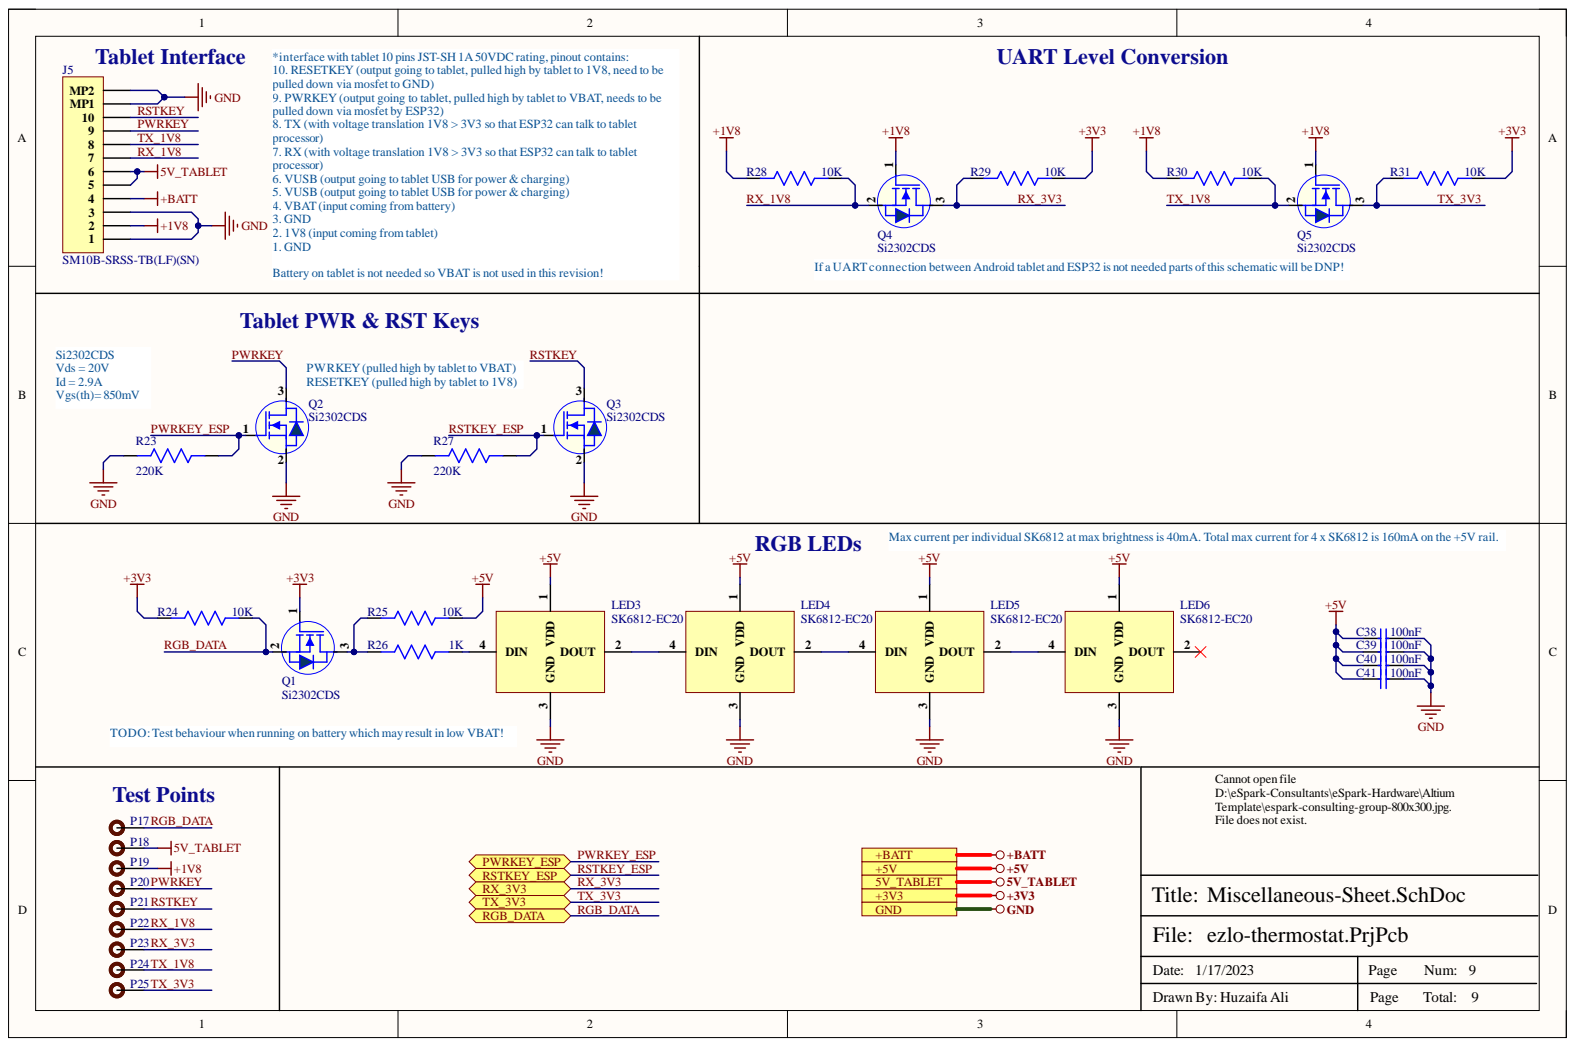
[picture p73: page 15]

*interface with tablet 10 pins JST-SH 1A50VDCrating, pinout contains:
10. RESETKEY (output going to tablet, pulled high by tablet to 1V8, need to be
pulled down via mosfet to GND)
9. PWRKEY (output going to tablet, pulled high by tablet to VBAT, needs to be
pulled down via mosfet by ESP32)
8. TX (with voltage translation 1V8 > 3V3 so that ESP32 can talk to tablet
processor)
7. RX (with voltage translation 1V8 > 3V3 so that ESP32 can talk to tablet
6. VUSB (output going to tablet USB for power & charging)
5. VUSB (output going to tablet USB for power & charging)
4. VBAT (input coming from battery)
3. GND
2. 1V8 (input coming from tablet)
1. GND

Tablet PWR & RST Keys

PWRKEY(pulled high by tablet to VBAT)
RESETKEY (pulled high by tablet to 1V8)

Max current per individual SK6812 at max brightness is 40mA. Total max current for 4 x SK6812 is 160mA on the +5V rail.

TODO: Test behaviour when running on battery which may result in low VBAT!

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

Date: 1/17/2023 | Page Num: 9

Drawn By: Huzaifa Ali | Page Total: 9
