eSpark-Backup/ezlo-thermostat/docs/Client Original Design/Adv thermostat revB Kicad/schematic adv thermostat revB.pdf

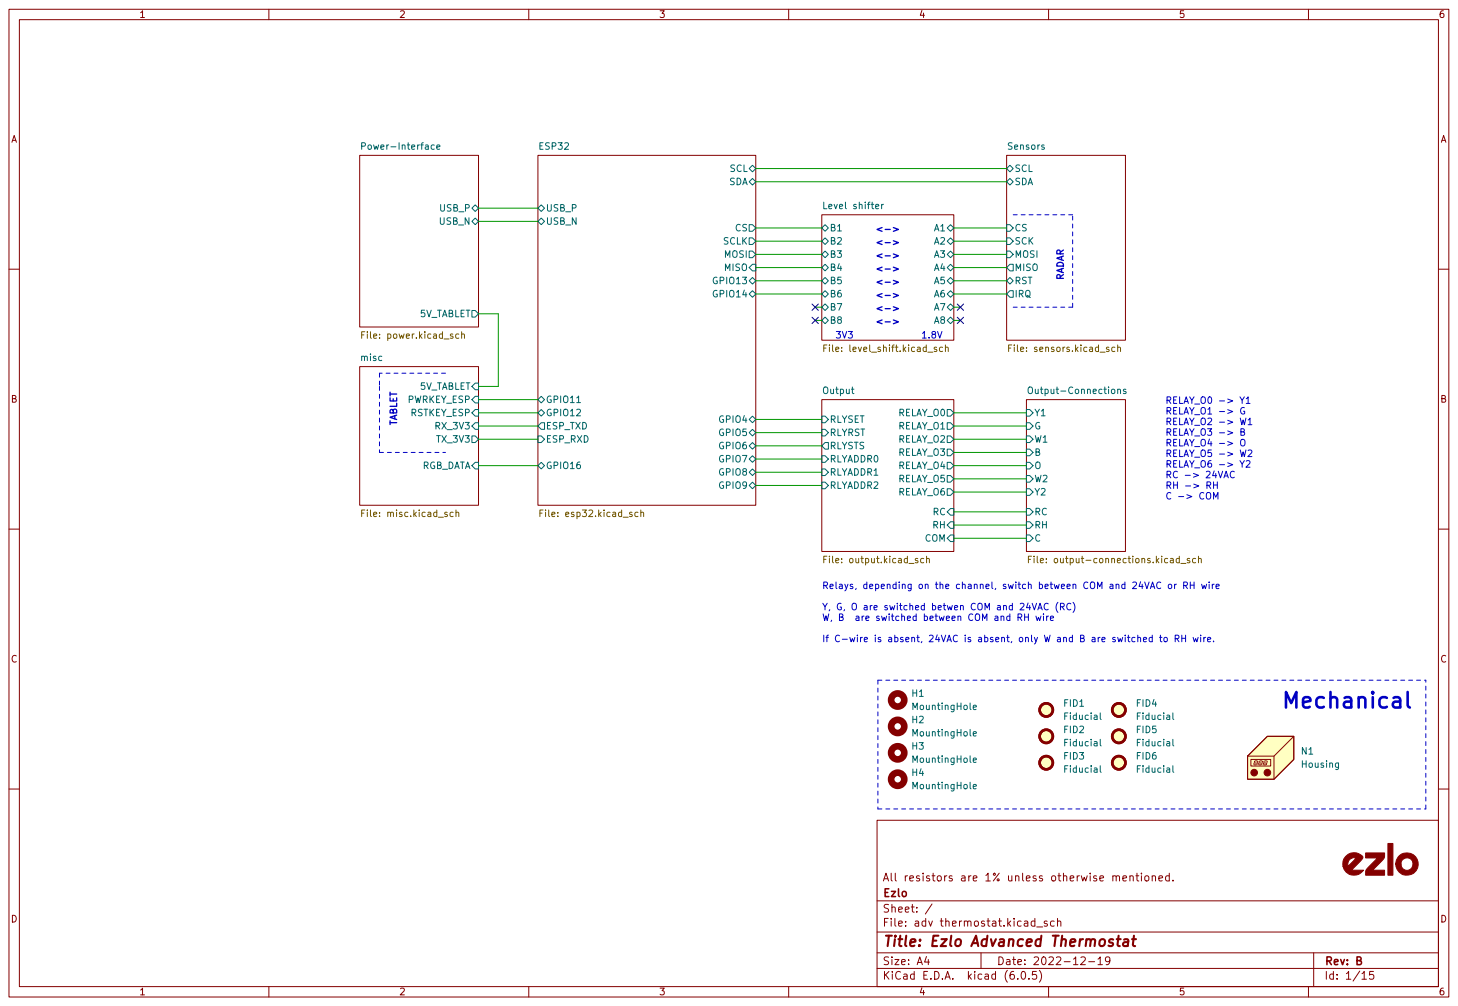
[picture p89: page 1]

Sensors File: sensors.kicad_sch SDA

Relays, depending on the channel, switch between COM and 24VAC or RH wire

Y, G, O are switched betwen COM and 24VAC (RC) W, B are switched between COM and RH wire

If C-wire is absent, 24VAC is absent, only W and B are switched to RH wire.

File: adv thermostat.kicad_sch Sheet: / Ezlo All resistors are 1% unless otherwise mentioned.

Id: 1/15 Title: Ezlo Advanced Thermostat

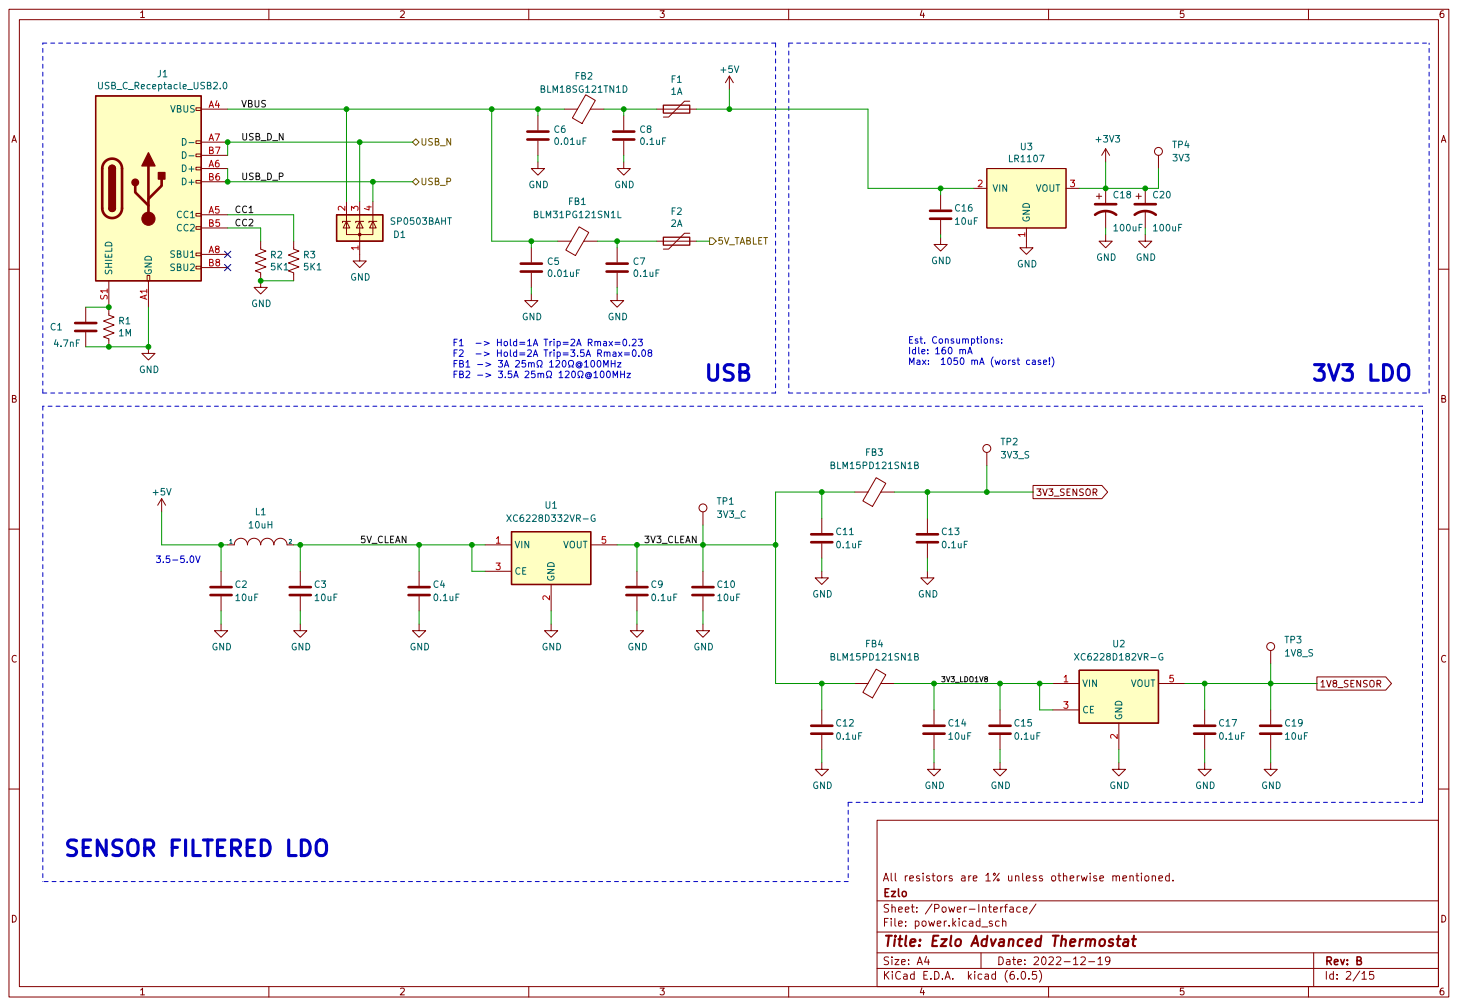
[picture p90: page 2]

Est. Consumptions:
Idle: 160 mA Max: 1050 mA (worst case!)

File: power.kicad_sch Sheet: /Power-Interface/ Ezlo All resistors are 1% unless otherwise mentioned. C2

Id: 2/15 Title: Ezlo Advanced Thermostat

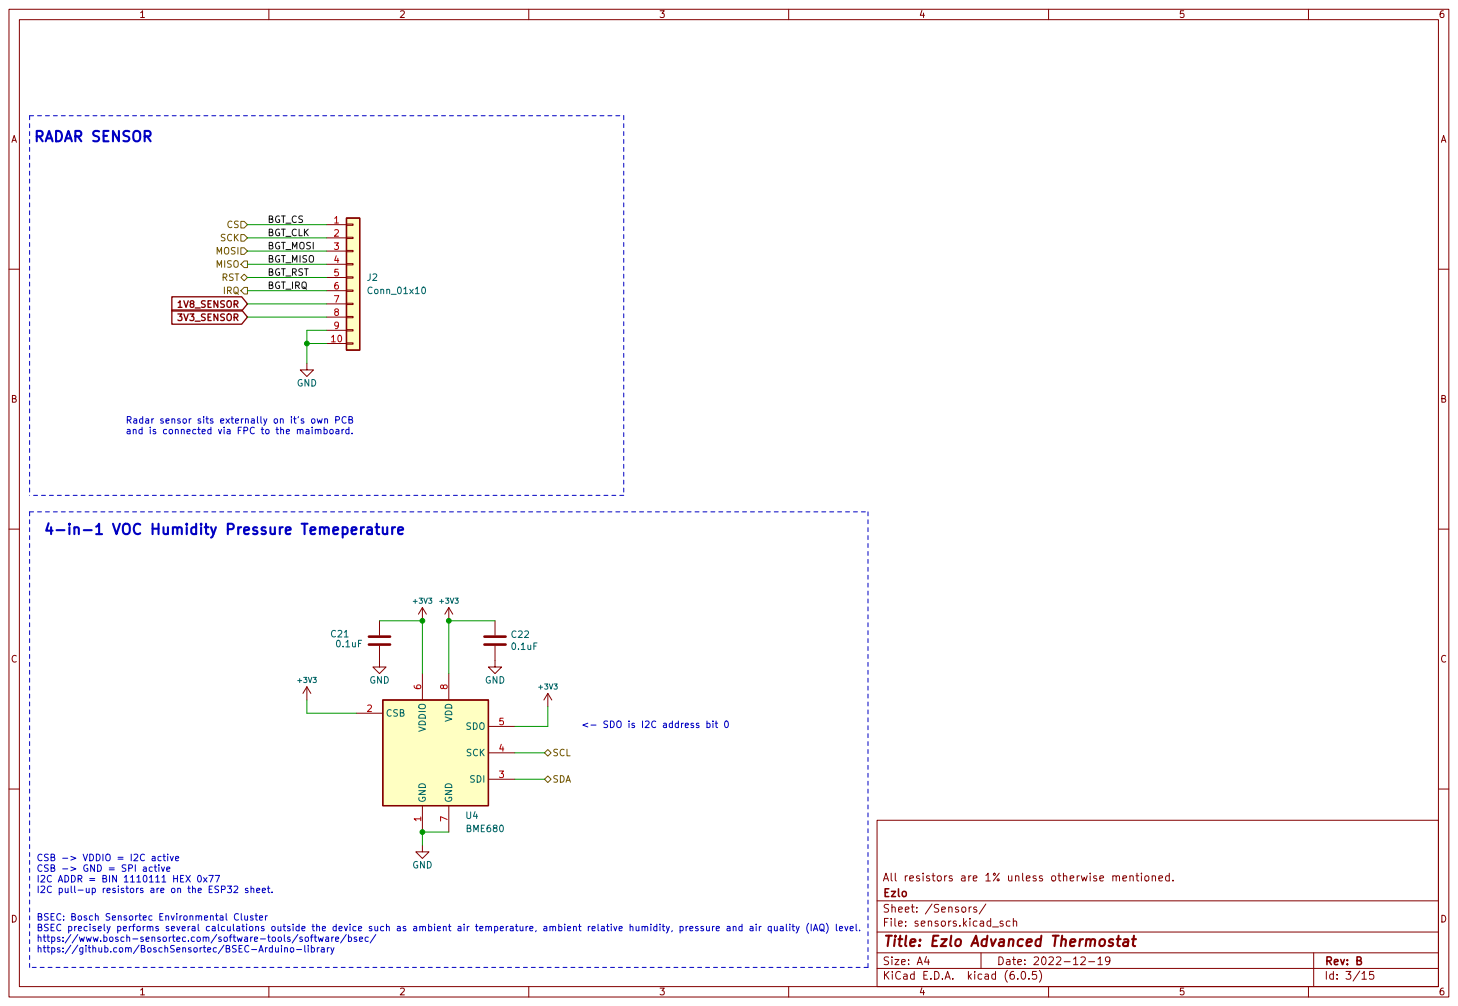
[picture p91: page 3]

and is connected via FPC to the maimboard. RADAR SENSOR

BGT_RST BGT_IRQ 4-in-1 VOC Humidity Pressure Temeperature

Radar sensor sits externally on it's own PCB

File: sensors.kicad_sch Sheet: /Sensors/ Ezlo All resistors are 1% unless otherwise mentioned. C22

1 CSB 2 SDI 3 SCK 4 SDO 5 VDDIO

<- SDO is I2C address bit 0 CSB -> VDDIO = I2C active CSB -> GND = SPI active

I2C ADDR = BIN 1110111 HEX 0x77
I2C pull-up resistors are on the ESP32 sheet.

BSEC: Bosch Sensortec Environmental Cluster BSEC precisely performs several calculations outside the device such as ambient air temperature, ambient relative humidity, pressure and air quality (IAQ) level.
https://www.bosch-sensortec.com/software-tools/software/bsec/
https://github.com/BoschSensortec/BSEC-Arduino-library

Id: 3/15 Title: Ezlo Advanced Thermostat

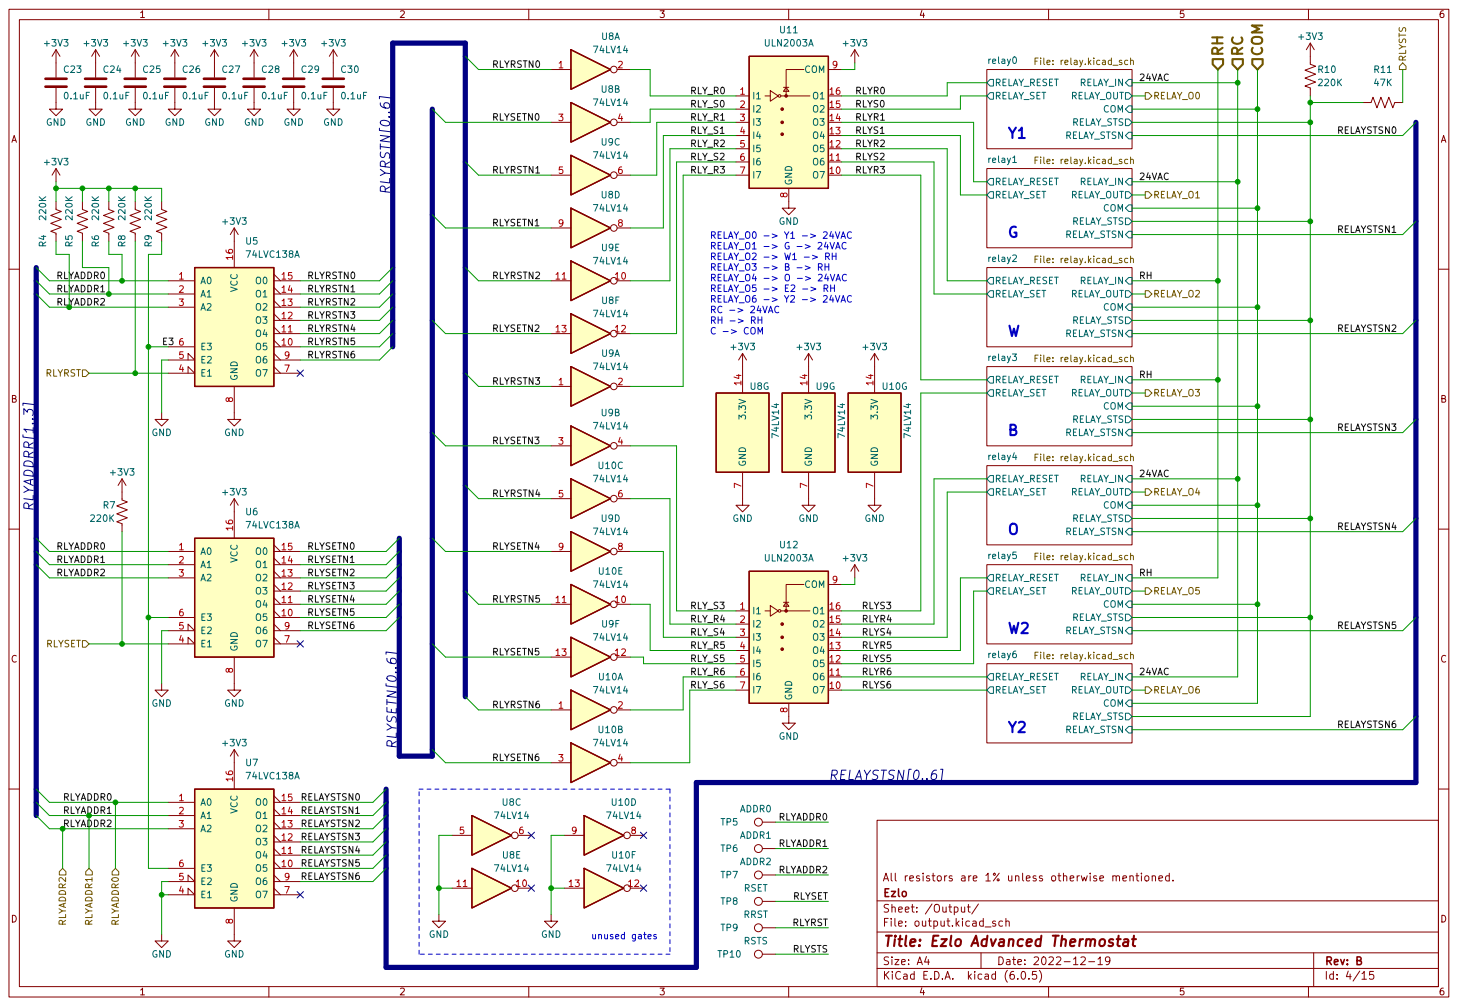
[picture p92: page 4]

Sheet: /Output/ Ezlo All resistors are 1% unless otherwise mentioned.

File: output.kicad_sch
Id: 4/15 Title: Ezlo Advanced Thermostat

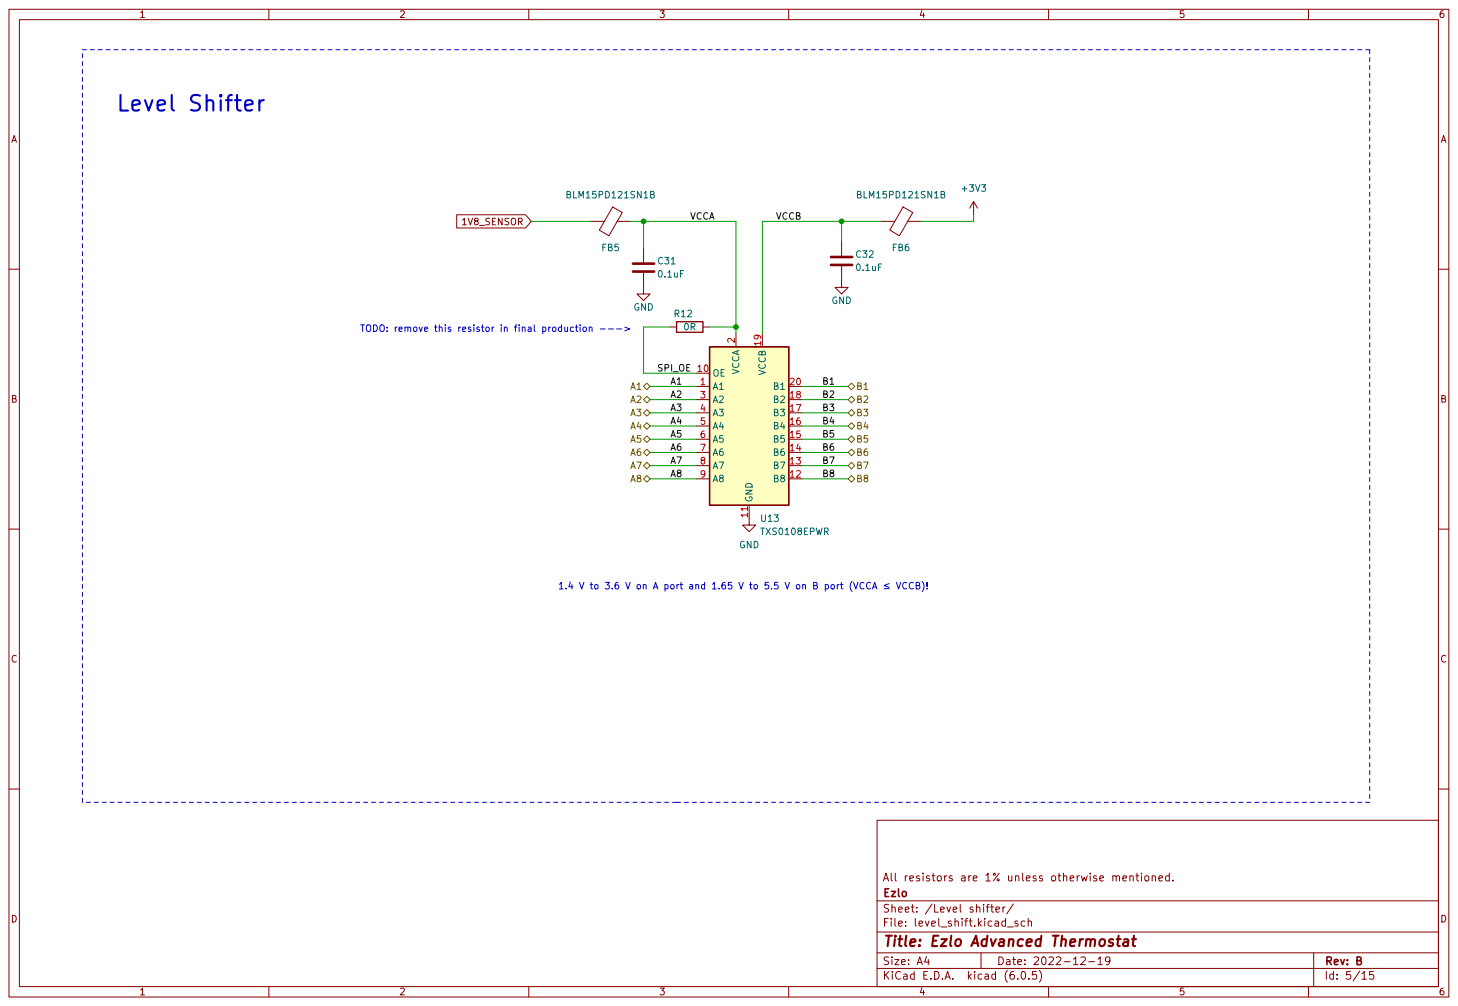
[picture p93: page 5]

File: level_shift.kicad_sch Sheet: /Level shifter/ Ezlo All resistors are 1% unless otherwise mentioned.

Id: 5/15 Title: Ezlo Advanced Thermostat

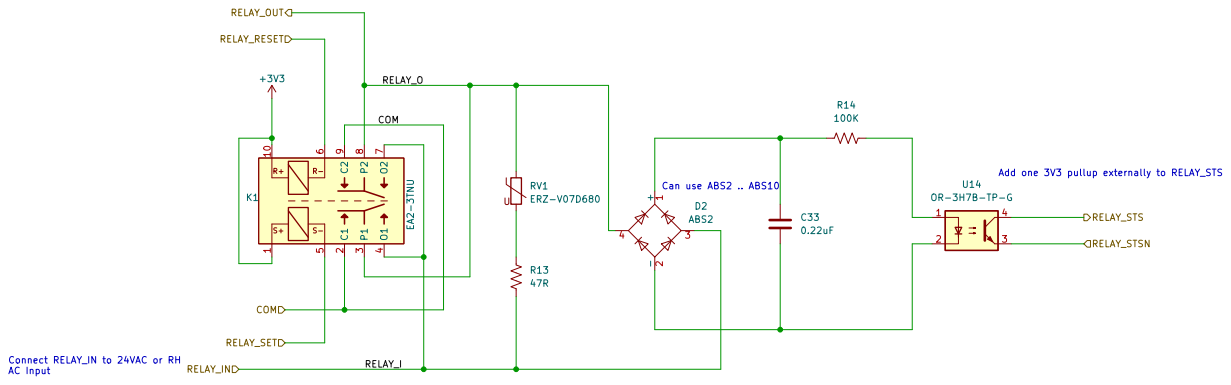
[picture p94: page 6]

Sheet: /Output/relay0/ Ezlo All resistors are 1% unless otherwise mentioned. R13

File: relay.kicad_sch
Id: 6/15 Title: Ezlo Advanced Thermostat

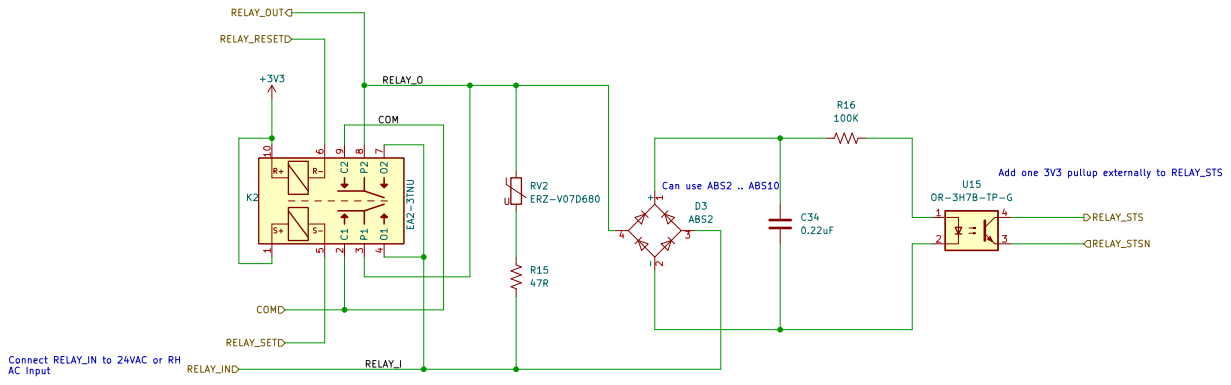
[picture p95: page 7]

Sheet: /Output/relay1/ Ezlo All resistors are 1% unless otherwise mentioned. R15

File: relay.kicad_sch
Id: 7/15 Title: Ezlo Advanced Thermostat

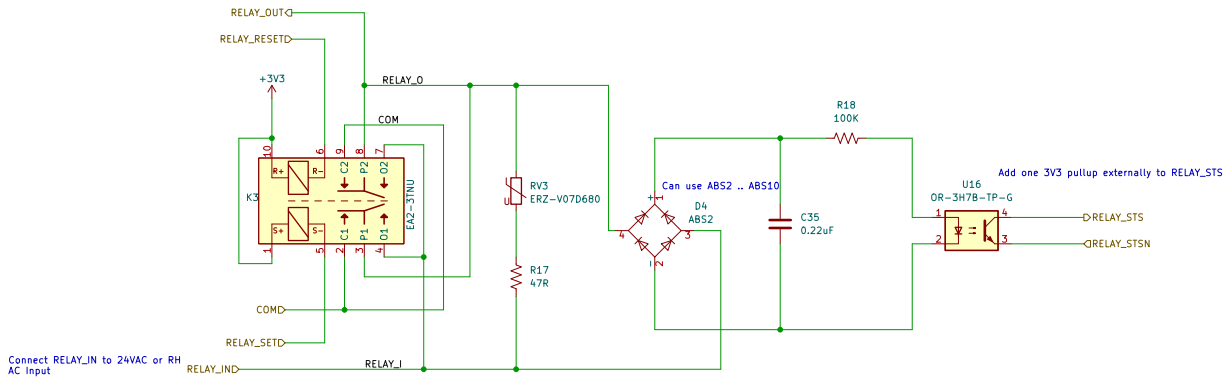
[picture p96: page 8]

Sheet: /Output/relay2/ Ezlo All resistors are 1% unless otherwise mentioned. R17

File: relay.kicad_sch
Id: 8/15 Title: Ezlo Advanced Thermostat

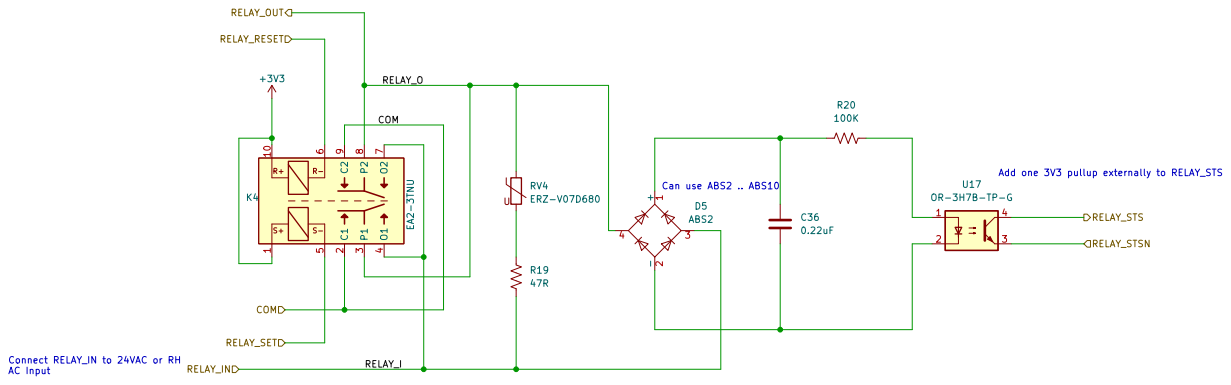
[picture p97: page 9]

Sheet: /Output/relay3/ Ezlo All resistors are 1% unless otherwise mentioned. R19

File: relay.kicad_sch
Id: 9/15 Title: Ezlo Advanced Thermostat

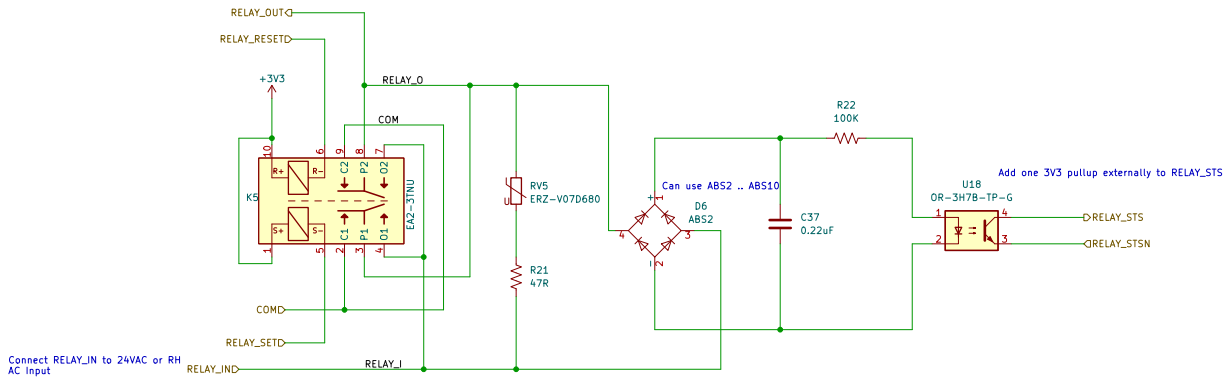
[picture p98: page 10]

Sheet: /Output/relay4/ Ezlo All resistors are 1% unless otherwise mentioned. R21

File: relay.kicad_sch
Id: 10/15 Title: Ezlo Advanced Thermostat

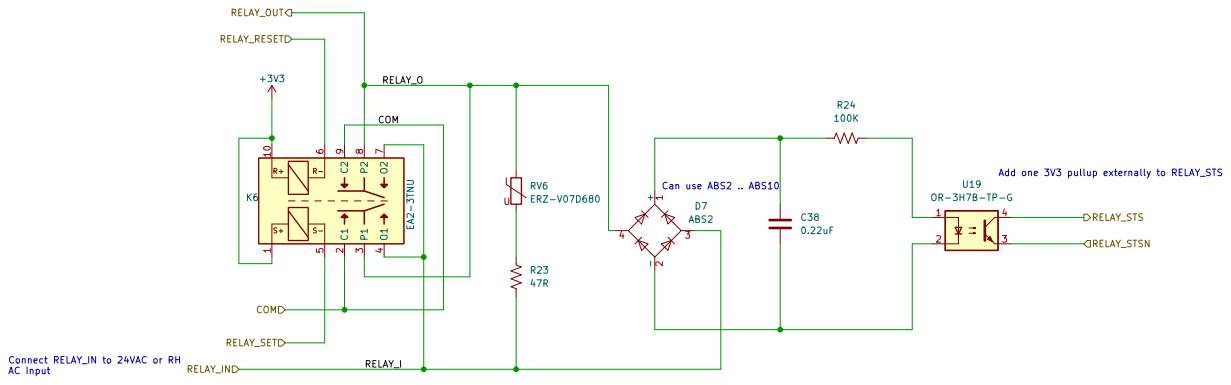
[picture p99: page 11]

Sheet: /Output/relay5/ Ezlo All resistors are 1% unless otherwise mentioned. R23

File: relay.kicad_sch
Id: 11/15 Title: Ezlo Advanced Thermostat

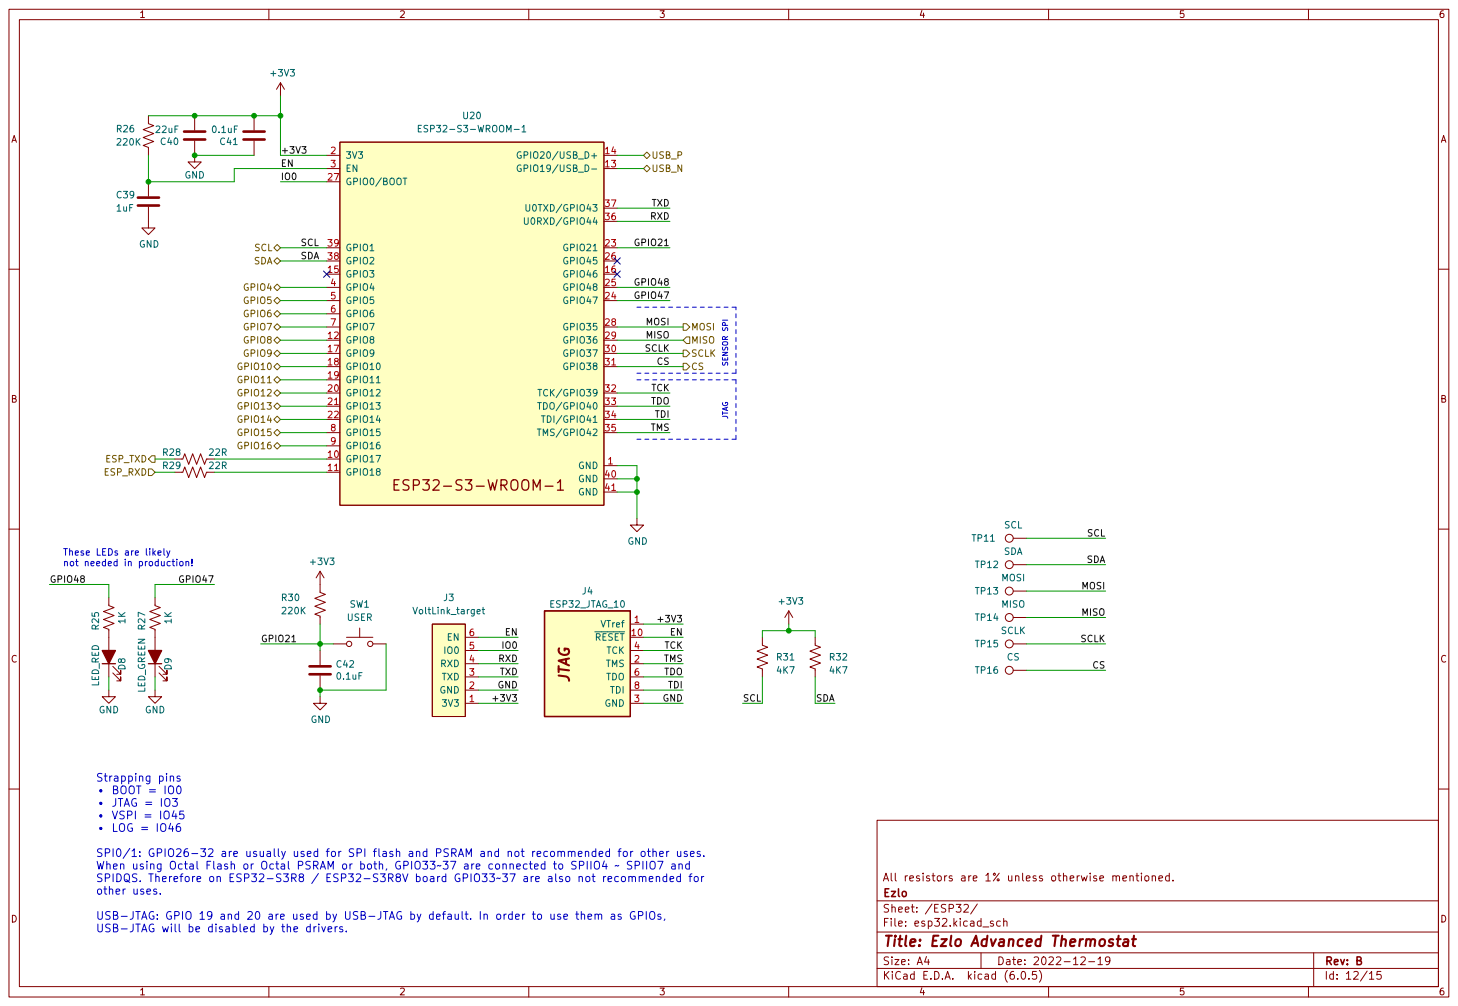
[picture p100: page 12]

SDA MOSI SCL TXD

These LEDs are likely

File: esp32.kicad_sch Sheet: /ESP32/ Ezlo All resistors are 1% unless otherwise mentioned. TP12 SDA GND

SPI0/1: GPIO26-32 are usually used for SPI flash and PSRAM and not recommended for other uses.
When using Octal Flash or Octal PSRAM or both, GPIO33~37 are connected to SPIIO4 ~ SPIIO7 and
SPIDQS. Therefore on ESP32-S3R8 / ESP32-S3R8V board GPIO33~37 are also not recommended for other uses. USB-JTAG: GPIO 19 and 20 are used by USB-JTAG by default. In order to use them as GPIOs,

Id: 12/15 Title: Ezlo Advanced Thermostat

USB-JTAG will be disabled by the drivers.

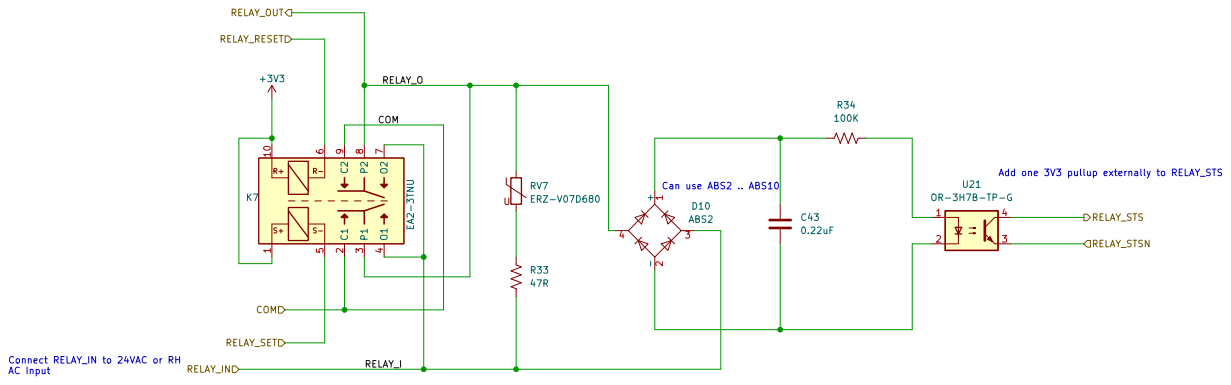
[picture p101: page 13]

Sheet: /Output/relay6/ Ezlo All resistors are 1% unless otherwise mentioned. R33

File: relay.kicad_sch
Id: 12/15 Title: Ezlo Advanced Thermostat

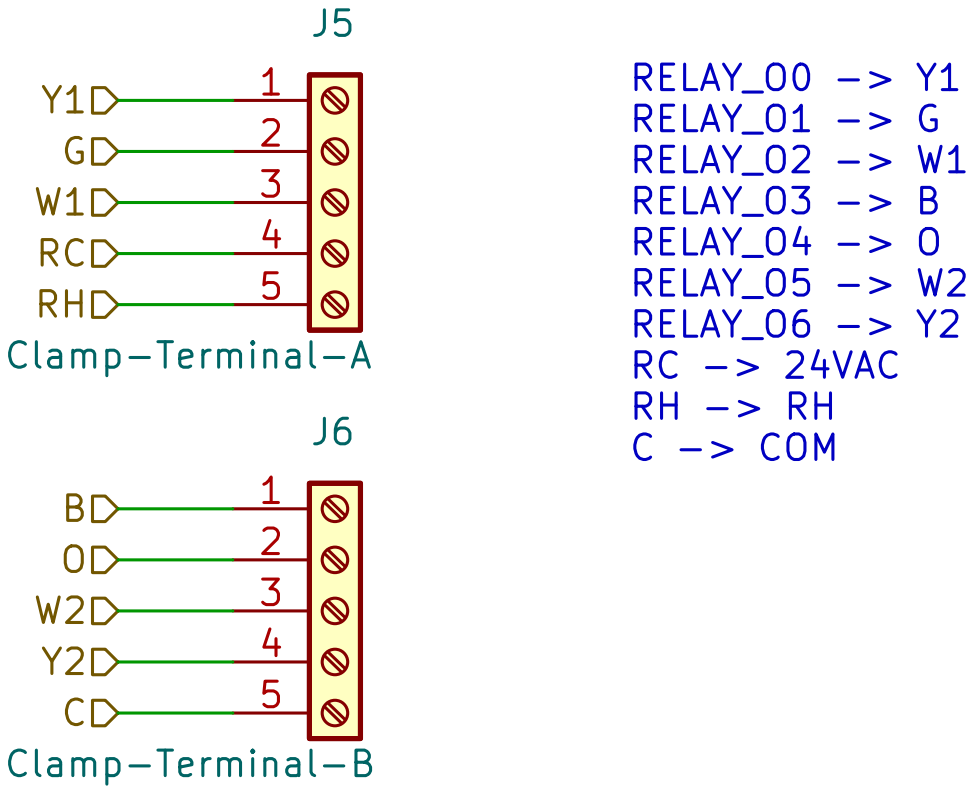
[picture p102: page 14]

Sheet: /Output-Connections/ Ezlo All resistors are 1% unless otherwise mentioned.

File: output-connections.kicad_sch
Id: 13/15 Title: Ezlo Advanced Thermostat

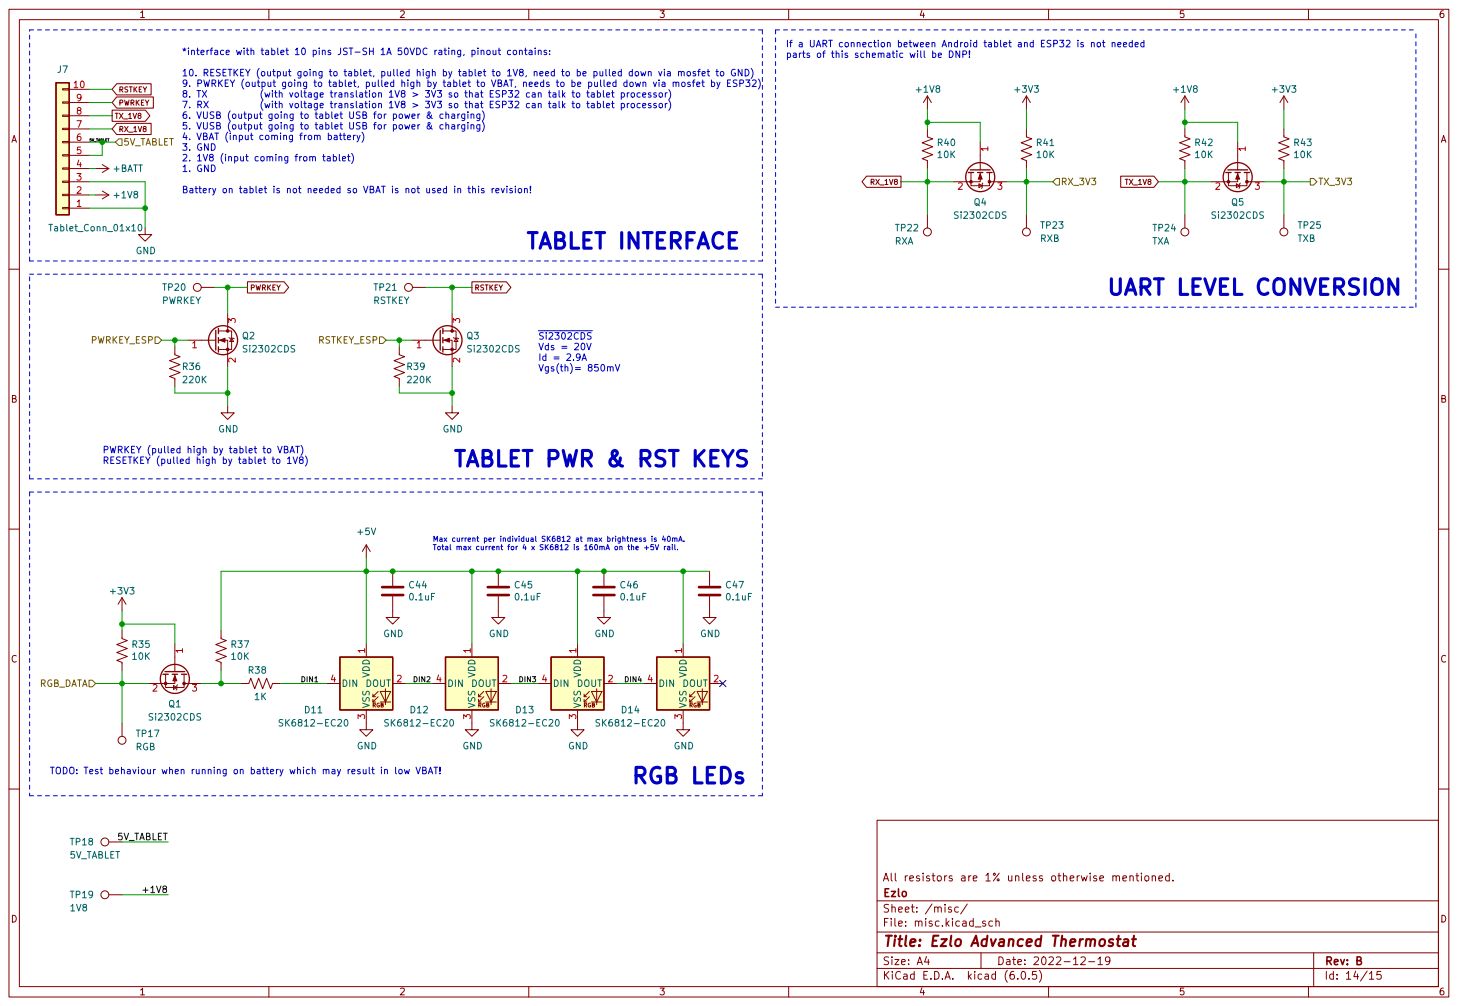
[picture p103: page 15]

If a UART connection between Android tablet and ESP32 is not needed
parts of this schematic will be DNP!

10. RESETKEY (output going to tablet, pulled high by tablet to 1V8, need to be pulled down via mosfet to GND)
9. PWRKEY (output going to tablet, pulled high by tablet to VBAT, needs to be pulled down via mosfet by ESP32)
8. TX (with voltage translation 1V8 > 3V3 so that ESP32 can talk to tablet processor)
7. RX (with voltage translation 1V8 > 3V3 so that ESP32 can talk to tablet processor)
6. VUSB (output going to tablet USB for power & charging)
5. VUSB (output going to tablet USB for power & charging)
4. VBAT (input coming from battery) 3. GND

2. 1V8 (input coming from tablet) 1. GND

Battery on tablet is not needed so VBAT is not used in this revision!

PWRKEY (pulled high by tablet to VBAT)
RESETKEY (pulled high by tablet to 1V8)

Max current per individual SK6812 at max brightness is 40mA. Total max current for 4 x SK6812 is 160mA on the +5V rail. TABLET PWR & RST KEYS

TODO: Test behaviour when running on battery which may result in low VBAT!

File: misc.kicad_sch Sheet: /misc/ Ezlo All resistors are 1% unless otherwise mentioned.

Id: 14/15 Title: Ezlo Advanced Thermostat
