eSpark-Backup/ezlo-thermostat/docs/Client Original Design/Radar Sensor PCB revA Kicad/radar schematic revA.pdf

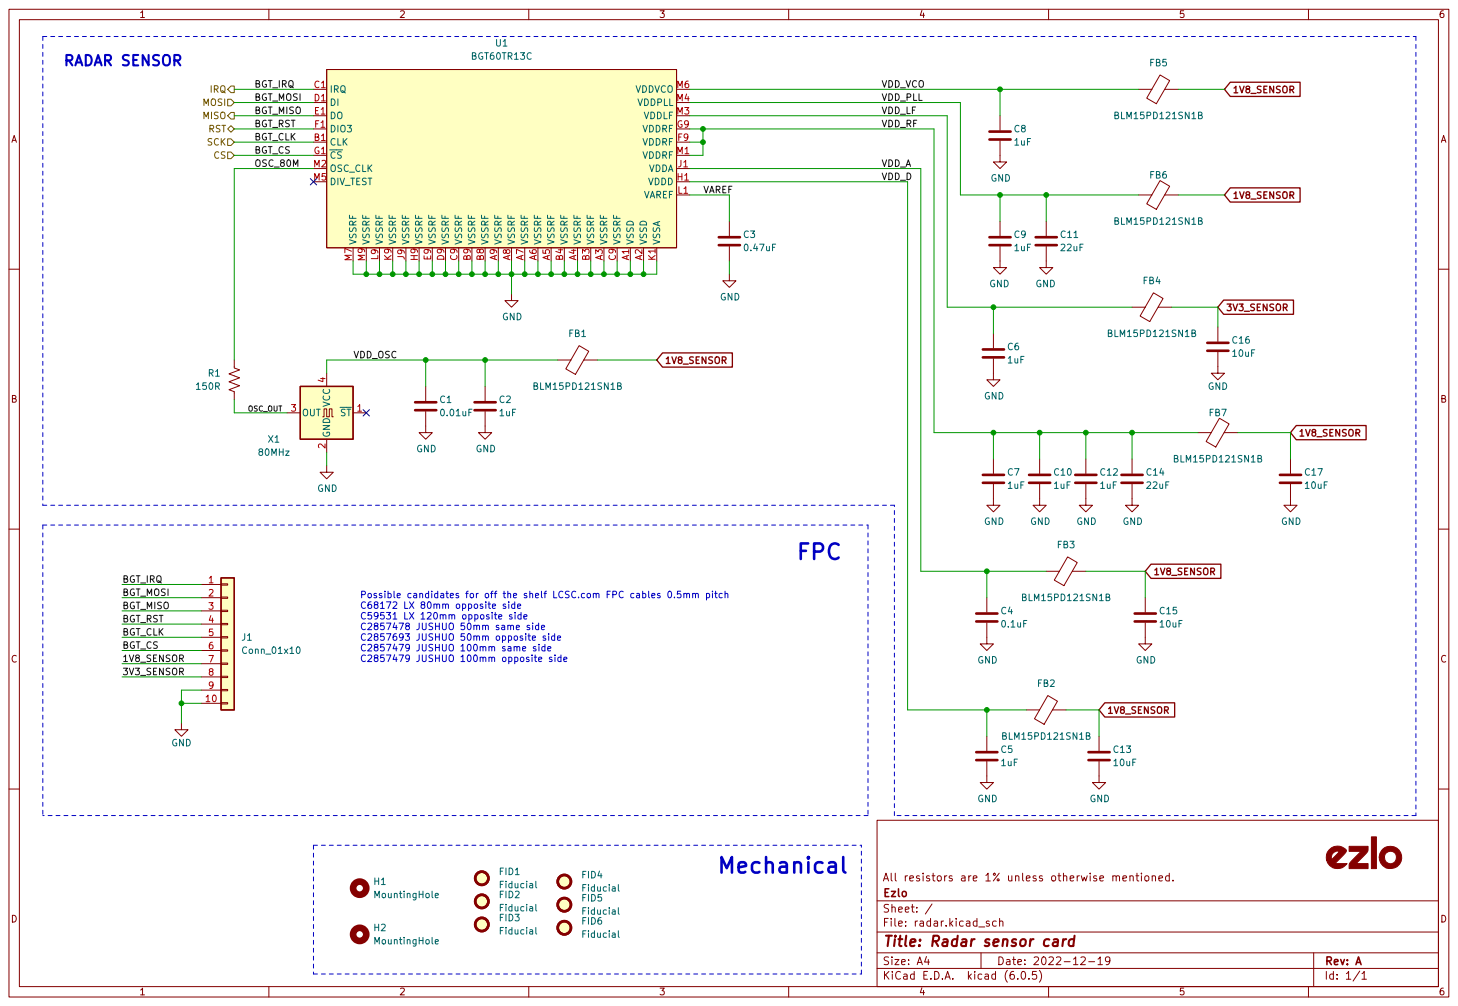
[picture p104: page 1]

Possible candidates for off the shelf LCSC.com FPC cables 0.5mm pitch
C68172 LX 80mm opposite side
C59531 LX 120mm opposite side C2857478 JUSHUO 50mm same side C2857693 JUSHUO 50mm opposite side C2857479 JUSHUO 100mm same side C2857479 JUSHUO 100mm opposite side

File: radar.kicad_sch Sheet: / Ezlo All resistors are 1% unless otherwise mentioned.

Id: 1/1 Title: Radar sensor card
