eSpark-Backup/ezlo-thermostat/Deliverables/Schematics/Assembly_drawing.pdf

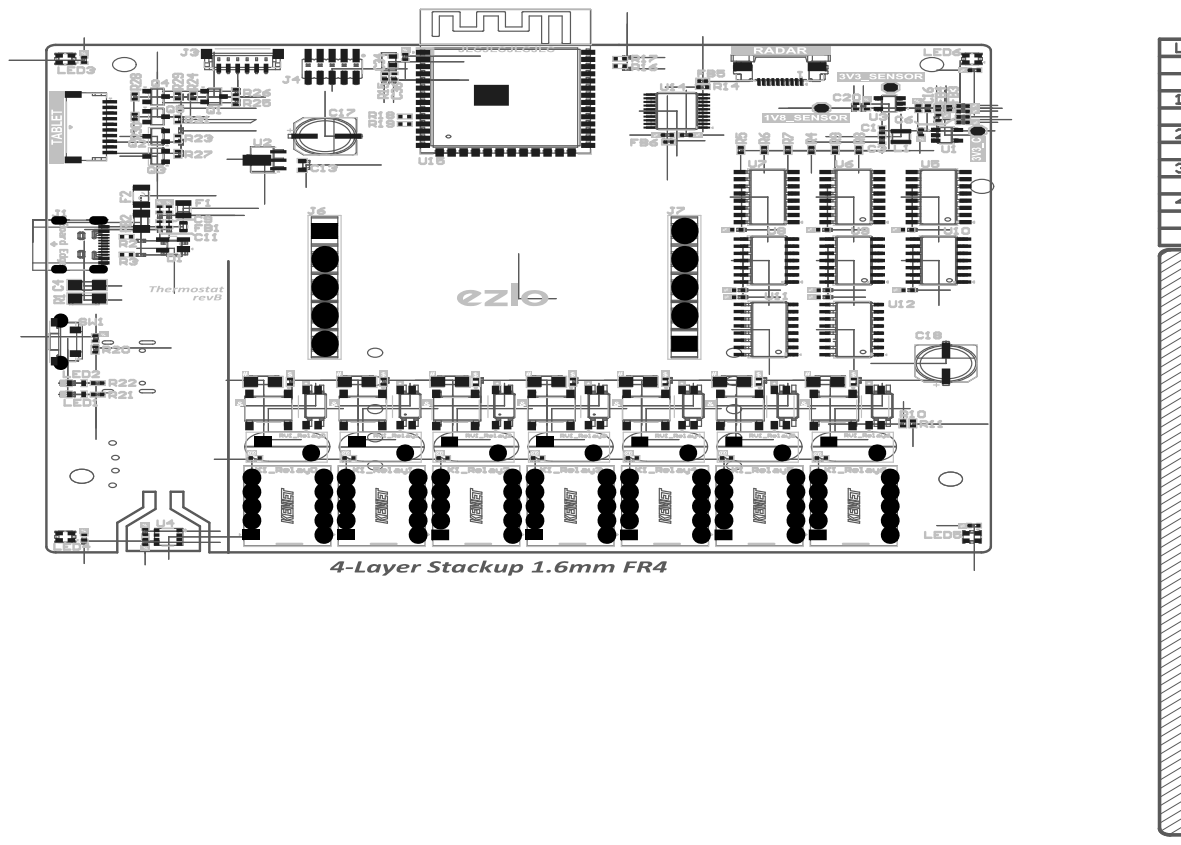
[picture p105: page 1]

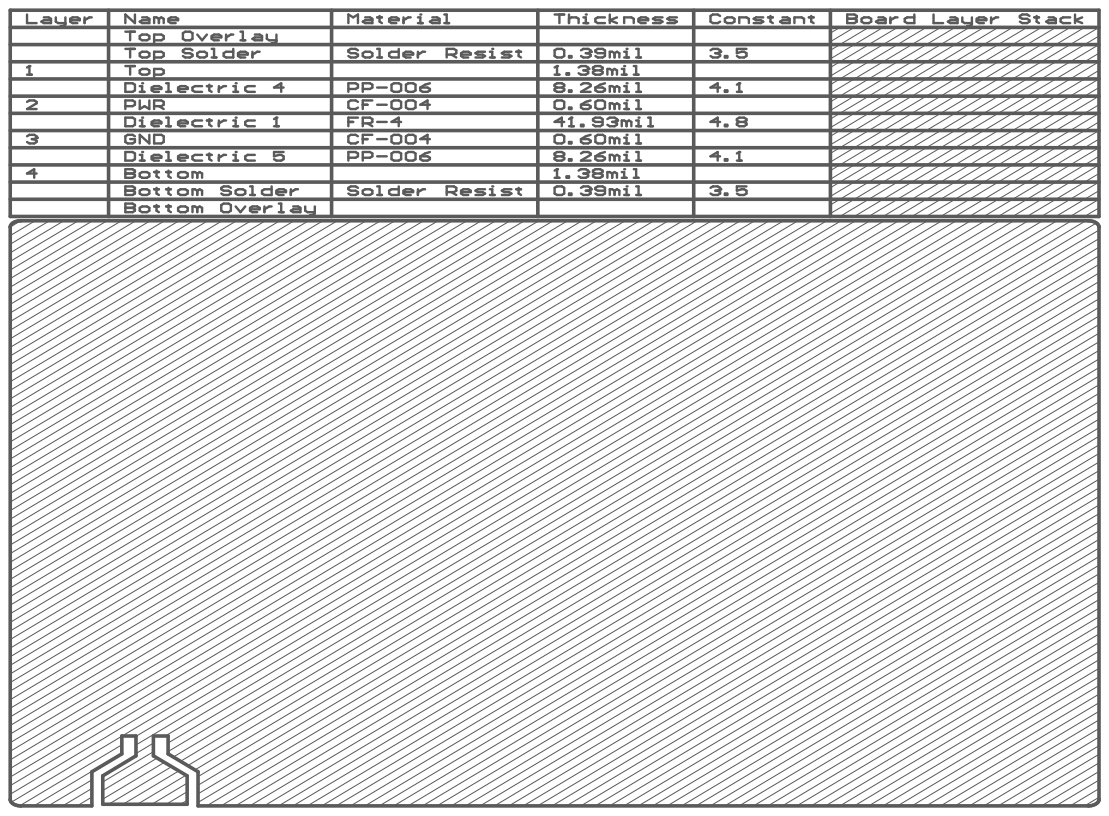
[picture p106: page 2]

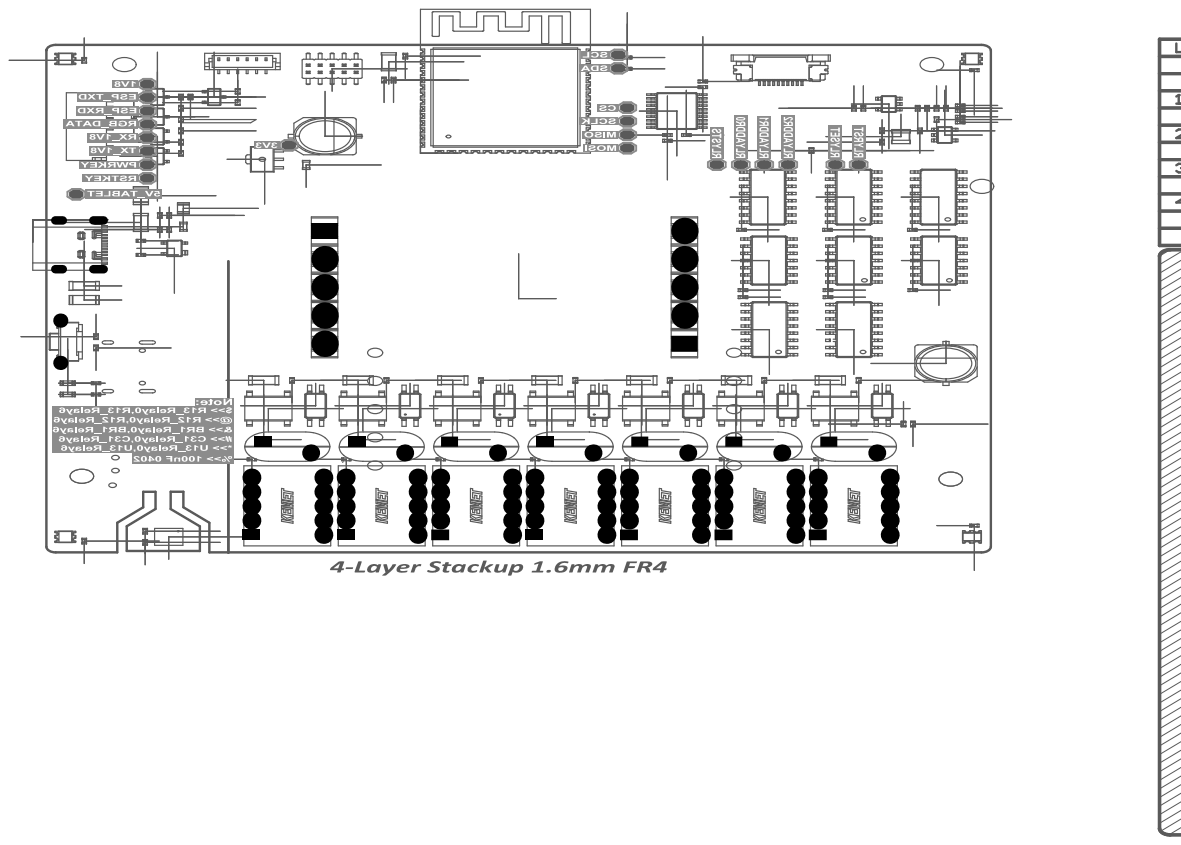
[picture p107: page 3]
