eSpark-Backup/ezlo-thermostat/Deliverables/Schematics/Assembly Drawings_Thermostat.pdf

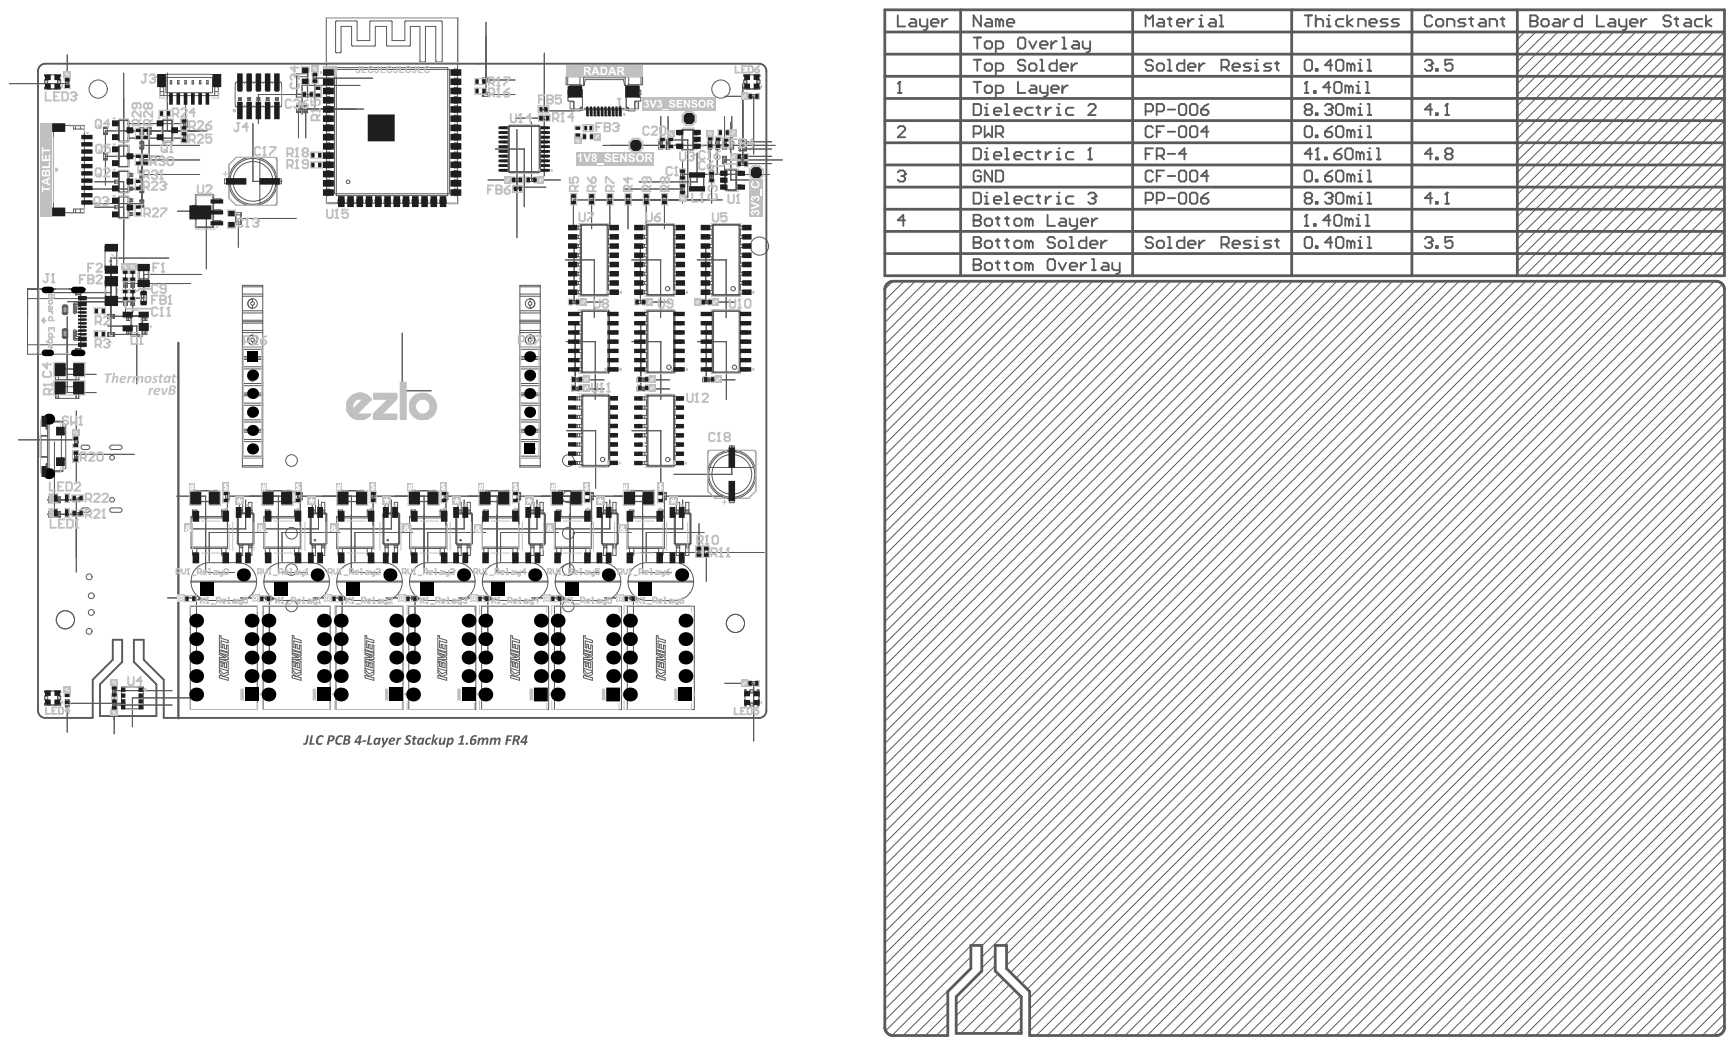
[picture p108: page 1]

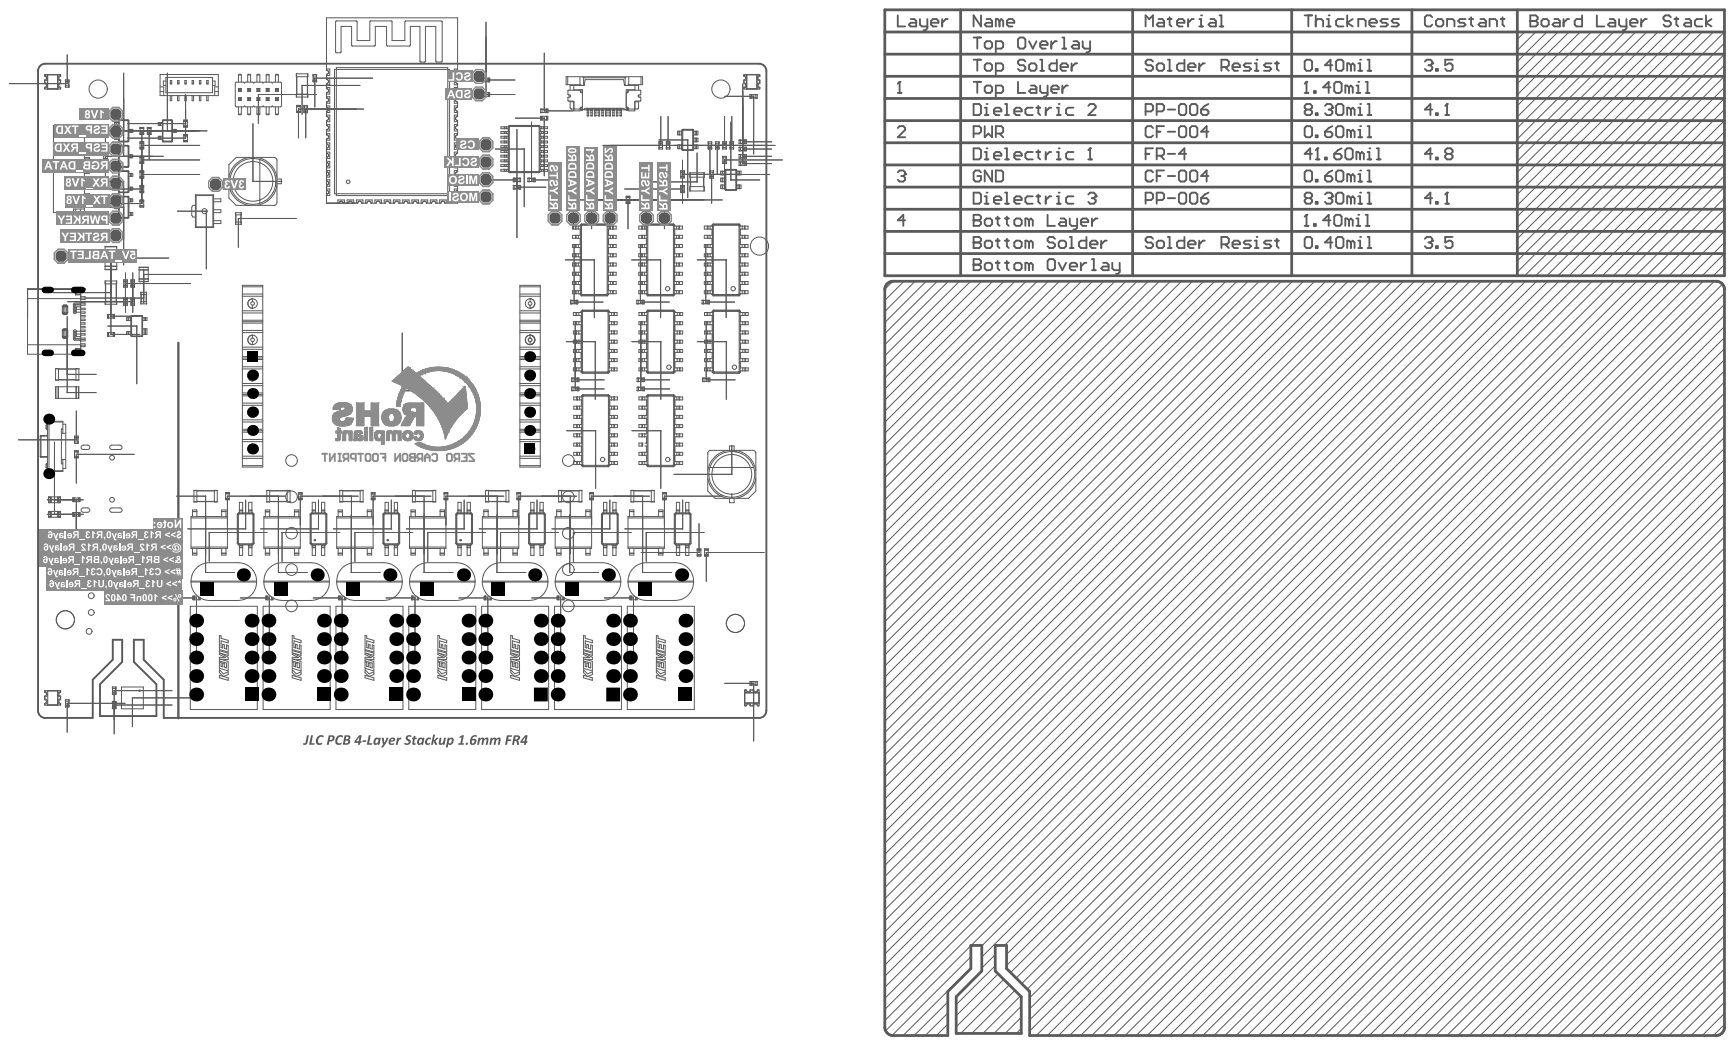
[picture p109: page 2]
