eSpark-Backup/ezlo-thermostat/Deliverables/Ezlo-Thermostat-v2.0-Advance/Schematics/Assembly Drawings.pdf

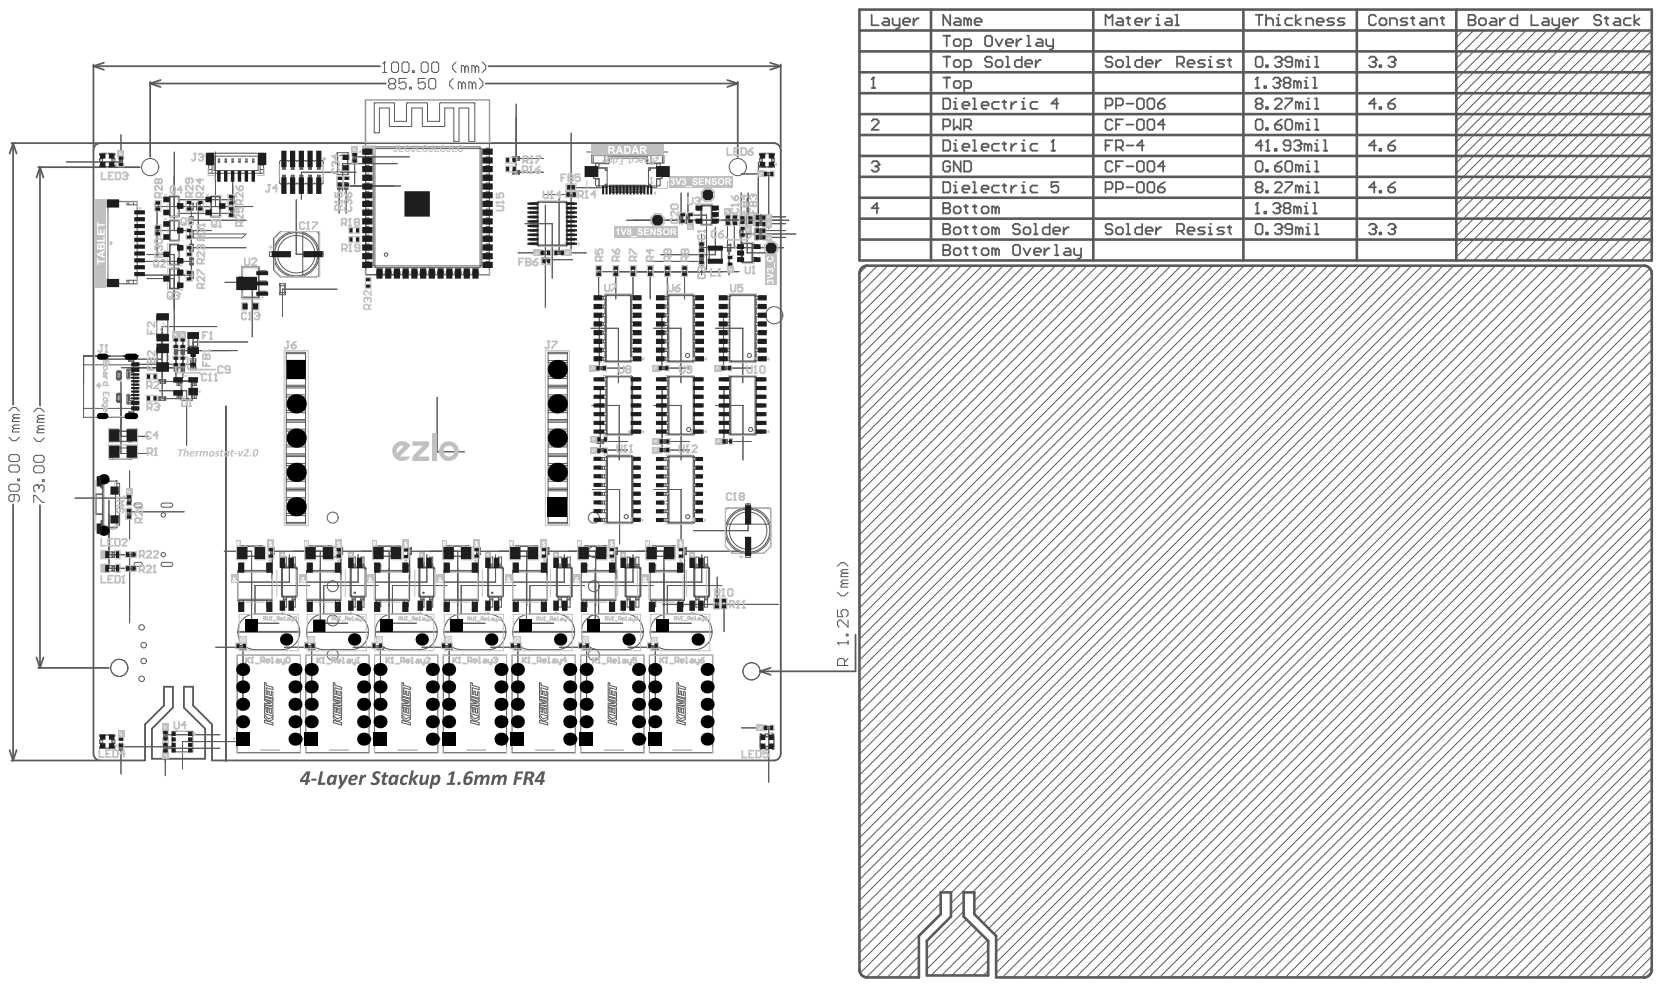
[picture p110: page 1]

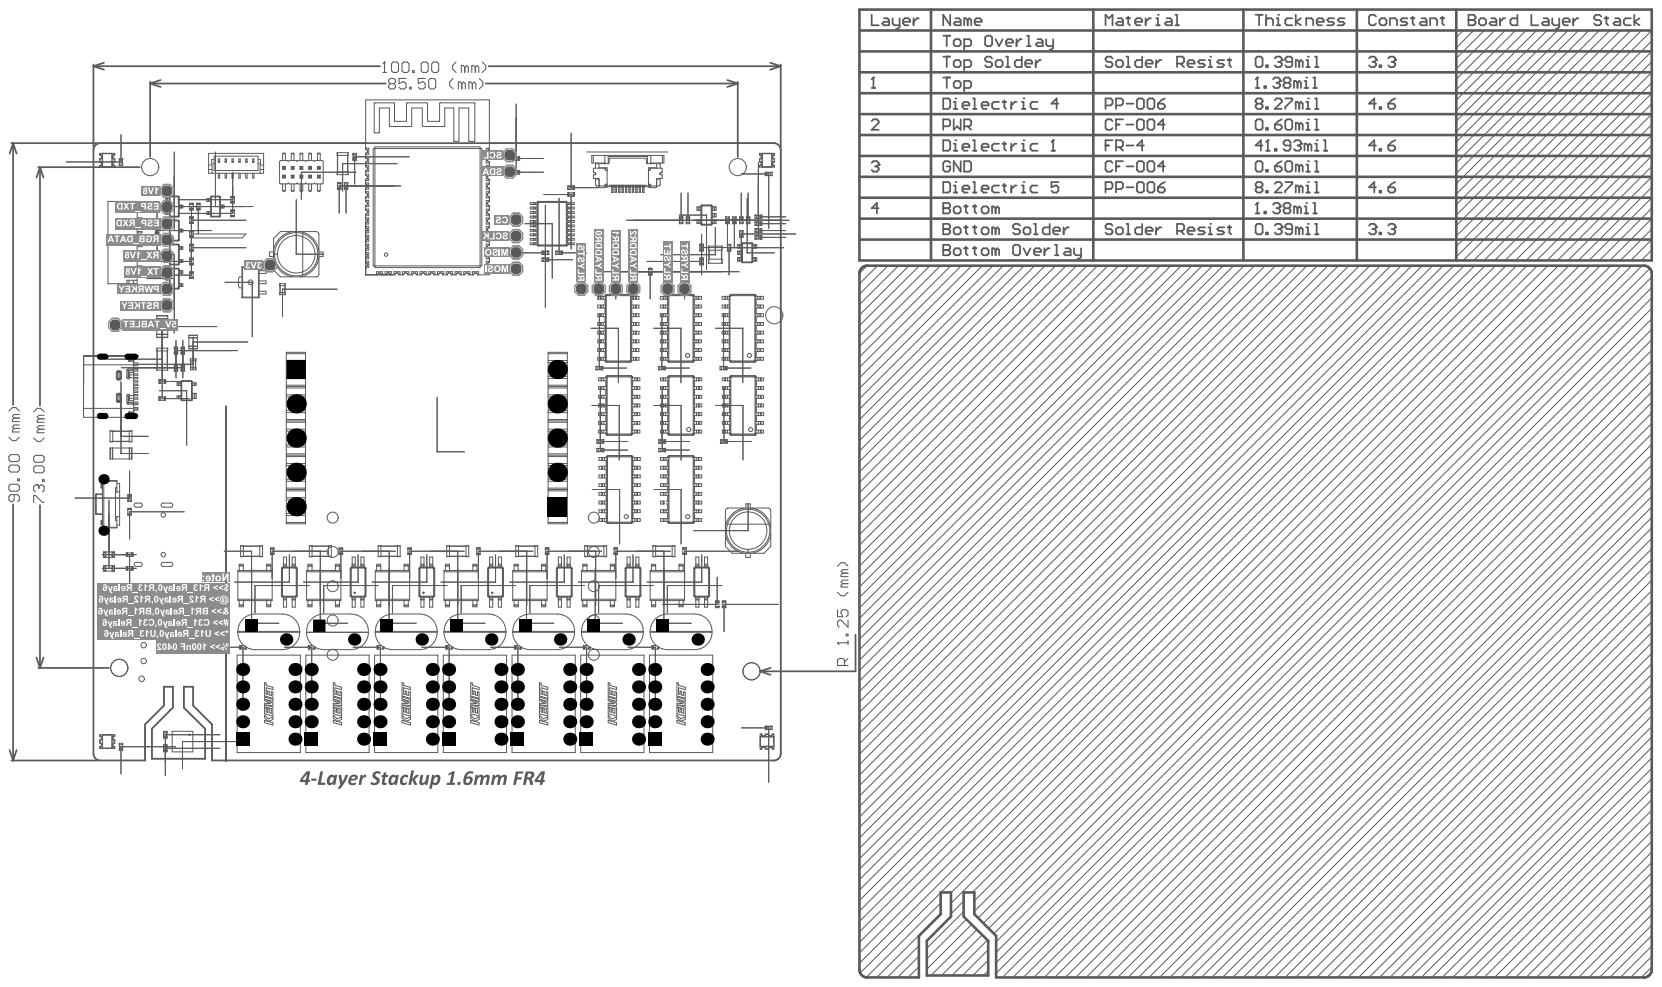
[picture p111: page 2]
