eSpark-Backup/ezlo-thermostat/Deliverables/Ezlo-Radar-Sensor-v2.0-Advance/Schematics/Assembly Drawings.pdf

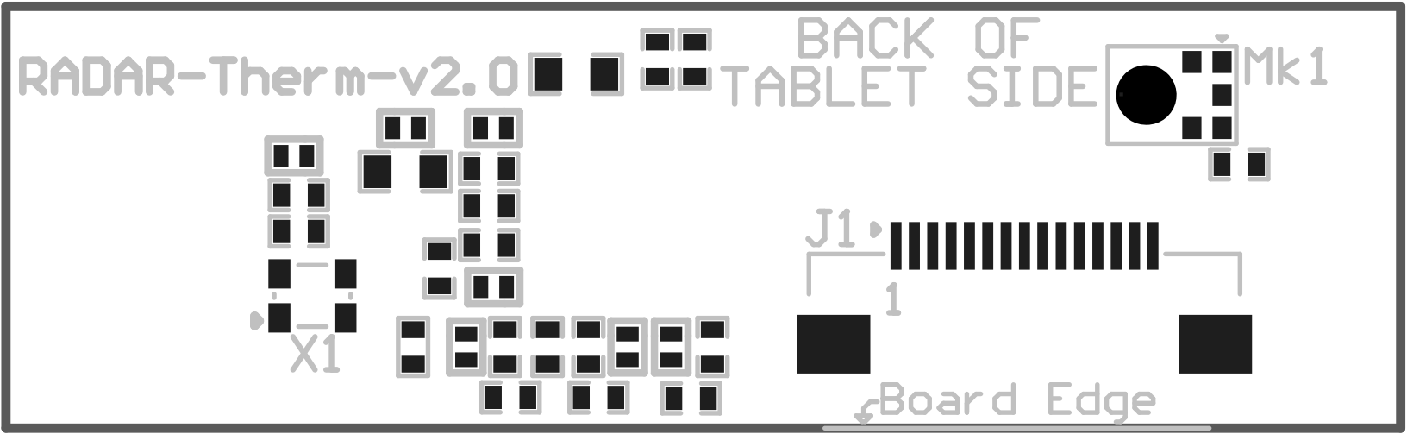
[picture p112: figure]
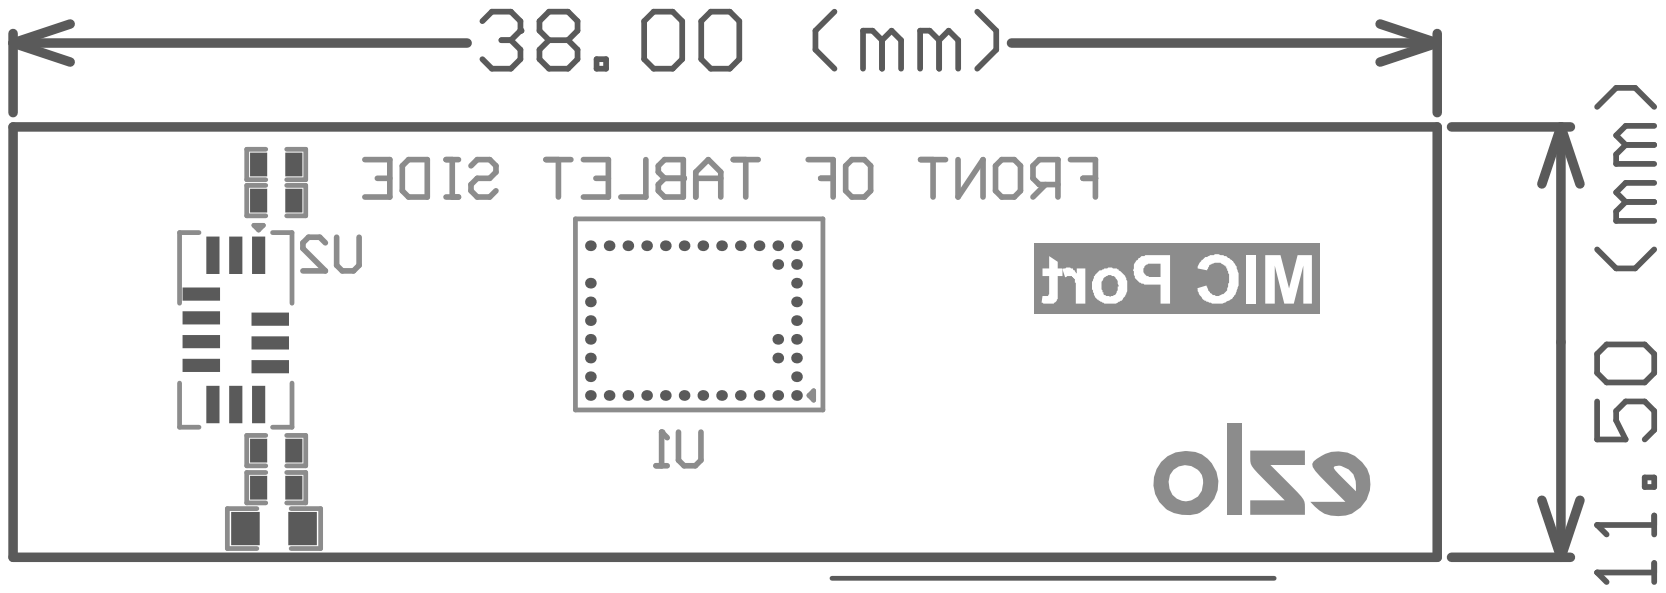
[picture p113: page 2]
