eSpark-Backup/ezlo-thermostat/(list of files, drawings)

Other design files:
Design Files/4-R-layer-PCB.PcbDoc
Design Files/ESP32-Sheet.SchDoc
Design Files/Ezlo-Radar-Sensor-v2.0-Advance/Ezlo-Radar-Sensor-v2.0-Advance.PrjPcb
Design Files/Ezlo-Radar-Sensor-v2.0-Advance/eZlo_Radar.PcbDoc
Design Files/Ezlo-Radar-Sensor-v2.0-Advance/Radar-Sensor.SchDoc
Design Files/ezlo-thermostat-advance.PrjPcb
Design Files/Ezlo-Thermostat-v2.0-Advance/ezlo-thermostat-advance-v2.0.PrjPcb
Design Files/Ezlo-Thermostat-v2.0-Advance/PCB-Thermostat.PcbDoc
Design Files/Ezlo-Thermostat-v2.0-Advance/Sensor-Sheet.SchDoc
Design Files/Ezlo-Thermostat-v2.0-Advance/Top-Sheet.SchDoc
Design Files/ezlo-thermostat.PrjPcb
Design Files/Level-Shifter-Sheet.SchDoc
Design Files/Miscellaneous-Sheet.SchDoc
Design Files/Output-Connection-Sheet.SchDoc
Design Files/Output-Sheet.SchDoc
Design Files/PCB-Thermostat.PcbDoc
Design Files/Power-Sheet.SchDoc
Design Files/Relay-Sheet.SchDoc
Design Files/Sensor-Sheet.SchDoc
Design Files/Sheet1.SchDoc
Design Files/Sheet2.SchDoc
Design Files/Sheet3.SchDoc
Design Files/Sheet4.SchDoc
Design Files/Sheet5.SchDoc
Design Files/Sheet6.SchDoc
Design Files/Thermostat-PCB.PcbDoc
Design Files/Top-Sheet.SchDoc
ezlo-thermostat/ezlo-thermostat.PrjPcb
ezlo-thermostat/Sheet1.SchDoc
ezlo-thermostat/Sheet2.SchDoc
ezlo-thermostat/Sheet4.SchDoc
ezlo-thermostat/Sheet5.SchDoc
OLD_PCB/PCB-Thermostat-Old.PcbDoc
