eSpark-Backup/ezlo-thermostat/docs/Client Original Design/Adv thermostat revB Kicad/adv thermostat.kicad_pcb

## KiCad design docs/Client Original Design/Adv thermostat revB Kicad/adv thermostat.kicad_pcb (2023-01-04)

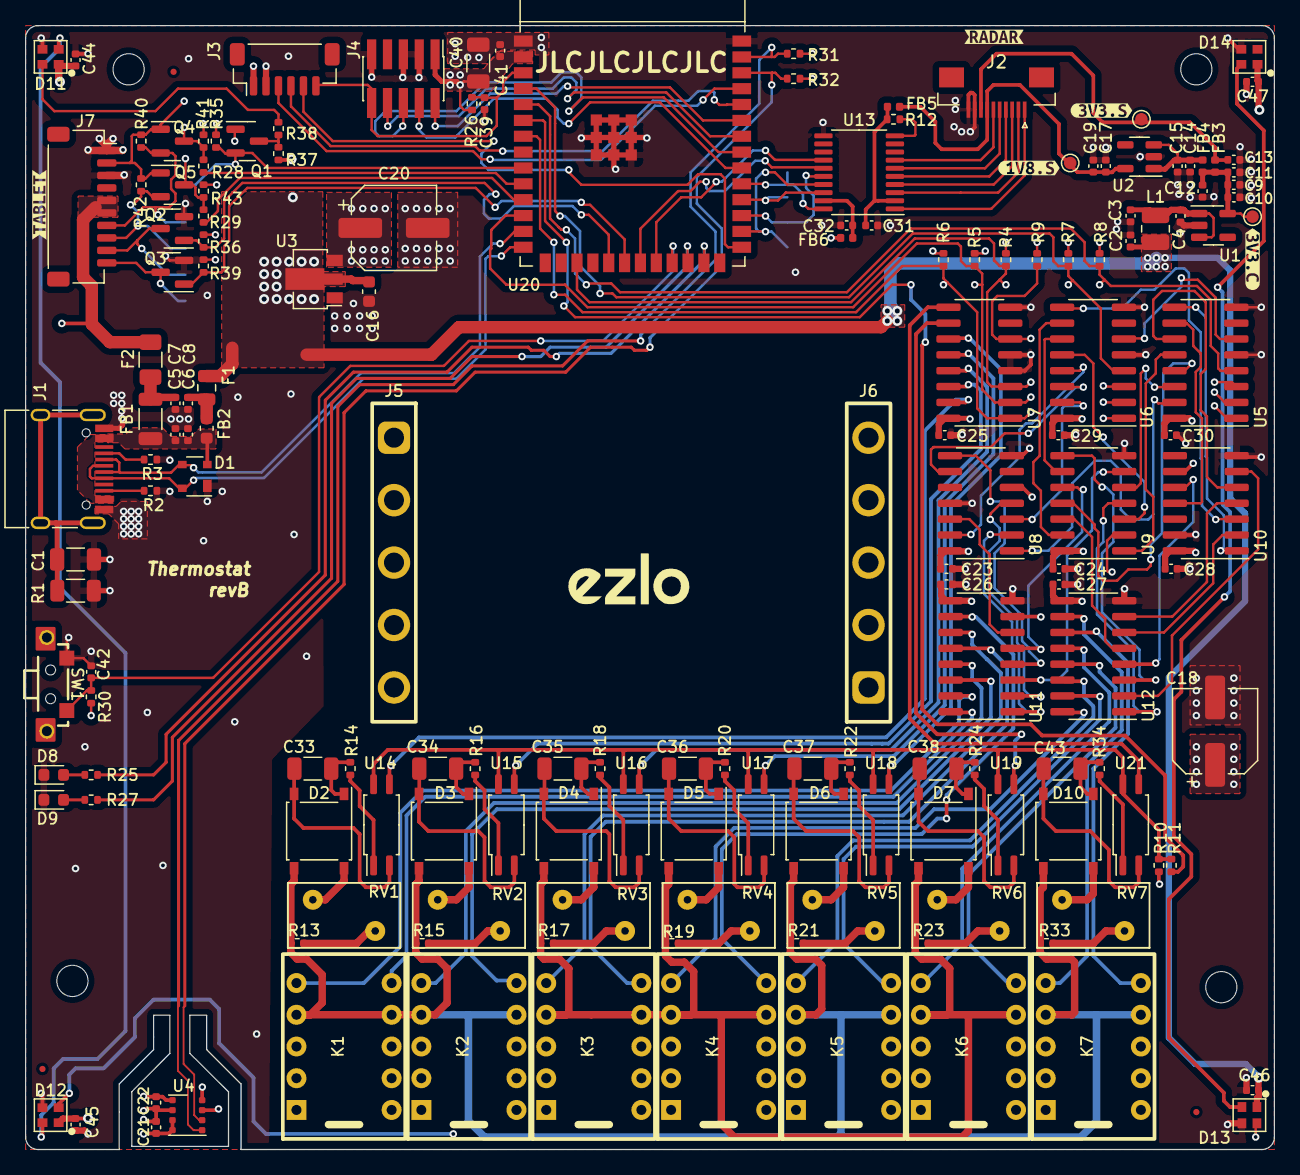
[picture p114: board adv thermostat.kicad_pcb from above]

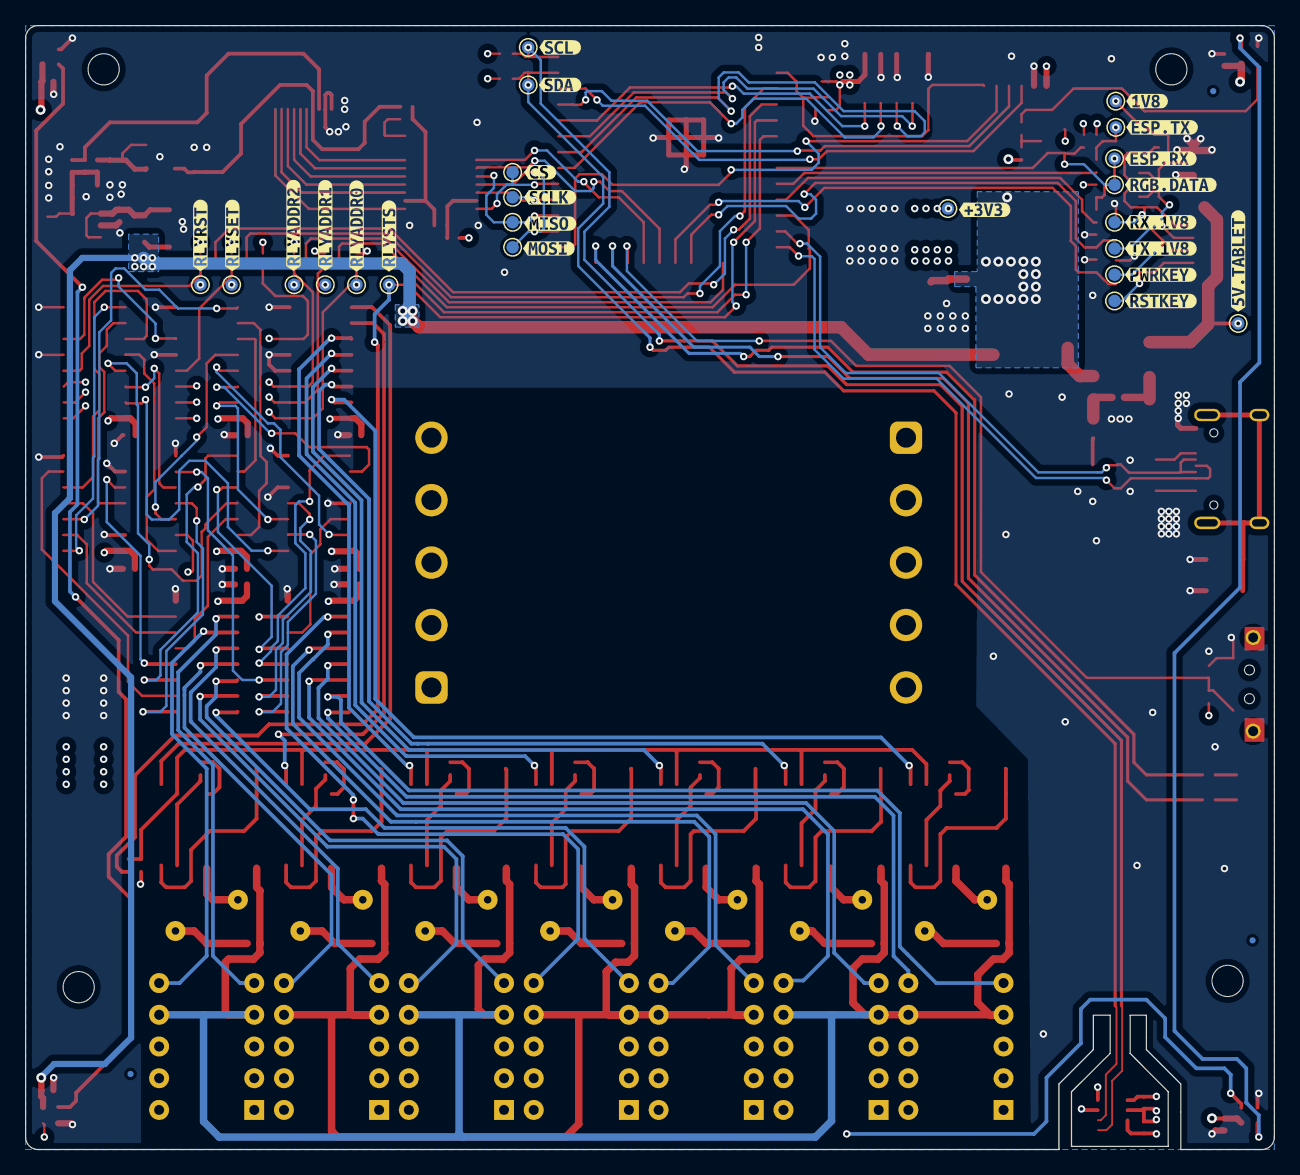
[picture p115: board adv thermostat.kicad_pcb from below]

Board: 4 copper layers, 100.0 x 90.0 mm, 224 parts (47 on the bottom side), 159 nets.

Parts:
C1: 4.7nF; C_1206_3216Metric
C2, C3, C10, C14, C19: 10uF; C_0402_1005Metric
C4, C7, C8, C9, C11, C12, C13, C15, C17, C21, C22, C23, C24, C25, C26, C27, C28, C29, C30, C31, C32, C41, C42, C44, C45, C46, C47: 0.1uF; C_0402_1005Metric
C5, C6: 0.01uF; C_0402_1005Metric
C16: 10uF; C_0603_1608Metric
C18, C20: 100uF; CP_Elec_6.3x5.8
C33, C34, C35, C36, C37, C38, C43: 0.22uF; C_1206_3216Metric
C39: 1uF; C_0402_1005Metric
C40: 22uF; C_1206_3216Metric
D1: SP0503BAHT; SOT-143
D2, D3, D4, D5, D6, D7, D10: ABS2; Diode_Bridge_Diotec_ABS
D8: LED_RED; LED_0603_1608Metric
D9: LED_GREEN; LED_0603_1608Metric
D11, D12, D13, D14: SK6812-EC20; sk6812-2020
F1: 1A; Fuse_0805_2012Metric
F2: 2A; Fuse_1206_3216Metric
FB1: BLM31PG121SN1L; L_1206_3216Metric
FB2: BLM18SG121TN1D; L_0603_1608Metric
FB3, FB4, FB5, FB6: BLM15PD121SN1B; L_0402_1005Metric
FID1, FID2, FID3, FID4, FID5, FID6: Fiducial; Fiducial_0.5mm_Mask1mm
H1, H2, H3, H4: MountingHole; MountingHole_2.5mm
J1: USB_C_Receptacle_USB2.0; USB_C_Receptacle_HRO_TYPE-C-31-M-12
J2: Conn_01x10; AFC01-S10FCC-00_1x10_P0.5mm_Horizontal
J3: VoltLink_target; VoltLink-vertical
J4: ESP32_JTAG_10; PinHeader_2x05_P1.27mm_Vertical_SMD
J5: Clamp-Terminal-A; PinHeader_1x05_P5.00mm_Vertical
J6: Clamp-Terminal-B; PinHeader_1x05_P5.00mm_Vertical
J7: Tablet_Conn_01x10; JST_SH_SM10B-SRSS-TB_1x10-1MP_P1.00mm_Horizontal
K1, K2, K3, K4, K5, K6, K7: EA2-3TNU
L1: 10uH; L_1008_2520Metric
Q1, Q2, Q3, Q4, Q5: Si2302CDS; SOT-23
R1: 1M; R_1206_3216Metric
R2, R3: 5K1; R_0402_1005Metric
R4, R5, R6, R7, R8, R9, R10, R26, R30, R36, R39: 220K; R_0402_1005Metric
R11: 47K; R_0402_1005Metric
R12: 0R; R_0402_1005Metric
R13, R15, R17, R19, R21, R23, R33: 47R; R_0402_1005Metric
R14, R16, R18, R20, R22, R24, R34: 100K; R_0402_1005Metric
R25, R27, R38: 1K; R_0402_1005Metric
R28, R29: 22R; R_0402_1005Metric
R31, R32: 4K7; R_0402_1005Metric
R35, R37, R40, R41, R42, R43: 10K; R_0402_1005Metric
RV1, RV2, RV3, RV4, RV5, RV6, RV7: ERZ-V07D680; RV_Disc_D9mm_W5.2mm_P5mm
SW1: USER; Switch_YTS-B003-2A
TP1: 3V3_C; TestPoint_Pad_D1.0mm
TP2: 3V3_S; TestPoint_Pad_D1.0mm
TP3: 1V8_S; TestPoint_Pad_D1.0mm
TP4: 3V3; TestPoint_Pad_D1.0mm
TP5: ADDR0; TestPoint_Pad_D1.0mm
TP6: ADDR1; TestPoint_Pad_D1.0mm
TP7: ADDR2; TestPoint_Pad_D1.0mm
TP8: RSET; TestPoint_Pad_D1.0mm
TP9: RRST; TestPoint_Pad_D1.0mm
TP10: RSTS; TestPoint_Pad_D1.0mm
TP11: SCL; TestPoint_Pad_D1.0mm
TP12: SDA; TestPoint_Pad_D1.0mm
TP13: MOSI; TestPoint_Pad_D1.0mm
TP14: MISO; TestPoint_Pad_D1.0mm
TP15: SCLK; TestPoint_Pad_D1.0mm
TP16: CS; TestPoint_Pad_D1.0mm
TP17: RGB; TestPoint_Pad_D1.0mm
TP18: 5V_TABLET; TestPoint_Pad_D1.0mm
TP19: 1V8; TestPoint_Pad_D1.0mm
TP20: PWRKEY; TestPoint_Pad_D1.0mm
TP21: RSTKEY; TestPoint_Pad_D1.0mm
TP22: RXA; TestPoint_Pad_D1.0mm
TP23: RXB; TestPoint_Pad_D1.0mm
TP24: TXA; TestPoint_Pad_D1.0mm
TP25: TXB; TestPoint_Pad_D1.0mm
U1: XC6228D332VR-G; SOT-23-5
U2: XC6228D182VR-G; SOT-23-5
U3: LR1107; SOT-89-3
U4: BME680; Bosch_LGA-8_3x3mm_P0.8mm_ClockwisePinNumbering
U5, U6, U7: 74LVC138A; SOIC-16_3.9x9.9mm_P1.27mm
U8, U9, U10: 74LV14; SOIC-14_3.9x8.7mm_P1.27mm
U11, U12: ULN2003A; SOIC-16_3.9x9.9mm_P1.27mm
U13: TXS0108EPWR; TSSOP-20_4.4x6.5mm_P0.65mm
U14, U15, U16, U17, U18, U19, U21: OR-3H7B-TP-G; SOIC-4_4.55x2.6mm_P1.27mm
U20: ESP32-S3-WROOM-1
V1: EZLO_LOGO; Logo Ezlo_M
kibuzzard-6319A1D4: G***; kibuzzard-6319A1D4
kibuzzard-6319A1F9: G***; kibuzzard-6319A1F9
kibuzzard-6319A2D8: G***; kibuzzard-6319A2D8
kibuzzard-6319A18B: G***; kibuzzard-6319A18B
kibuzzard-6319A20C: G***; kibuzzard-6319A20C
kibuzzard-6319A21E: G***; kibuzzard-6319A21E
kibuzzard-6319A206: G***; kibuzzard-6319A206
kibuzzard-6319A232: G***; kibuzzard-6319A232
kibuzzard-6319A321: G***; kibuzzard-6319A321
kibuzzard-6319AA0F: G***; kibuzzard-6319AA0F
kibuzzard-6319AA3B: G***; kibuzzard-6319AA3B
kibuzzard-6319AA4A: G***; kibuzzard-6319AA4A
kibuzzard-6319AA9A: G***; kibuzzard-6319AA9A
kibuzzard-6319AA19: G***; kibuzzard-6319AA19
kibuzzard-6319AA29: G***; kibuzzard-6319AA29
kibuzzard-6319AA54: G***; kibuzzard-6319AA54
kibuzzard-6319AA76: G***; kibuzzard-6319AA76
kibuzzard-6319AAA5: G***; kibuzzard-6319AAA5
kibuzzard-6319AAAF: G***; kibuzzard-6319AAAF
kibuzzard-6319AABA: G***; kibuzzard-6319AABA
kibuzzard-6319AAC1: G***; kibuzzard-6319AAC1
kibuzzard-63199E43: G***; kibuzzard-63199E43
kibuzzard-63199EB3: G***; kibuzzard-63199EB3
kibuzzard-63199ED2: G***; kibuzzard-63199ED2
kibuzzard-63199EEF: G***; kibuzzard-63199EEF
kibuzzard-63199F83: G***; kibuzzard-63199F83
kibuzzard-639863C7: G***; kibuzzard-639863C7

Connections:
1V8_SENSOR: C17.1, C19.1, FB5.2, J2.7, TP3.1, U2.5 (VOUT)
3V3_SENSOR: C13.1, FB3.2, J2.8, TP2.1
+1V8: J7.2, Q4.1 (G), Q5.1 (G), R40.1, R42.1, TP19.1
+3V3: C18.1, C20.1, C21.2, C22.1, C23.1, C24.1, C25.1, C26.1, C27.1, C28.1, C29.1, C30.1, C40.2, C41.2, FB6.1, J3.1 (3V3), J4.1 (VTref), K1.1, K1.10, K2.1, K2.10, K3.1, K3.10, K4.1, K4.10, K5.1, K5.10, K6.1, K6.10, K7.1, K7.10, Q1.1 (G), R4.1, R5.1, R6.1, R7.1, R8.1, R9.1, R10.1, R26.2, R30.2, R31.2, R32.2, R35.1, R41.1, R43.1, TP4.1, U3.3 (VOUT), U4.2 (CSB), U4.5 (SDO), U4.6 (VDDIO), U4.8 (VDD), U5.16 (VCC), U6.16 (VCC), U7.16 (VCC), U8.14 (3.3V), U9.14 (3.3V), U10.14 (3.3V), U11.9 (COM), U12.9 (COM), U20.2 (3V3)
+5V: C2.1, C16.1, C44.1, C45.1, C46.1, C47.1, D11.1 (VDD), D12.1 (VDD), D13.1 (VDD), D14.1 (VDD), F1.1, L1.1, R37.1, U3.2 (VIN)
/ESP32/CS: TP16.1, U13.20 (B1), U20.31 (GPIO38)
/ESP32/EN: C39.1, J3.6 (EN), J4.10 (~RESET), R26.1, U20.3 (EN)
/ESP32/ESP_RXD: Q5.3 (D), R29.1, R43.2, TP25.1
/ESP32/ESP_TXD: Q4.3 (D), R28.1, R41.2, TP23.1
/ESP32/GPIO11: Q2.1 (G), R36.1, U20.19 (GPIO11)
/ESP32/GPIO12: Q3.1 (G), R39.1, U20.20 (GPIO12)
/ESP32/GPIO16: Q1.2 (S), R35.2, TP17.1, U20.9 (GPIO16)
/ESP32/GPIO21: C42.1, R30.1, SW1.1, U20.23 (GPIO21)
/ESP32/GPIO47: R27.1, U20.24 (GPIO47)
/ESP32/GPIO48: R25.1, U20.25 (GPIO48)
/ESP32/IO0: J3.5 (IO0), U20.27 (GPIO0/BOOT)
/ESP32/MISO: TP14.1, U13.16 (B4), U20.29 (GPIO36)
/ESP32/MOSI: TP13.1, U13.17 (B3), U20.28 (GPIO35)
/ESP32/RXD: J3.4 (RXD), U20.36 (U0RXD/GPIO44)
/ESP32/SCL: R31.1, TP11.1, U4.4 (SCK), U20.39 (GPIO1)
/ESP32/SCLK: TP15.1, U13.18 (B2), U20.30 (GPIO37)
/ESP32/SDA: R32.1, TP12.1, U4.3 (SDI), U20.38 (GPIO2)
/ESP32/TCK: J4.4 (TCK), U20.32 (TCK/GPIO39)
/ESP32/TDI: J4.8 (TDI), U20.34 (TDI/GPIO41)
/ESP32/TDO: J4.6 (TDO), U20.33 (TDO/GPIO40)
/ESP32/TMS: J4.2 (TMS), U20.35 (TMS/GPIO42)
/ESP32/TXD: J3.3 (TXD), U20.37 (U0TXD/GPIO43)
/Level shifter/A1: J2.1, U13.1 (A1)
/Level shifter/A2: J2.2, U13.3 (A2)
/Level shifter/A3: J2.3, U13.4 (A3)
/Level shifter/A4: J2.4, U13.5 (A4)
/Level shifter/A5: J2.5, U13.6 (A5)
/Level shifter/A6: J2.6, U13.7 (A6)
/Level shifter/B5: U13.15 (B5), U20.21 (GPIO13)
/Level shifter/B6: U13.14 (B6), U20.22 (GPIO14)
/Level shifter/SPI_OE: R12.1, U13.10 (OE)
/Level shifter/VCCA: C31.1, FB5.1, R12.2, U13.2 (VCCA)
/Level shifter/VCCB: C32.1, FB6.2, U13.19 (VCCB)
/Output/24VAC: D2.3, D3.3, D6.3, D10.3, J5.4, K1.4 (O1), K1.7 (O2), K2.4 (O1), K2.7 (O2), K5.4 (O1), K5.7 (O2), K7.4 (O1), K7.7 (O2), R13.2, R15.2, R21.2, R33.2
/Output/E3: R9.2, U5.6 (E3), U6.6 (E3), U7.6 (E3)
/Output/RELAYSTSN0: U7.15 (O0), U14.3
/Output/RELAYSTSN1: U7.14 (O1), U15.3
/Output/RELAYSTSN2: U7.13 (O2), U16.3
/Output/RELAYSTSN3: U7.12 (O3), U17.3
/Output/RELAYSTSN4: U7.11 (O4), U18.3
/Output/RELAYSTSN5: U7.10 (O5), U19.3
/Output/RELAYSTSN6: U7.9 (O6), U21.3
/Output/RH: D4.3, D5.3, D7.3, J5.5, K3.4 (O1), K3.7 (O2), K4.4 (O1), K4.7 (O2), K6.4 (O1), K6.7 (O2), R17.2, R19.2, R23.2
/Output/RLYADDR0: R6.2, TP5.1, U5.1 (A0), U6.1 (A0), U7.1 (A0), U20.7 (GPIO7)
/Output/RLYADDR1: R5.2, TP6.1, U5.2 (A1), U6.2 (A1), U7.2 (A1), U20.12 (GPIO8)
/Output/RLYADDR2: R4.2, TP7.1, U5.3 (A2), U6.3 (A2), U7.3 (A2), U20.17 (GPIO9)
/Output/RLYR0: K1.6, U11.16 (O1)
/Output/RLYR1: K2.6, U11.14 (O3)
/Output/RLYR2: K3.6, U11.12 (O5)
/Output/RLYR3: K4.6, U11.10 (O7)
/Output/RLYR4: K5.6, U12.15 (O2)
/Output/RLYR5: K6.6, U12.13 (O4)
/Output/RLYR6: K7.6, U12.11 (O6)
/Output/RLYRST: R8.2, TP9.1, U5.4 (E1), U20.5 (GPIO5)
/Output/RLYRSTN0: U5.15 (O0), U8.1
/Output/RLYRSTN1: U5.14 (O1), U9.5
/Output/RLYRSTN2: U5.13 (O2), U9.11
/Output/RLYRSTN3: U5.12 (O3), U9.1
/Output/RLYRSTN4: U5.11 (O4), U10.5
/Output/RLYRSTN5: U5.10 (O5), U10.11
/Output/RLYRSTN6: U5.9 (O6), U10.1
/Output/RLYS0: K1.5, U11.15 (O2)
/Output/RLYS1: K2.5, U11.13 (O4)
/Output/RLYS2: K3.5, U11.11 (O6)
/Output/RLYS3: K4.5, U12.16 (O1)
/Output/RLYS4: K5.5, U12.14 (O3)
/Output/RLYS5: K6.5, U12.12 (O5)
/Output/RLYS6: K7.5, U12.10 (O7)
/Output/RLYSET: R7.2, TP8.1, U6.4 (E1), U20.4 (GPIO4)
/Output/RLYSETN0: U6.15 (O0), U8.3
/Output/RLYSETN1: U6.14 (O1), U8.9
/Output/RLYSETN2: U6.13 (O2), U8.13
/Output/RLYSETN3: U6.12 (O3), U9.3
/Output/RLYSETN4: U6.11 (O4), U9.9
/Output/RLYSETN5: U6.10 (O5), U9.13
/Output/RLYSETN6: U6.9 (O6), U10.3
/Output/RLYSTS: R11.2, TP10.1, U20.6 (GPIO6)
/Output/RLY_R0: U8.2, U11.1 (I1)
/Output/RLY_R1: U9.6, U11.3 (I3)
/Output/RLY_R2: U9.10, U11.5 (I5)
/Output/RLY_R3: U9.2, U11.7 (I7)
/Output/RLY_R4: U10.6, U12.2 (I2)
/Output/RLY_R5: U10.10, U12.4 (I4)
/Output/RLY_R6: U10.2, U12.6 (I6)
/Output/RLY_S0: U8.4, U11.2 (I2)
/Output/RLY_S1: U8.8, U11.4 (I4)
/Output/RLY_S2: U8.12, U11.6 (I6)
/Output/RLY_S3: U9.4, U12.1 (I1)
/Output/RLY_S4: U9.8, U12.3 (I3)
/Output/RLY_S5: U9.12, U12.5 (I5)
/Output/RLY_S6: U10.4, U12.7 (I7)
/Output/relay0/COM: J6.5, K1.2 (C1), K1.9 (C2), K2.2 (C1), K2.9 (C2), K3.2 (C1), K3.9 (C2), K4.2 (C1), K4.9 (C2), K5.2 (C1), K5.9 (C2), K6.2 (C1), K6.9 (C2), K7.2 (C1), K7.9 (C2)
/Output/relay0/RELAY_O: D2.4, J5.1, K1.3 (P1), K1.8 (P2), RV1.1
/Output/relay0/RELAY_STS: R10.2, R11.1, U14.4, U15.4, U16.4, U17.4, U18.4, U19.4, U21.4
/Output/relay1/RELAY_O: D3.4, J5.2, K2.3 (P1), K2.8 (P2), RV2.1
/Output/relay2/RELAY_O: D4.4, J5.3, K3.3 (P1), K3.8 (P2), RV3.1
/Output/relay3/RELAY_O: D5.4, J6.1, K4.3 (P1), K4.8 (P2), RV4.1
/Output/relay4/RELAY_O: D6.4, J6.2, K5.3 (P1), K5.8 (P2), RV5.1
/Output/relay5/RELAY_O: D7.4, J6.3, K6.3 (P1), K6.8 (P2), RV6.1
/Output/relay6/RELAY_O: D10.4, J6.4, K7.3 (P1), K7.8 (P2), RV7.1
/Power-Interface/3V3_CLEAN: C9.1, C10.1, C11.1, C12.1, FB3.1, FB4.1, TP1.1, U1.5 (VOUT)
/Power-Interface/3V3_LDO1V8: C14.1, C15.1, FB4.2, U2.1 (VIN), U2.3 (CE)
/Power-Interface/5V_CLEAN: C3.1, C4.1, L1.2, U1.1 (VIN), U1.3 (CE)
/Power-Interface/CC1: J1.A5 (CC1), R3.1
/Power-Interface/CC2: J1.B5 (CC2), R2.1
/Power-Interface/USB_D_N: D1.3 (K), J1.A7 (D-), J1.B7 (D-), U20.13 (GPIO19/USB_D-)
/Power-Interface/USB_D_P: D1.4 (K), J1.A6 (D+), J1.B6 (D+), U20.14 (GPIO20/USB_D+)
/Power-Interface/VBUS: C5.1, C6.1, D1.2 (K), FB1.1, FB2.1, J1.A4 (VBUS), J1.A9 (VBUS), J1.B4 (VBUS), J1.B9 (VBUS)
/misc/5V_TABLET: F2.1, J7.5, J7.6, TP18.1
/misc/DIN1: D11.4 (DIN), R38.2
/misc/DIN2: D11.2 (DOUT), D12.4 (DIN)
/misc/DIN3: D12.2 (DOUT), D13.4 (DIN)
/misc/DIN4: D13.2 (DOUT), D14.4 (DIN)
GND: C1.2, C2.2, C3.2, C4.2, C5.2, C6.2, C7.2, C8.2, C9.2, C10.2, C11.2, C12.2, C13.2, C14.2, C15.2, C16.2, C17.2, C18.2, C19.2, C20.2, C21.1, C22.2, C23.2, C24.2, C25.2, C26.2, C27.2, C28.2, C29.2, C30.2, C31.2, C32.2, C39.2, C40.1, C41.1, C42.2, C44.2, C45.2, C46.2, C47.2, D1.1 (A), D8.1 (K), D9.1 (K), D11.3 (VSS), D12.3 (VSS), D13.3 (VSS), D14.3 (VSS), J1.A1 (GND), J1.A12 (GND), J1.B1 (GND), J1.B12 (GND), J2.9, J2.10, J3.2 (GND), J4.3 (GND), J4.5 (GND), J4.9 (GNDDetect), J7.1, J7.3, Q2.2 (S), Q3.2 (S), R1.2, R2.2, R3.2, R36.2, R39.2, SW1.2, U1.2 (GND), U2.2 (GND), U3.1 (GND), U4.1 (GND), U4.7 (GND), U5.5 (E2), U5.8 (GND), U6.5 (E2), U6.8 (GND), U7.4 (E1), U7.5 (E2), U7.8 (GND), U8.5, U8.7 (GND), U8.11, U9.7 (GND), U10.7 (GND), U10.9, U10.13, U11.8 (GND), U12.8 (GND), U13.11 (GND), U20.1 (GND), U20.40 (GND), U20.41 (GND)
unnamed: C1.1, J1.S1 (SHIELD), R1.1
unnamed: C7.1, F2.2, FB1.2
unnamed: C8.1, F1.2, FB2.2
unnamed: C33.1, D2.1 (+), R14.1
unnamed: C33.2, D2.2 (-), U14.2
unnamed: C34.1, D3.1 (+), R16.1
unnamed: C34.2, D3.2 (-), U15.2
unnamed: C35.1, D4.1 (+), R18.1
unnamed: C35.2, D4.2 (-), U16.2
unnamed: C36.1, D5.1 (+), R20.1
unnamed: C36.2, D5.2 (-), U17.2
unnamed: C37.1, D6.1 (+), R22.1
unnamed: C37.2, D6.2 (-), U18.2
unnamed: C38.1, D7.1 (+), R24.1
unnamed: C38.2, D7.2 (-), U19.2
unnamed: C43.1, D10.1 (+), R34.1
unnamed: C43.2, D10.2 (-), U21.2
unnamed: D8.2 (A), R25.2
unnamed: D9.2 (A), R27.2
unnamed: Q1.3 (D), R37.2, R38.1
unnamed: R13.1, RV1.2
unnamed: R14.2, U14.1
unnamed: R15.1, RV2.2
unnamed: R16.2, U15.1
unnamed: R17.1, RV3.2
unnamed: R18.2, U16.1
unnamed: R19.1, RV4.2
unnamed: R20.2, U17.1
unnamed: R21.1, RV5.2
unnamed: R22.2, U18.1
unnamed: R23.1, RV6.2
unnamed: R24.2, U19.1
unnamed: R28.2, U20.10 (GPIO17)
unnamed: R29.2, U20.11 (GPIO18)
unnamed: R33.1, RV7.2
unnamed: R34.2, U21.1
PWRKEY: J7.9, Q2.3 (D), TP20.1
RSTKEY: J7.10, Q3.3 (D), TP21.1
RX_1V8: J7.7, Q4.2 (S), R40.2, TP22.1
TX_1V8: J7.8, Q5.2 (S), R42.2, TP24.1
