eSpark-Backup/ezlo-thermostat/(commit log)

2023-01-02 #6 PCB parts Placement completed, Routing in Progress
2023-01-13 @MarsVirgo KICAD Files Add kr di han Repo me.
2023-01-16 #9 Footprint confirmed#10 Fresh Deliverables generated
2023-01-16 #9 changes done after footprint changes of relay and varistor #10 fresh deliverables generated
2023-01-17 #14 Clamp Terminal added. Capacitors adjusted
2023-01-19 Schematic reformatting
2023-01-19 Old PCB removed
2023-06-27 #16 J2 Connector changed - MIC - Gesture connections added
2023-06-27 #16 MIC - Gesture sensor added - Radar Advance
2023-06-27 #16 J2 Footprint updated - 3.3V Regulator changed
2023-06-27 #16 FPC connector footprint updated - Radar
2023-07-03 #7 eSpark BOM updated.
2023-07-04 #18 Matched PCB Stackup as in Client's KiCad file.
2023-07-19 #22 U2 updated in PCB
2023-07-25 #19 Latest step file for Main PCB.
2023-07-25 #18 #22 Latest Step file of Radar PCB
2023-07-25 #25 Radar Client BOM added
2023-07-25 #25 Thermostate BOM Added
2023-07-26 #18 #22 Crystal X1 footprint updated
2023-07-26 #25 Peripheral Added in BOM
2023-07-26 #19 #24 U14 (TSSOP-20) Footprint updated (Pads size increased).
